ENSEA-Makerspace/FabOS/Stage/Drive/Images/Tableau/20260617_162901.jpg

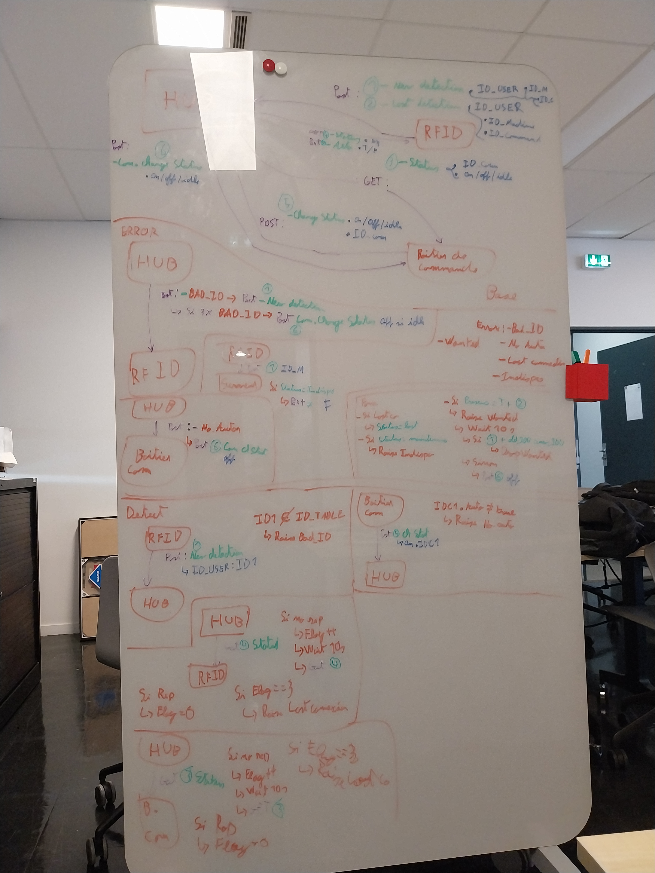
Stage/Drive/Images/Tableau/20260617_162901.jpg
