ENSEA-Makerspace/FabOS/Stage/Drive/Images/Tableau/20260624_091640.jpg

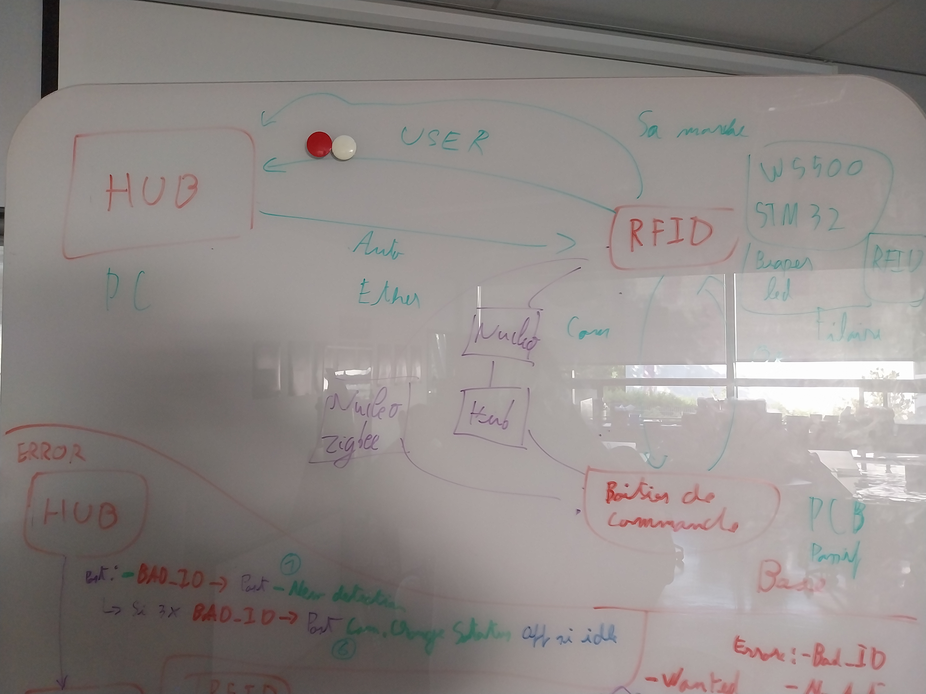
Stage/Drive/Images/Tableau/20260624_091640.jpg
