ENSEA-Makerspace/FabOS/Stage/Drive/intégration-d-une-base-de-données-sql-dans-une-api-php.md

/home/drault/Documents/1G/Stage/FabOS/intégration-d-une-base-de-données-sql-dans-une-api-php.md
