ENSEA-Makerspace/FabOS/FabApp/public/images/machines/demo/CREDITS.md

# Photos de démonstration — crédits

Images sous licence libre, Wikimedia Commons, redimensionnées (1200 px) par Wikimedia.

- `bambu-x1c.jpg` — « Bambu Lab X1 Carbon with AMS module (cropped).jpg », Benlisquare, CC BY-SA 4.0 — https://commons.wikimedia.org/wiki/File:Bambu_Lab_X1_Carbon_with_AMS_module_(cropped).jpg
- `creality-k1.jpg` — « Creality K1C addons.jpg », Mortymore, CC BY 2.0 — https://commons.wikimedia.org/wiki/File:Creality_K1C_addons.jpg
- `presse-a-chaud.jpg` — « Heat press for fabirc screen printing.jpg », Scrud123, CC BY-SA 3.0 — https://commons.wikimedia.org/wiki/File:Heat_press_for_fabirc_screen_printing.jpg
- `station-soudure.jpg` — « Soldering Station 375A+.jpg », Leisto, CC BY-SA 4.0 — https://commons.wikimedia.org/wiki/File:Soldering_Station_375A%2B.jpg
