ENSEA-Makerspace/FabOS/FabApp/docs/references/coordination/README.md

# FabOS — référentiel Coordination et confiance

Complément aux packs Espaces, Utilisateurs, Formations, Équipement et passe globale. Revue et maquettes seulement.

1. `01-calendrier.png` — calendrier multi-ressources filtrable en un clic.
2. `02-rendez-vous-personne.png` — prise de rendez-vous avec un formateur/agent.
3. `03-groupes.png` — groupes et droits collectifs lisibles.
4. `04-mon-badge.png` — badge membre sans exposition d’identifiant sensible.
5. `05-recherche.png` — recherche globale, résultats par type et navigation rapide.
6. `06-preferences-email.png` — préférences e-mail courtes, compréhensibles et sans dark pattern.

Les règles et prompt d’implémentation figurent dans `REVIEW.md`.
