ENSEA-Makerspace/FabOS/FabApp/docs/references/finalsurface/README.md

# FabOS — surfaces finales et garde-fous

1. `01-accueil-configurable.png` — une homepage utile, choisie et composée depuis Design.
2. `02-acces-exceptionnels.png` — accès temporaire explicitement limité, motivé et audité.
3. `03-rapports.png` — rapports qui conduisent vers une action.
4. `04-recuperation-compte.png` — récupération de compte courte et non divulguante.

Voir `REVIEW.md` et le plan maître des références pour la suite d’implémentation.
