ENSEA-Makerspace/FabOS/FabApp/docs/references/productwide/README.md

# FabOS — référentiel global des parcours restants

Ce pack complète les référentiels Formation, Équipement, Espaces et Utilisateurs. Il est de conception uniquement et ne modifie pas FabOS.

## Maquettes

1. `01-evenements.png` — découvrir, s’inscrire, retrouver billet et inscription.
2. `02-prets.png` — circulation de l’objet, fiche cliquable et retour.
3. `03-materiaux-equipement.png` — stock relié à l’équipement et aux machines.
4. `04-maintenance.png` — file d’intervention avec lien machine.
5. `05-configuration.png` — réglages comme point d’entrée cohérent.
6. `06-creations.png` — communauté sobre et utile.
7. `07-kiosque.png` — accueil public réellement lié au thème.

Lire `REVIEW.md` avant l’implémentation : il fixe les invariants transversaux et les travaux prioritaires.
