ENSEA-Makerspace/FabOS/FabApp/docs/references/users/README.md

# FabOS — référentiel parcours Utilisateur

Maquettes de revue uniquement : aucun changement n’a été apporté à FabOS.

## Parcours complet

1. `01-creation-compte.png` — inscription courte, avec les prochaines étapes explicites.
2. `02-confirmation-email.png` — activation, renvoi et correction d’adresse sans impasse.
3. `03-profil-adhesion.png` — compléter uniquement les informations nécessaires et choisir l’adhésion.
4. `04-accueil-membre.png` — accueil membre fondé sur la prochaine action utile.
5. `05-profil-securite.png` — profil, sessions et MFA sans exposer d’informations sensibles.
6. `06-droits-et-acces-admin.png` — droits expliqués par rôle, lieu, formation et durée.
7. `07-validation-inscription.png` — validation staff progressive, justifiable et notifiée.
8. `08-annuaire-utilisateurs.png` — gestion admin avec filtres usuels à un clic.

Voir `REVIEW.md` pour les principes produit, les décisions de droits et le prompt de mise en œuvre.
