ENSEA-Makerspace/FabOS/FabApp/docs/WORKING_BRIEF.md

# Où on en est — 2026-09-07

**Lire ceci en premier.** Une page. Le reste se lit à la demande :

| Besoin | Fichier |
|---|---|
| Ce qui reste à faire | [`ROADMAP.md`](/roadmap) |
| Comment le produit marche, et les pièges | [`PROJECT_STATE.md`](/roadmap) |
| ✅ La revue de sortie de la Phase J, **conclue** | `S149-REVUE.md` |
| ✅ La revue de fin de phase S158/S159, **soldée** | `S159-REVUE.md` |
| Ce qui est livré, phase par phase | [`HISTORY.md`](/roadmap/historique) |
| Modèle cible des droits | [`USAGE_RIGHTS_VISION.md`](/roadmap/droits-usage) |
| Les 52 planches de référence | `/admin/references` (drapeau de développement) |

---

## Position

✅ **QUATRE PHASES CLOSES : J, N, O, P.**
- **J** (2026-09-05) — les 25 défauts de la revue S147 soldés. La barrière du
  commerce tombe.
- **N** (2026-09-05) — le cleanup.
- **O** (2026-09-05) — Machines & boîtiers. Les trois P0 de sécurité, les sept
  états d'un boîtier, la fiche machine séparée en deux publics, la matière
  ramenée à une seule vérité.
- **P** (2026-09-06) — Espaces & accès d'entrée. `AccessPoint` existe : un
  boîtier peut commander une PORTE, plus seulement une machine.

✅ **CINQUIÈME PHASE CLOSE : K — les gabarits d'e-mail** (2026-09-07). Un
exploitant réécrit le texte d'un e-mail, par langue, sans écrire une ligne de
Twig ; l'en-tête et le pied se réécrivent une seule fois pour les vingt ; et
🔴 **une surcharge cassée n'empêche jamais un mot de passe oublié de partir** —
mesuré, avec l'incident journalisé et le journal qui dit quelle version a servi.

✅ **Q — Formations : tout est livré** (2026-09-23). S179 à S183, puis les trois
🅿️ qui restaient : le fil privé (S183b), les types de questions et l'écran de
résultat (S182c/d), les étapes ordonnables (S181b). ⏳ **Reste ta relecture** —
la section « Ce que l'opérateur vérifie » de la Phase Q — avant de clore la phase
et d'en sortir le récit vers `docs/history/`.

## 🔴 Ce qui t'attend, toi

**1. ✅ Plus de migration en attente.** `Version20260907090000` a été lancée le
2026-09-07 et le service redémarré : 65 sur 65, aucune nouvelle. La colonne
`EMAIL_LOG.renderedFrom` est écrite — vérifié par
`app:s162:layout-probe --log-write`, qui insère une ligne marquée, la relit et la
supprime. ⚠️ Les 126 mails déjà partis affichent « avant le suivi » : le prochain
envoi sera le premier renseigné.

**2. Une revue à faire.** Chaque phase porte une section **« Ce que l'opérateur
vérifie »** dans `ROADMAP.md` : où regarder, et quoi voir. C'est ta demande du
2026-09-05, et une session qui ne produit rien de constatable à l'écran n'y a
pas de ligne.

**3. Une chose qu'il te reste à poser** : `FABOS_RFID_API_TOKEN` dans le
`.env.local` de CT 210. Sans elle, l'API des boîtiers refuse TOUT appel (S171,
et c'est juste) — `/admin/rfid-readers` le dit maintenant en toutes lettres.

**4. Une ligne de revue ouverte** : sur `/places`, la pastille d'une salle
occupée doit dire « Libre à 14:00 ». Non mesurée — à 01h30 le labo est fermé et
la branche « fermé » gagne, correctement. À regarder un jour ouvré.

🅿️ **Deux phases écrites le 2026-09-04, à faire :** **L** — annoncer un événement
aux membres (S163–S164) ; **M** — les thèmes en profondeur (S165–S168). Les deux
sont dans `ROADMAP.md`, chacune avec ce qui existe DÉJÀ (mesuré dans le dépôt),
la tension à trancher, et ce qu'on mesure par session.
🔴 La première vient du dépouillement de Fabmanager (`FABMANAGER-ECARTS.md`) ; la
seconde reprend un chantier qui traînait sans plan. **K, la troisième, est
close.**

✅ **Phase S153 livrée le 2026-08-31.** Les quatre chantiers sont faits — la
saisie des packages (le compilateur, la case « sans limite d'horaires », la
sonde), le regroupement par mois de `/events`, les six affiches de remplacement
sur les vraies cartes, la bande du tableau de bord qui porte un fait. Les trois
propositions ont été **supprimées** du guide de style, avec la sous-page et sa
route. Détail → `history/phase-S153-saisie.md`.

🔴 **Une décision opérateur est SORTIE de cette phase, et elle est neuve :**
`USAGE_PACKAGE.fullAccess` veut désormais dire « aucune restriction, horaires
compris », et il est lu par les **deux** modèles de droits — il ne l'était que
par la v1. Sur la boîte, « Accès complet » porte déjà ce bit : ses porteurs
gagnent la réservation hors grille hebdomadaire (jamais hors d'une fermeture
datée). C'est le cas n°1 de la liste de l'opérateur, mais c'est un
**élargissement d'accès** — à confirmer package par package.

✅ **Phases S158 & S159 LIVRÉES, revue de fin de phase SOLDÉE le 2026-09-03.**
Les groupes sont la seule source des rôles et des forfaits ; les six points de la
revue (R1 à R6) sont appliqués. Détail → `history/phase-S158-S159-groupes.md` et
`S159-REVUE.md`.

🅿️ **Et une revue de DESIGN a suivi, sur `/admin/usage-rights/{id}/edit`**
(demande opérateur, 2026-09-03), qui a trouvé plus qu'un problème d'apparence :
- 🔴 **le résumé en tête de page était une chaîne FIXE** — « donne accès à tout,
  tout le temps, partout, sans limite » sur les quatre forfaits, OpenLab compris,
  qui ouvre en réalité deux fonctionnalités le jeudi de 13:30 à 21:00. Il est
  maintenant calculé depuis le spec décompilé, et posé sur la ligne de chaque axe ;
- 🔴 **l'attribution a déménagé sur la fiche du GROUPE** — un forfait DÉFINIT des
  droits, un groupe dit QUI les a. ⚠️ Vérifié avant de retirer : la fiche du groupe
  savait seulement les COMPTER, donc l'autre côté a été construit d'abord ;
- 🔴 **les suppressions de droits n'apparaissent que si la carte de saisie REFUSE
  le forfait.** Sinon elles ne défont rien : la sauvegarde suivante réécrit. Les
  deux branches sont mesurées, grant `manage` inséré puis retiré ;
- ⚠️ **`color-scheme` n'avait que sa moitié sombre**, donc en thème clair sur un OS
  sombre le navigateur peignait TOUS les champs du site en sombre. Corrigé dans
  `style.css`, une ligne, tout le site.

🅿️ **Phase S158 ouverte le 2026-09-01 — les étapes 1 à 3 sont LIVRÉES.** `/admin/groupes`
existe : on peut enfin créer un groupe et y mettre quelqu'un, ce que rien ne
permettait, la fiche d'un membre montre ses groupes, et le backfill a écrit les
11 lignes que les rôles produisaient déjà — sans changer une seule réponse, ce
que la commande vérifie et annulerait sinon.
🅿️ **Et une phase S159 est écrite, à faire demain** : *les forfaits ne
s'attribuent qu'à des GROUPES*, plus le **nettoyage** des maquettes qui restent à
l'écran (idée de l'opérateur, 2026-09-01) — voir `ROADMAP.md`. ✅ Viable : les
quatre chokepoints sont sur grants v2, donc le chemin groupe est vivant.
✅ **Et l'opérateur a réglé l'objection du commerce** : ce qui se vend n'est pas un
forfait attribué à quelqu'un, c'est **une appartenance datée à un groupe**. Un
seul chemin pour tout le monde, humains et machines, et l'expiration devient le
mécanisme au lieu d'un obstacle.
✅ **Et appartenir à PLUSIEURS groupes marche déjà** : acheter le week-end ET le
jeudi soir, c'est deux groupes, deux lignes, les deux droits — le lecteur compare
l'attribution à toutes les clés de la personne.
🔴 **La difficulté se déplace dans le SCHÉMA, et elle est étroite** : la clé
primaire `(groupId, userId)` empêche **deux raisons simultanées d'être dans le
MÊME groupe** — ajouté à la main *puis* acheté, ou renouvelé avant la fin. ✅ **Tranché par l'opérateur le 2026-09-02** : une seule ligne dont on repousse la
date, plus un **journal** de chaque modification — donc **aucun contract**, tout
est additif (deux colonnes de dates, une table de journal).
🔴 **À la condition que la ligne soit DÉRIVÉE du journal**, jamais éditée en
place : sinon deux vérités, et c'est la ligne qui décide pendant que le journal a
l'air juste.
⚠️ Et la durée appartient à l'OFFRE, pas au forfait : sinon le même groupe ne peut
pas se vendre au mois ET à l'année.

🅿️ **Et la décision du « contract » est peut-être sans objet** : l'opérateur
propose que le RÔLE DEVIENNE un groupe non supprimable (2026-09-02). Les cinq
intégrés *sont* déjà les rôles, donc la fusion ne crée rien — elle retire un
doublon, et `AudienceResolver` retombe à deux sources.
🔴 **Mais le coût est sur le chemin de la SÉCURITÉ** : `getRoles()` lit une
relation Doctrine, et `USER_GROUP` n'est **pas une entité**. Et surtout, la garde
du dernier admin s'exprime en `getRoles()` et protège l'anonymisation, **pas le
retrait d'un groupe** : après la fusion, retirer le dernier membre du groupe
`admin` verrouillerait l'installation. **Cette garde se pose AVANT.** Détail et
ordre dans `ROADMAP.md` § S159. Plan complet dans `ROADMAP.md` § « Phase S158 ».
✅ Le mot est fait aussi : « package » → **forfait / bundle**.
🅿️ Deux décisions y attendent encore l'opérateur : quelles extensions de groupe
(appartenance datée, groupes à règle), et ce que devient le lien rôle→groupe
après le contract.

🅿️ **La revue de fin de phase est faite** (`S159-REVUE.md`) : **R1 corrigé sur
place** — on ne pouvait plus retirer personne d'un groupe intégré, et la mention
« par son rôle » était devenue fausse. **R2 à R6 attendent une décision** : l'action
principale de la fiche d'un forfait est repliée ; une date se met à deux endroits ;
« dont N inscrits ici » ne dit plus rien ; deux contrôles pour le même fait sur la
fiche d'un membre ; et le nouveau modèle coûte 3 écrans au lieu d'1 pour un cas
unique.

**Décisions opérateur toujours en attente :**
- 🔴🔴 **J-25** — aucun membre ne peut réserver (voir plus bas). ⚠️ À réexaminer
  à la lumière de ce qui précède : un package `fullAccess` sans grants
  n'autorisait rien sous la v2, ce qui est exactement cette forme de panne.
- ⚠️ **R5** de la passe navigateur — deux mots pour le même état de machine.

**Phase J : close sur ce qui se voit.** La revue de sortie `S149-REVUE.md` est
conclue, R1 → R9 sont faits sauf R5/R6 qui sont des décisions.

## État du dépôt

- Branche **`s129/venues-workspace`**. ⚠️ **190 commits d'avance sur
  `origin/main`** — la fusion vers `main` n'a pas eu lieu et reste une décision de
  l'opérateur.
- Déployé et vérifié par hachage sur CT 210, services redémarrés, site 200.
- Cache-buster CSS courant : `?v=20260831-s153b`.
- ✅ **Aucune migration en attente** (61/61).
- ✅ **Jouée le 2026-09-02 : `Version20260902160000`** — l'appartenance
  DATÉE : deux colonnes nullables sur `USER_GROUP_MEMBER`. ✅ Purement additive,
  et le code est **déjà déployé et tolérant** : `UserGroupSchema` sonde les
  colonnes, et sans elles une appartenance est sans limite — le comportement
  d'aujourd'hui. Vérifié avant la migration : les écrans et les annuaires rendent
  exactement les mêmes nombres.
  🔴 `NULL` vaut **sans limite des DEUX côtés** : un filtre qui prendrait les
  onze lignes du backfill (sans dates) pour expirées retirerait `staff`, `admin`
  et `trainers` à tout le monde. La clause est écrite UNE fois, dans
  `UserGroupSchema`.
  ⚠️ Une appartenance au groupe `admin` **ne peut pas expirer** : la garde du
  dernier administrateur juge une écriture, elle ne peut rien contre l'horloge.
  ⚠️ La section 7 de `app:s153:package-probe` se saute tant que la migration
  n'est pas jouée, et le dit ; après, elle mesure les quatre cas.

- ✅ **Jouée le 2026-09-02 : `Version20260902100000`** — elle supprime
  `UTILISATEUR_ROLE`. Le code déployé ne lit plus cette table : les rôles
  viennent des groupes. La migration est donc une étape de CONTRACT, à jouer
  APRÈS le code, ce qui est le cas.
  ✅ Vérifié avant de l'écrire, personne par personne : `admin` {1,3,4,5,7,9},
  `staff` {5,7}, `trainer` {5,7,9} identiques des deux côtés ; les deux lignes de
  rôle `user` n'ont pas d'équivalent et n'en ont pas besoin (`ROLE_USER` est
  accordé sans ligne).
  ✅ Son `down()` **reconstruit** les lignes depuis les groupes. Vérifié après
  coup : `/formateurs` et `/equipe` rendent les bonnes personnes, `/admin` se
  rend en administrateur, 107 routes à 200.
- 🔴 **L'agent ne peut ni migrer, ni `git push`** : donner la ligne à l'opérateur.
- ✅ **Déployé et vérifié par hachage sur CT 210 le 2026-08-27**, deux fois :
  la passe navigateur (112 fichiers, balayage de 106 pages) puis la paire D
  (**115 fichiers identiques**, `lint:twig` 211/0, `lint:yaml` 39/0, `php -l`
  propre, **balayage de 171 pages sans échec**, service redémarré).
  La redirection de `/profil` est vérifiée en **https**.
  🔴 **SSH : DEUX chemins, et selon le réseau un seul des deux marche.** Mesuré le
  2026-08-24 sur deux réseaux, avec des résultats exactement inverses :

  | | `proxmox.lab.dryades.org` | `51.68.38.235` (IP) |
  |---|---|---|
  | réseau A | 🔴 ne résout pas | ✅ marche |
  | réseau B | ✅ marche (→ 192.168.100.1) | 🔴 expire |

  ⚠️ **Donc : essayer les DEUX avant de conclure que l'accès est perdu.** Croire le
  premier échec a coûté une demi-session — j'ai écrit une revue entière « sans
  accès » alors que l'autre chemin répondait. ⚠️ `artemis.dryades.org` échoue la
  vérification de clé d'hôte sur les deux réseaux ; ce n'est jamais le bon nom.
- ⏭️ **À pousser** : `git push` sur la branche. Vérifier avec `git status -sb`
  plutôt que de croire cette ligne.

## Les règles de travail

- **Une source de changement.** Si plusieurs pages ont besoin du même
  comportement ou du même dessin, on étend la source partagée — on ne copie pas.
- **Un seul design system.** `/admin/design` est la référence. Un motif récurrent
  y va, pas dans le `<style>` d'une page.
- **Le chemin honnête le plus court gagne.** Moins de clics, moins de choix.
  **Jamais un contrôle qui ne fait rien.**
- **Une session n'est pas finie en local** : doc, commit, déploiement des fichiers
  choisis sur CT 210, **et vérification du résultat qui tourne là-bas**.
- 🔴 **Le balisage rendu n'est pas une vérification visuelle.** Pour une
  affordance, une géométrie ou un contraste : mesurer dans un navigateur.
- **Revue de fin de PHASE**, une fois, mandat « designer d'Apple » : clics avant /
  après, évidence du chemin, frappes — **surtout en cas d'erreur** — et tout champ
  demandé sans être indispensable. Lui donner les **URLs et parcours**, pas le diff.

## Les sept pièges qui reviennent

1. 🔴 **`x|default(true)` est TOUJOURS vrai si on passe `false`** — Twig déclenche
   `default` sur toute valeur *vide*. **Deux fois livré ici.** Écrire
   `x is not defined or x`.
2. 🔴 **Une colonne ORM mappée exige sa migration AVANT le code.** Aucune
   dégradation possible : toute requête la sélectionne, la table entière fait 500.
3. 🔴 **Masquer n'est pas refuser.** Un objet archivé sort des surfaces qui le
   *proposent* **et** `ReservationService` le refuse au point de passage unique.
4. ⚠️ **`php -l` vert ne dit rien du conteneur** (un `use` manquant sur un
   paramètre de contrôleur = 500). **Un nouveau filtre Twig exige `cache:clear`
   AVANT `lint:twig`.**
5. ⚠️ **Un flash porte une CLÉ, pas une phrase.** Une clé inconnue traverse
   inchangée — ne pas « corriger » ça en levant une exception.
6. ⚠️ **`booking: false`** rend le composant calendrier lecture seule. C'est tout
   le mécanisme.
7. ⚠️ **`prod` n'a pas `strict_variables`** : une variable que le contrôleur ne
   passe pas est silencieusement `null`. Le lint ne le voit pas.

## Checklist de fin de session

1. Mettre à jour la doc concernée — **et sortir de `ROADMAP.md` ce qui est livré.**
2. Lint (`lint:twig`, `lint:yaml`, `php -l`) et **lire la sortie**.
3. Commit.
4. Déployer une archive **étroite** sur CT 210, `cache:clear`, restart.
5. Vérifier le résultat **qui tourne**, et écrire ce qui a réellement été vérifié.
