ENSEA-Makerspace/FabOS/FabApp/docs/references/REVUE-UX-2026-09-06.md

# Revue UX — FabOS face aux 52 planches

**Date** : 2026-09-06. **Portée** : lecture seule, aucun fichier du produit touché.
**Matériel lu** : les 52 PNG de `public/images/references/`, les 13 documents de
`docs/references/`, `docs/ROADMAP.md`, `templates/site/**`, `public/css/**`,
`src/Nav/NavBuilder.php`, `src/Rfid/`, `src/Controller/`.

⚠️ **Règle appliquée** : une planche parle de PRÉSENTATION DE CONTENU. Rien ici ne
tire une couleur, une typographie, un chrome ou une identité d'une maquette. Toute
proposition ci-dessous est l'évolution d'un composant existant, nommé.

⚠️ **Ce n'est pas une liste de tâches.** C'est un tri.

---
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
