ENSEA-Makerspace/FabOS/Stage/Drive/Images/Ecrans/20260617_162909.jpg

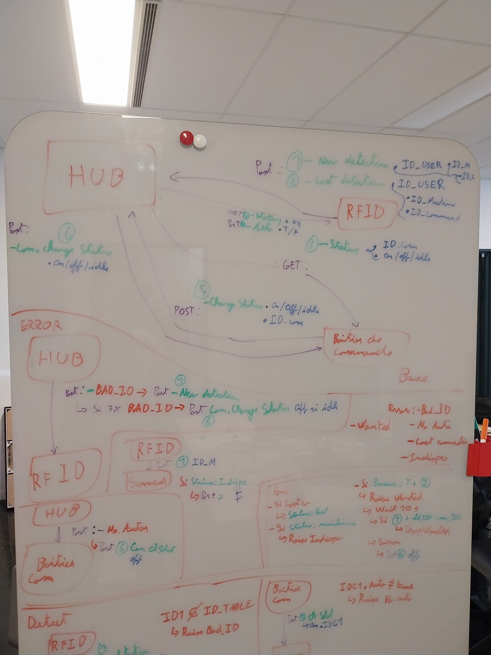
Stage/Drive/Images/Ecrans/20260617_162909.jpg
