ENSEA-Makerspace/FabOS/Stage/Drive/Images/Ecrans/1000221710.jpg

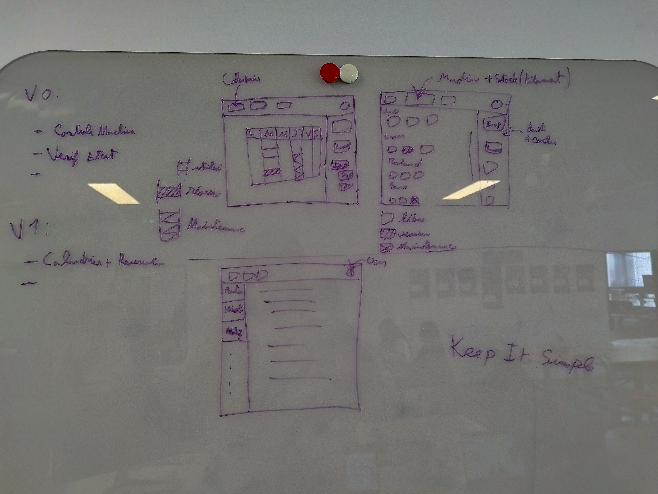
Stage/Drive/Images/Ecrans/1000221710.jpg
