ENSEA-Makerspace/FabOS/Stage/Drive/Images/Ecrans/1000221712.jpg

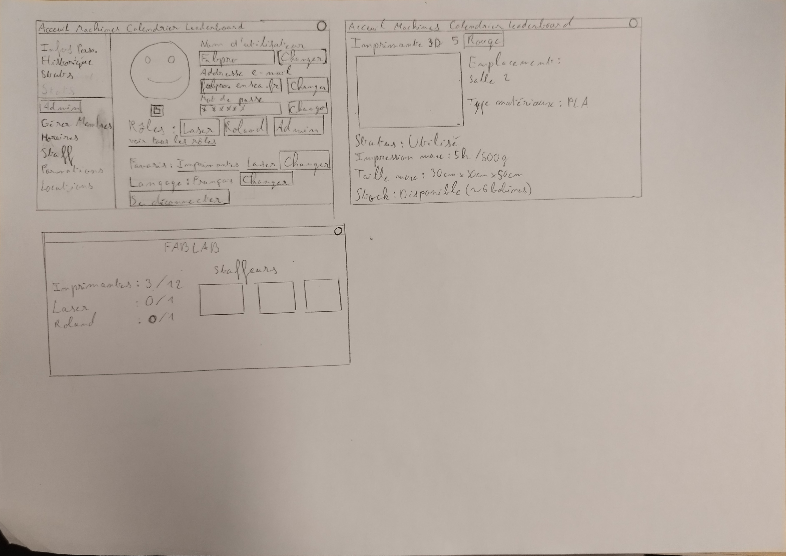
Stage/Drive/Images/Ecrans/1000221712.jpg
