ENSEA-Makerspace/FabOS/Stage/Drive/Images/Ecrans/1000221713.jpg

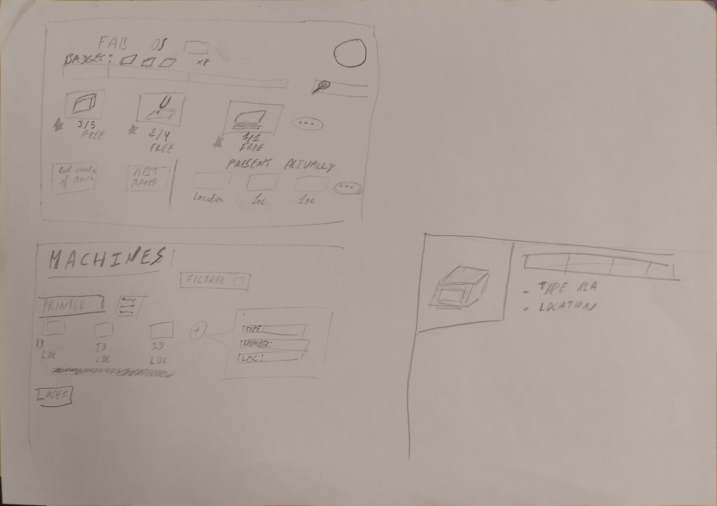
Stage/Drive/Images/Ecrans/1000221713.jpg
