ENSEA-Makerspace/FabOS/Stage/Drive/Images/Ecrans/1000221714.jpg

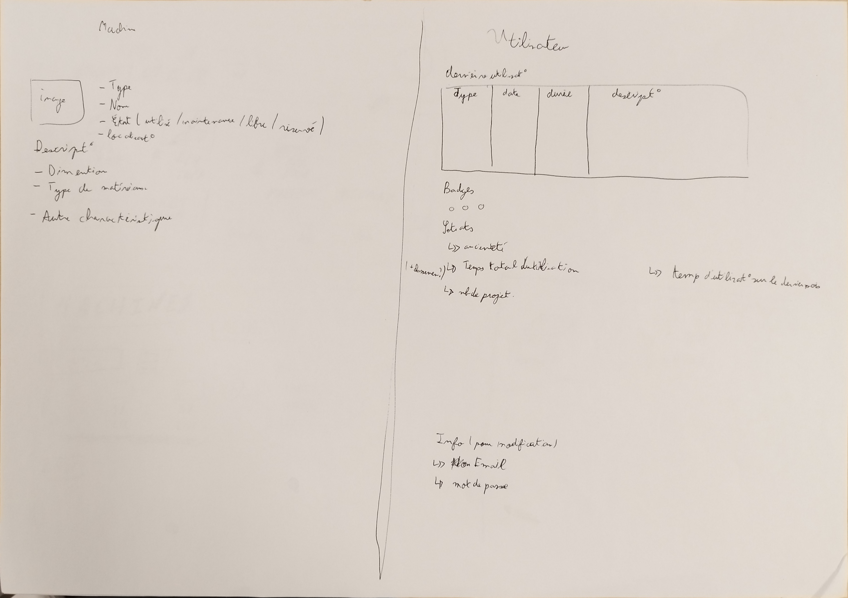
Stage/Drive/Images/Ecrans/1000221714.jpg
