ENSEA-Makerspace/FabOS/Stage/Drive/Images/Ecrans/1000221716.jpg

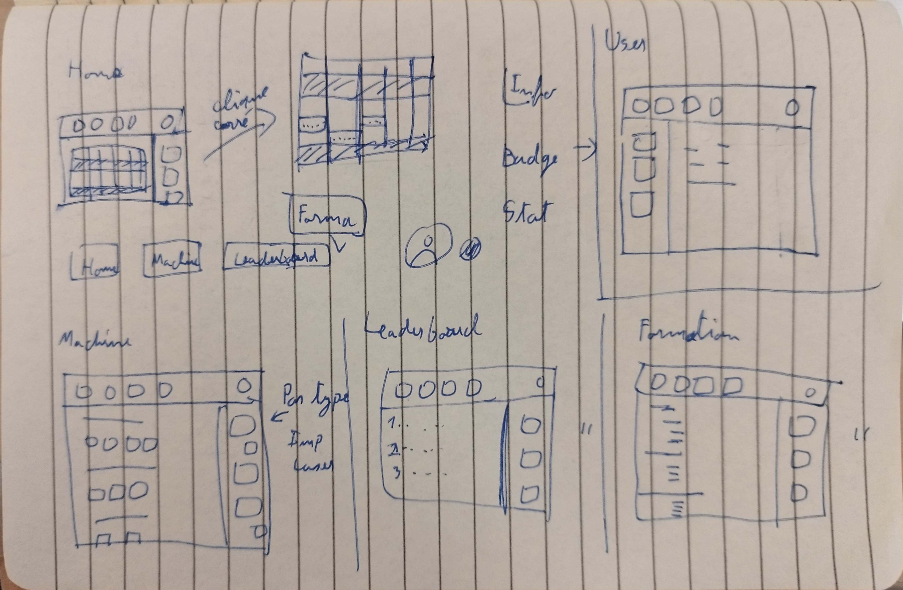
Stage/Drive/Images/Ecrans/1000221716.jpg
