ENSEA-Makerspace/FabOS/Stage/Drive/Images/Ecrans/unnamed.jpg

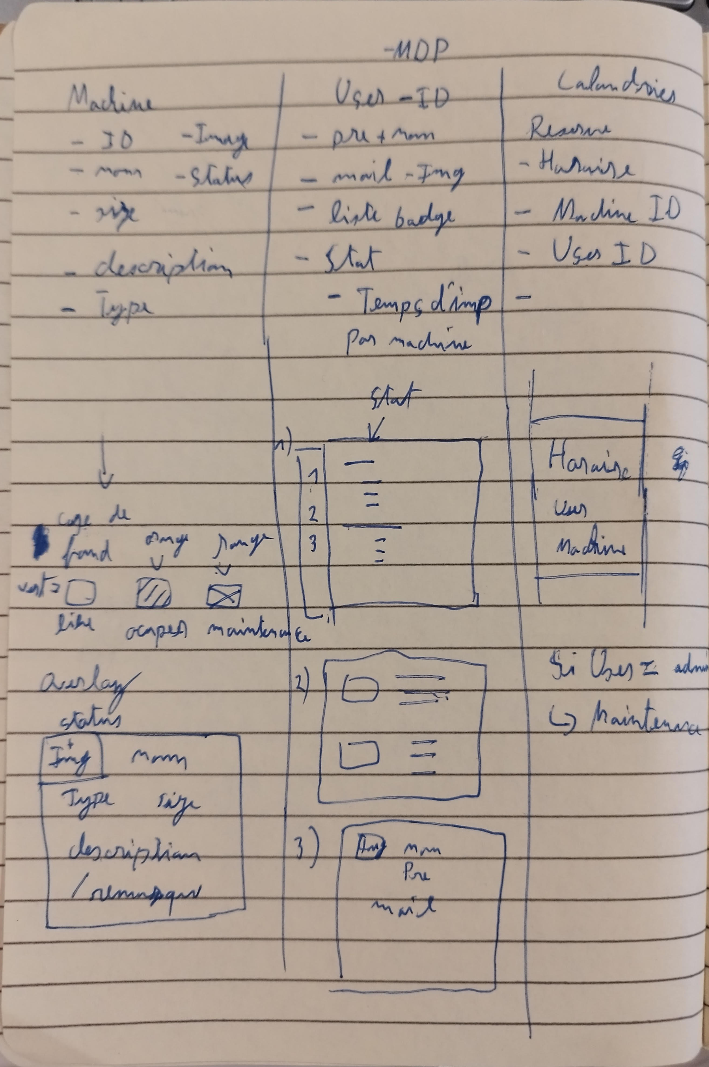
Stage/Drive/Images/Ecrans/unnamed.jpg
