ENSEA-Makerspace/FabOS/Stage/Drive/Images/Fabman UI/Screenshot 2026-07-30 at 16.20.04.png

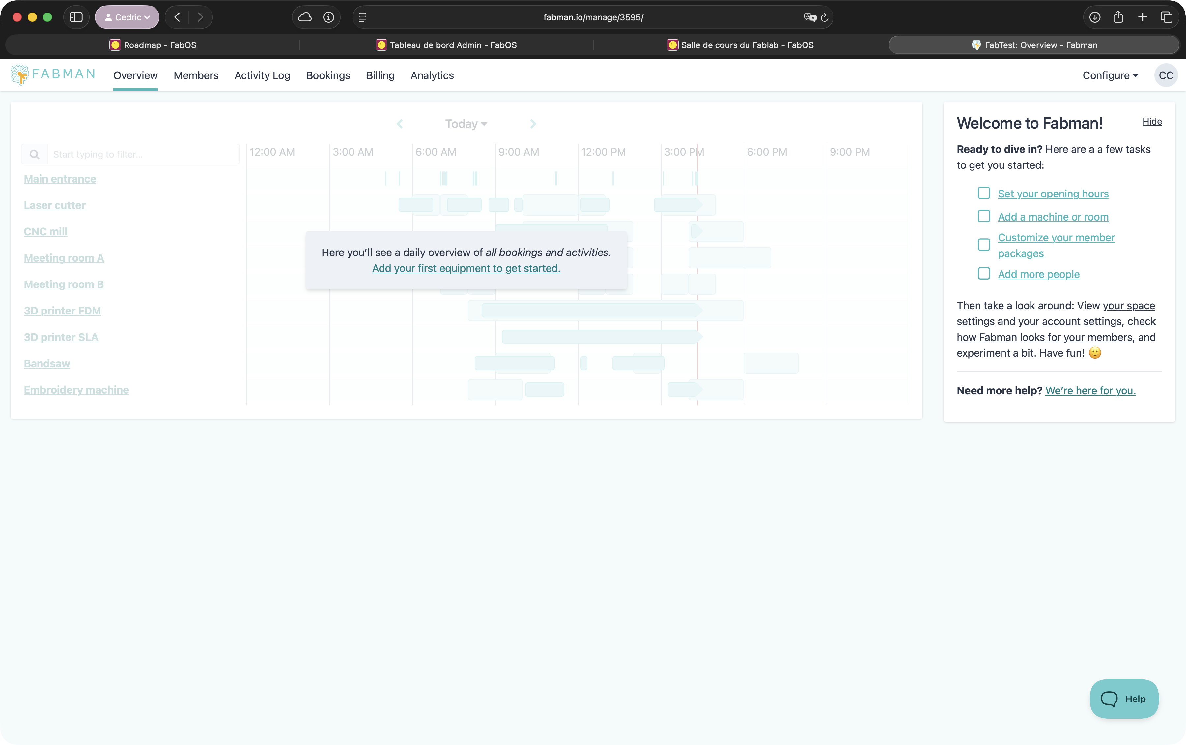
Stage/Drive/Images/Fabman UI/Screenshot 2026-07-30 at 16.20.04.png
