ENSEA-Makerspace/FabOS/Stage/Drive/Images/Fabman UI/Screenshot 2026-07-30 at 16.24.44.png

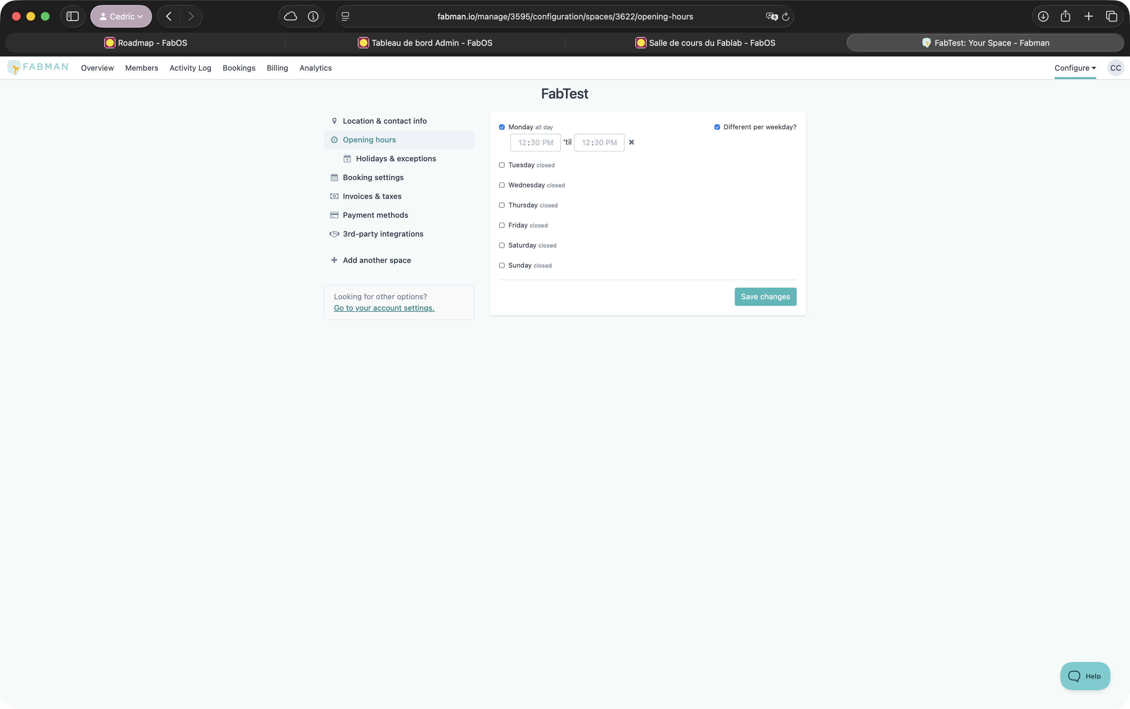
Stage/Drive/Images/Fabman UI/Screenshot 2026-07-30 at 16.24.44.png
