ENSEA-Makerspace/FabOS/Stage/Drive/Images/Tableau/20260617_110406.jpg

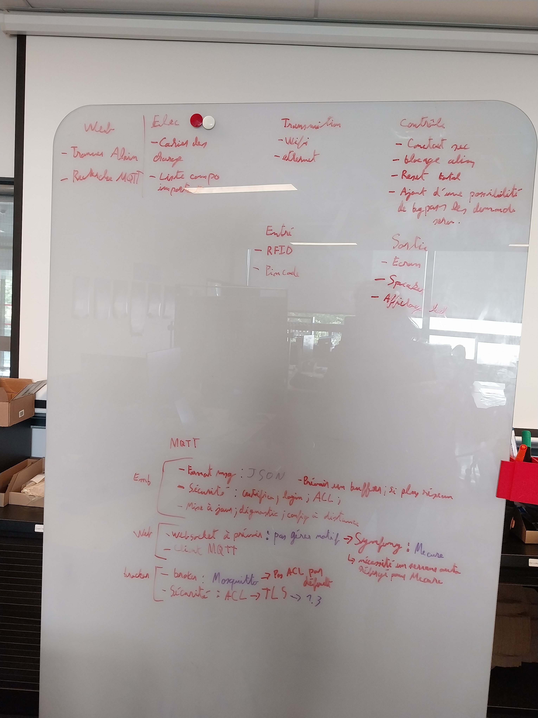
Stage/Drive/Images/Tableau/20260617_110406.jpg
