ENSEA-Makerspace/FabOS/Stage/Drive/Images/Tableau/20260617_142830.jpg

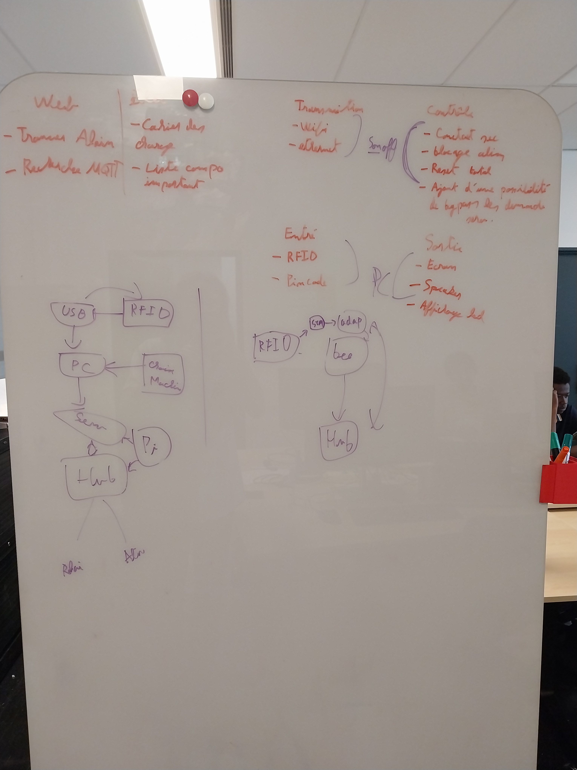
Stage/Drive/Images/Tableau/20260617_142830.jpg
