ENSEA-Makerspace/FabOS/Stage/Drive/Images/Tableau/20260624_155851.jpg

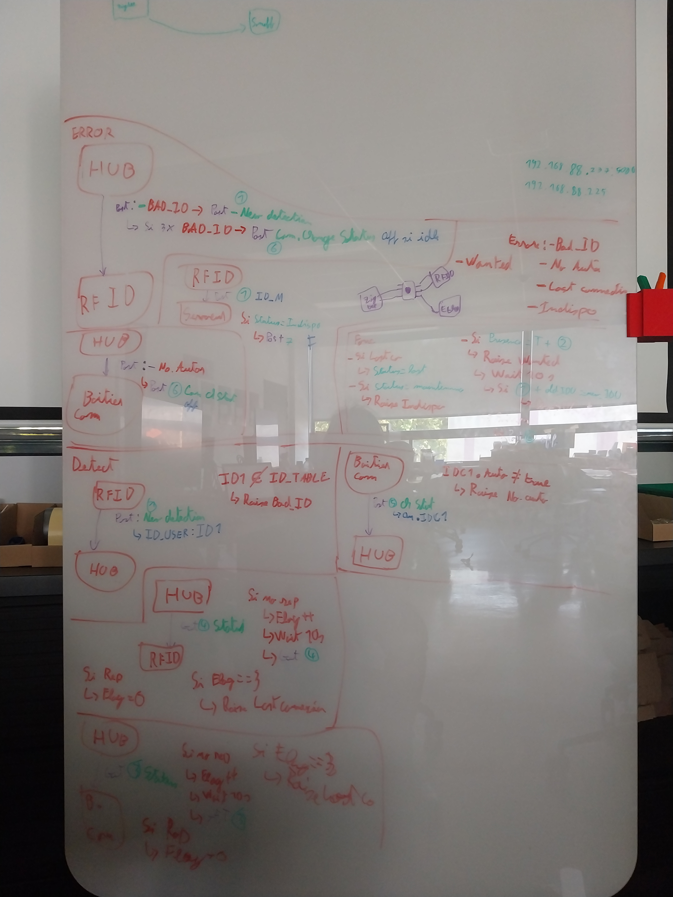
Stage/Drive/Images/Tableau/20260624_155851.jpg
