ENSEA-Makerspace/FabOS/Stage/Drive/Images/Tableau/1000022212(1).jpg

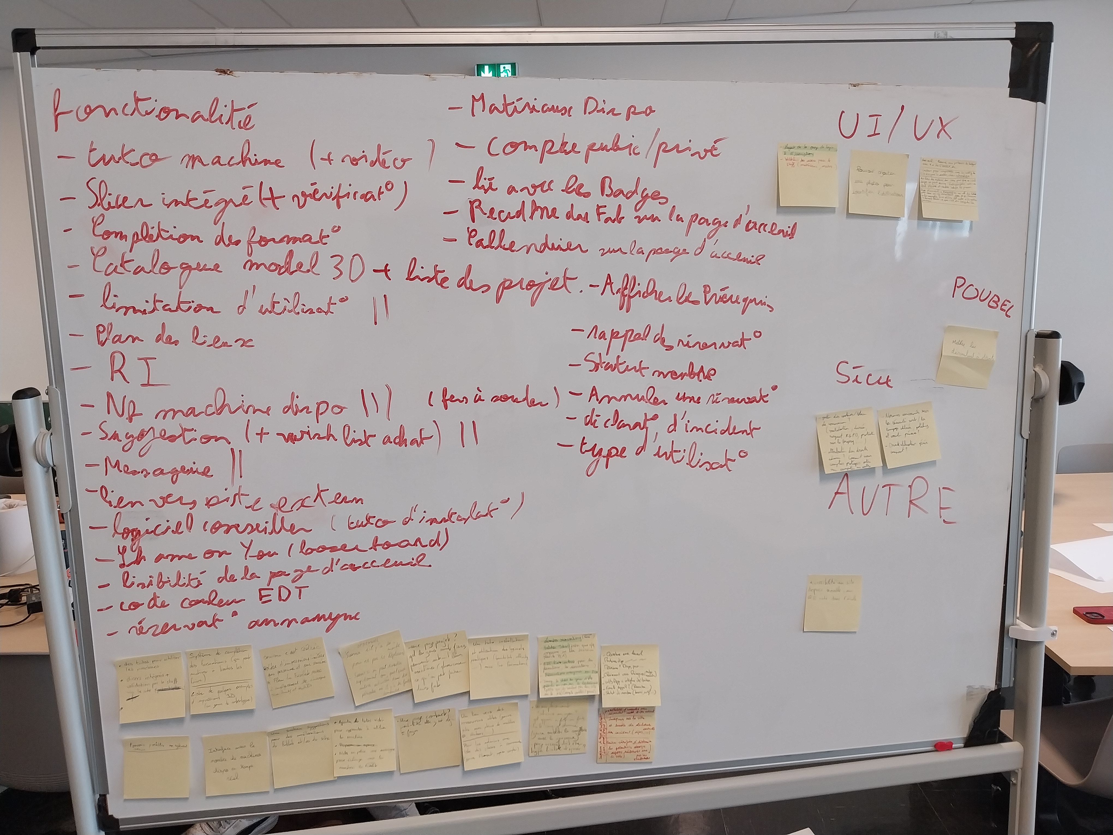
Stage/Drive/Images/Tableau/1000022212(1).jpg
