ENSEA-Makerspace/FabOS/Stage/Drive/Images/Tableau/1000022250.jpg

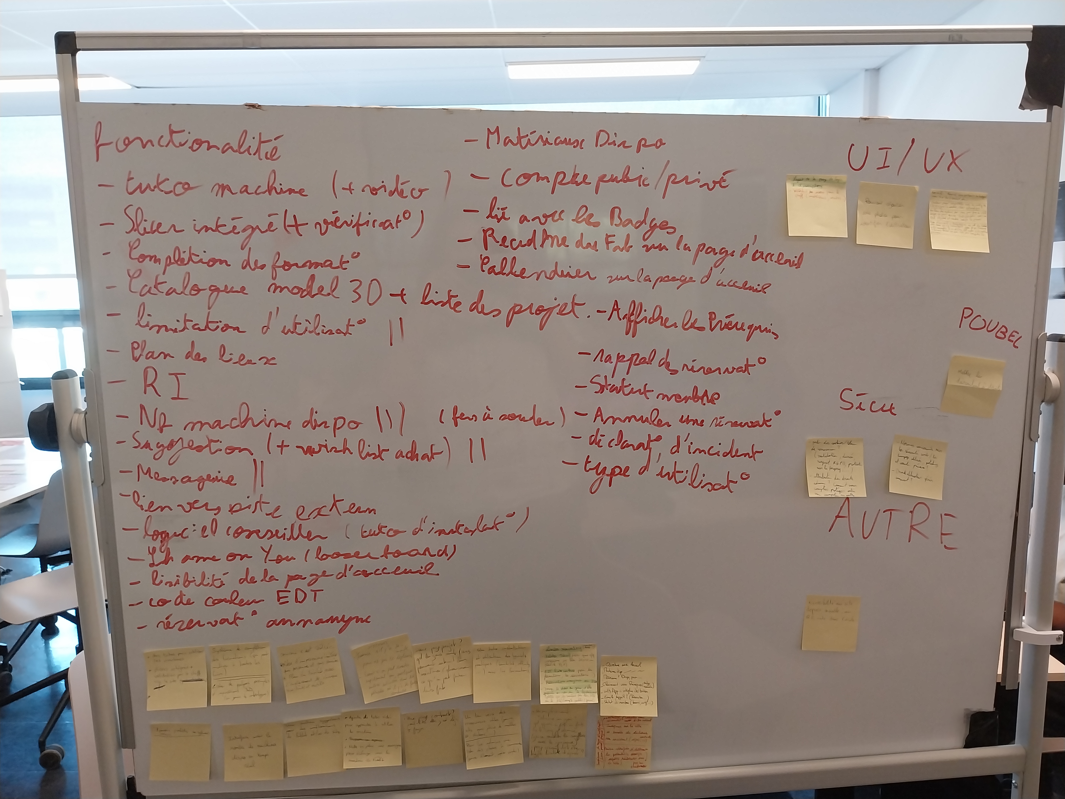
Stage/Drive/Images/Tableau/1000022250.jpg
