ENSEA-Makerspace/FabOS/Stage/Drive/Images/Tableau/1000022251.jpg

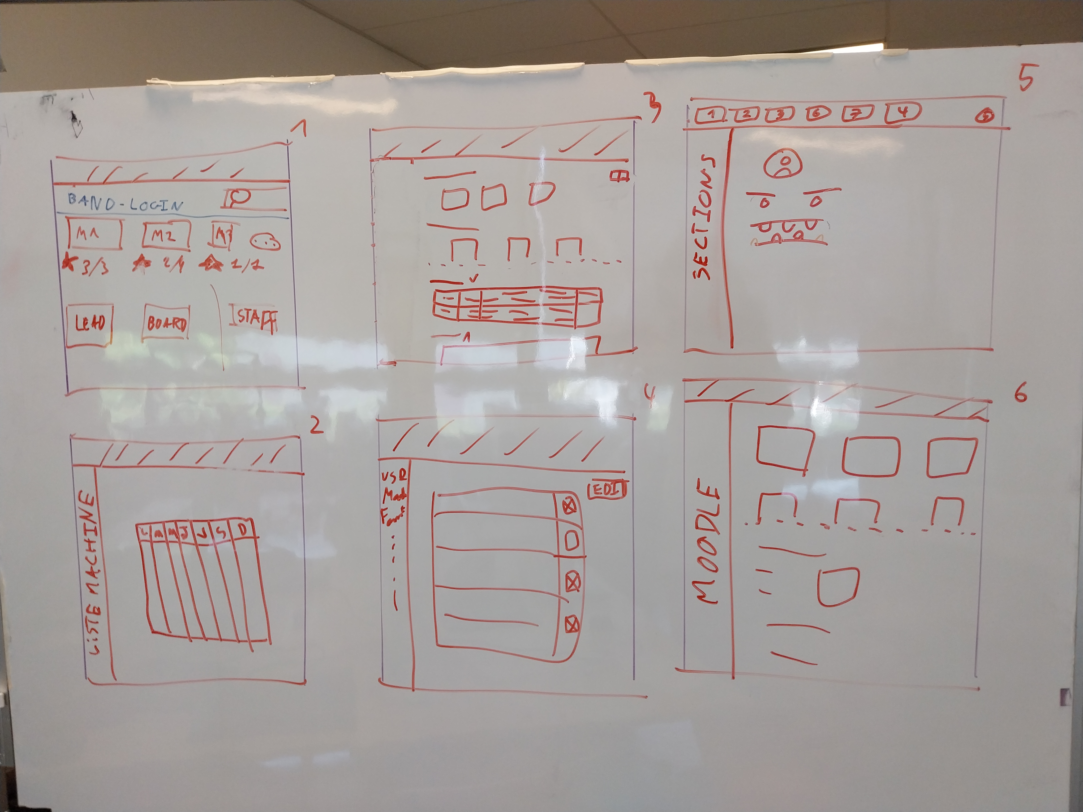
Stage/Drive/Images/Tableau/1000022251.jpg
