ENSEA-Makerspace/FabOS/Stage/Drive/Images/Tableau/IMG_20260618_154138.jpg

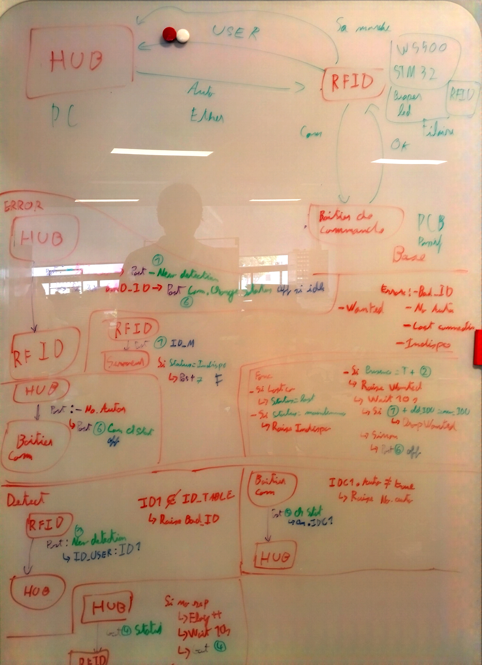
Stage/Drive/Images/Tableau/IMG_20260618_154138.jpg
