ENSEA-Makerspace/FabOS/Stage/Drive/Images/Tableau/IMG_20260618_154143.jpg

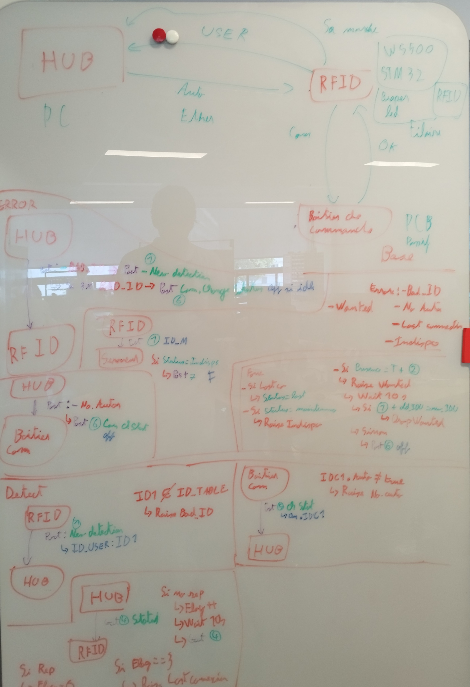
Stage/Drive/Images/Tableau/IMG_20260618_154143.jpg
