ENSEA-Makerspace/FabOS/Stage/Drive/Images/Tableau/IMG_20260625_152844.jpg

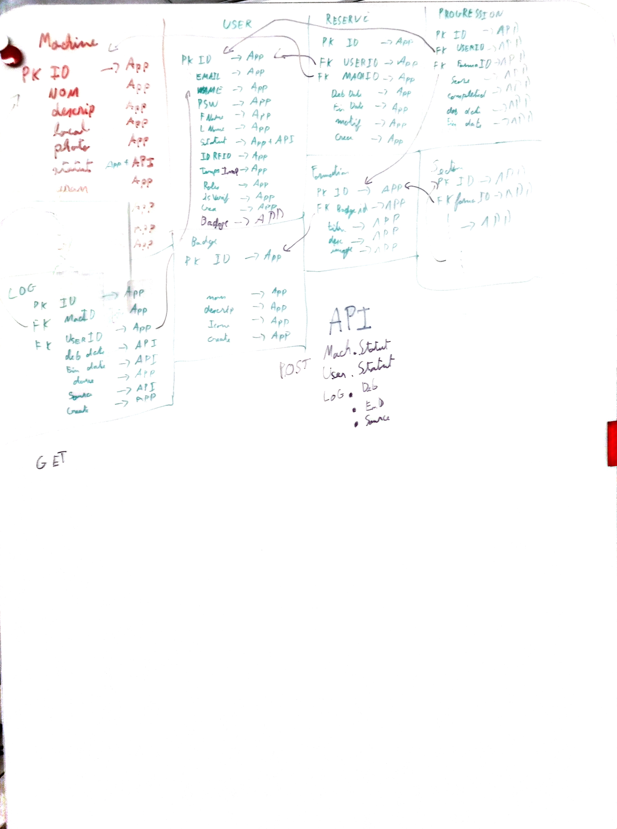
Stage/Drive/Images/Tableau/IMG_20260625_152844.jpg
