ENSEA-Makerspace/FabOS/Template-html/site-html/images/hero-bg.jpg

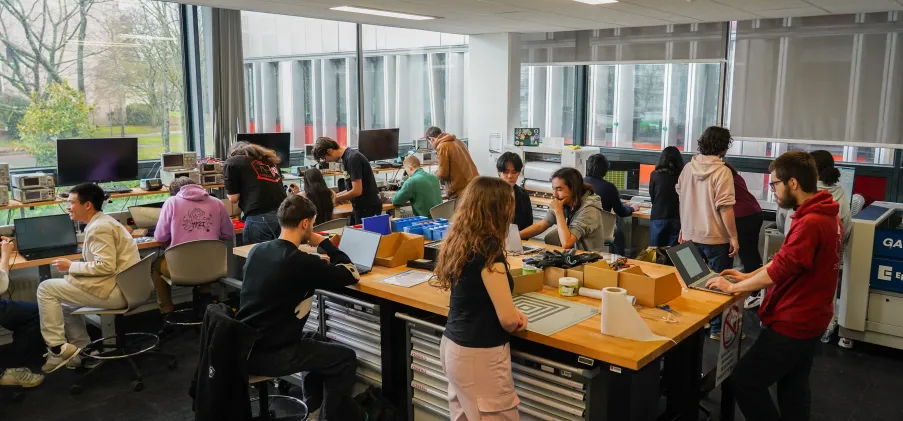
Template-html/site-html/images/hero-bg.jpg
