ENSEA-Makerspace/FabOS/Boitier/BoitierFabos.3mf

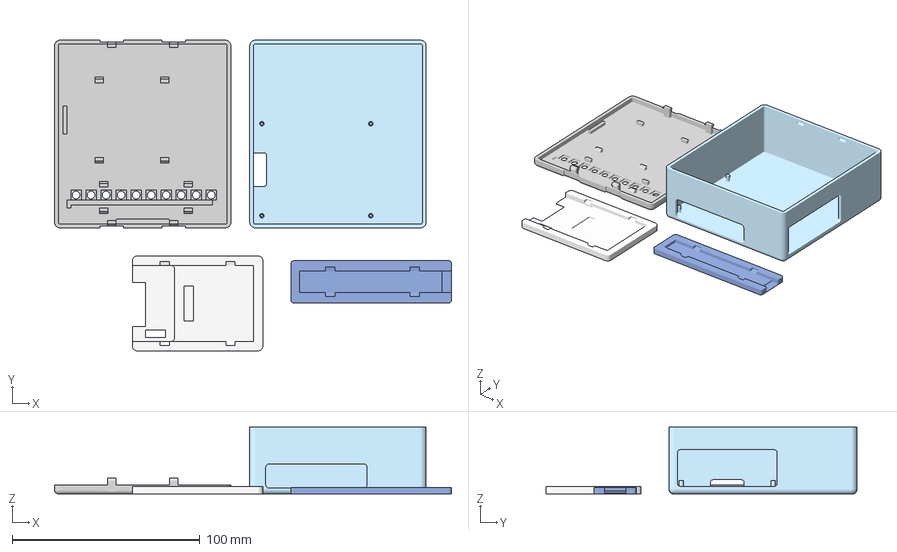
[picture p69: CAD file, 2026-07-09]
Boitier/BoitierFabos.3mf
211.5 x 165.5 x 35.5 mm
