ENSEA-Makerspace/FabOS/FabApp/public/downloads/meilleure-impression-fabapp.3mf

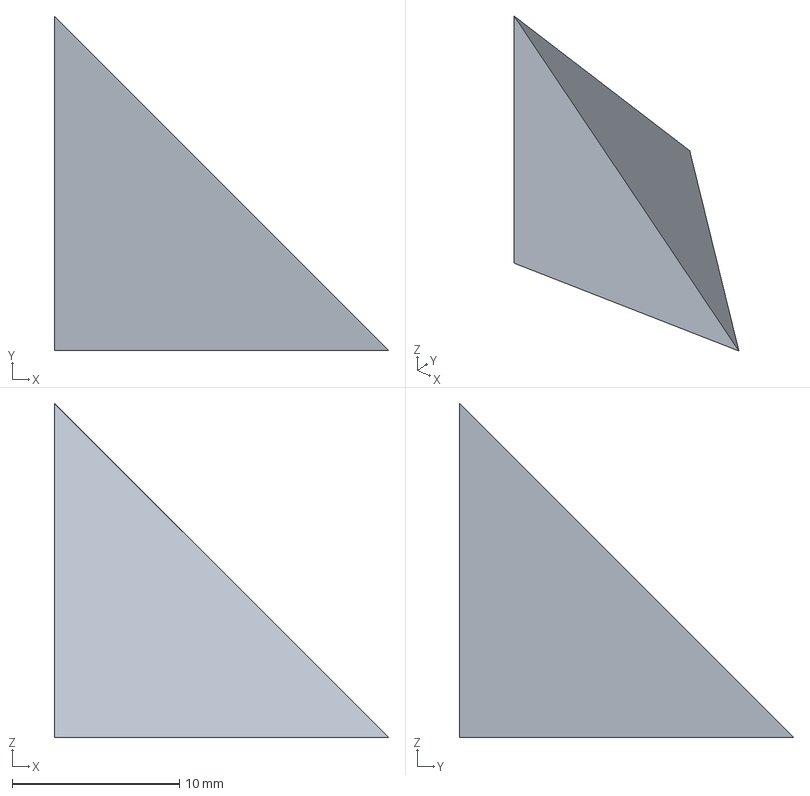
[picture p70: CAD file, 2026-07-09]
FabApp/public/downloads/meilleure-impression-fabapp.3mf
20.0 x 20.0 x 20.0 mm
