ENSEA-Makerspace/FabOS/(list of files, cad)

Other CAD files:
Boitier/BoitierFabos.stl
