ENSEA-Makerspace/FabOS/FabApp/docs/USAGE_RIGHTS_VISION.md

# FabOS multi-lieux, droits et réseau — vision cible

**Statut :** décisions produit approuvées · **une grande partie du modèle des droits est CONSTRUITE et en service** · **Mise à jour :** 2026-09-03

Ce document remplace la vision S100–S101 qui associait encore les packages et certains scopes aux portails.

🔴 **Il ne dit plus « à construire » partout, et c'est le point de cette mise à
jour.** Écrit le 2026-08-09 comme une cible, il a été lu ensuite comme si tout y
restait futur — alors que les groupes, les grants v2 et l'enforcement sont en
service. Un document de vision qui décrit comme à venir ce qui tourne déjà est la
même famille de défaut que les écrans que ce projet passe son temps à ranger :
**deux vérités, dont la plus visible est la périmée.**

⚠️ **Ce qui suit est mesuré sur la boîte, pas déduit du plan.** Ce qui n'est pas
listé comme construit ne l'est pas.

---

## Ce qui est CONSTRUIT, et les trois décisions qui ont CHANGÉ

### ✅ Construit et en service (mesuré le 2026-09-03)

- **Les groupes existent, s'écrivent et décident.** `/admin/groupes` crée, renomme,
  supprime ; la fiche d'un membre et celle du groupe sont deux VUES du même dépôt.
  Sur la boîte : **7 groupes intégrés** (`admin`, `manager`, `staff`, `superuser`,
  `trainers`, plus `user` et `guest` **virtuels**) et 4 groupes libres.
- **Les audiences `user` et `guest` sont résolues, jamais stockées** — exactement
  ce que la décision 7 demandait.
- **Le dernier administrateur ne peut pas être retiré**, et une appartenance
  `admin` ne peut pas porter de date de fin : une garde ne peut rien contre
  l'horloge.
- **Grants v2 décide pour les QUATRE chokepoints** — `usage_rights_v2_events`,
  `_machines`, `_person_booking`, `_places` valent tous `1`. L'enforcement est
  réel, ce n'est plus une simulation.
- **La saisie d'un forfait est compilée** : cinq axes (quoi / quand / où /
  combien / horaires) écrits par un compilateur dans les cinq tables, avec un
  refus qui sert de garde quand le forfait sort de ce que les axes savent dire.
- **L'appartenance est DATÉE** (`validFrom` / `validUntil`, `NULL` = sans limite).

### 🔴 Trois décisions que l'opérateur a CHANGÉES depuis

1. **Décision 5 — « un package est attribuable à un individu OU à un groupe » :
   plus par un humain.** Depuis S159, la seule surface d'écriture est
   l'attribution à un GROUPE, et depuis la revue de design du 2026-09-03 elle vit
   sur la fiche du groupe. ⚠️ Le MODÈLE garde les deux chemins : la colonne
   `userId` reste, parce que c'est celui qu'écrira le commerce — un achat est
   individuel et son remboursement doit retirer exactement ce qu'il a donné.
2. **Décision 7 — le rôle EST devenu un groupe qu'on ne peut pas supprimer.**
   `UTILISATEUR_ROLE` est supprimée (`Version20260902100000`) : `getRoles()` dérive
   des appartenances, et il n'y a plus deux sources à réconcilier.
3. **Décision 17 — on n'achète pas un forfait, on achète une APPARTENANCE datée.**
   Tranché par l'opérateur le 2026-09-01, et c'est ce qui supprime le cas
   particulier du commerce au lieu de le contourner : un seul chemin pour les
   humains et pour les machines, l'expiration devient le mécanisme.

### 🅿️ Ce qui reste franchement à construire

Sous-lieux comme scope réel des grants, fédération d'identité (S121+), profils
publics et QR (S122–S124), réseau inter-FabOS (S123–S126), commerce (S150–S154),
messagerie Formation (S155–S157). Le « Plan de livraison » plus bas les garde.

---

## Décisions produit enregistrées

1. **Les portails s'arrêtent.** Un service autonome reçoit sa propre installation FabOS, son thème, ses features et ses administrateurs, au lieu de publier un sous-ensemble des données d'une autre instance.
2. **Une installation gère plusieurs sous-lieux physiques uniquement quand tout le reste est commun.** Un sous-lieu partage gouvernance, comptes locaux, données, règles, packages, réservation et audit ; il ne sert pas à isoler un service autonome.
3. **Le sous-lieu est un contexte visible.** Un membre peut choisir ses sous-lieux préférés dans son profil et les remplacer sur une page. La préférence n'est jamais une autorisation.
4. **Un package appartient au FabOS.** Ses grants peuvent être limités à un ou plusieurs sous-lieux et à des scopes métier plus fins.
5. **Un package est attribuable à un individu ou à un groupe.** Les droits effectifs sont l'union des grants actifs ; il n'existe pas de deny implicite. 🔴 **Modifié depuis (S159, 2026-09-02) : un HUMAIN ne peut plus l'attribuer qu'à un GROUPE** — voir « les trois décisions qui ont changé », plus haut. Le modèle garde les deux chemins pour le commerce.
6. **L'administration de récupération est hors packages.** Un administrateur global ne peut pas perdre l'accès de récupération à cause d'un package supprimé ou mal configuré.
7. **Les groupes intégrés sont protégés et extensibles.** ✅ Construit. 🔴 Et étendu depuis (S159) : **le rôle est devenu un groupe qu'on ne peut pas supprimer**, `UTILISATEUR_ROLE` n'existe plus. Admin, Manager, Staff, Super user, User, Guest et Formateurs ont des clés stables et ne sont pas supprimables ; un lab peut modifier leurs libellés/descriptions et ajouter Stagiaire, Bénévoles ou tout autre groupe métier. Guest reste une audience anonyme virtuelle.
8. **Les packages présentent deux types de droit :** Use et Manage. Le reporting est inclus dans Manage sur le même scope ; il n'existe aucun droit Report séparé.
9. **Les droits suivent les features et leurs sous-sections.** Une source centrale décrit navigation, scopes, filtres, réservations, quotas et reporting.
10. **Les réservations et quotas apparaissent dans chaque workspace de feature**, tout en conservant des services et modèles communs derrière les écrans.
11. **Les badges sont globaux au FabOS, cumulatifs et sans scope de sous-lieu.** Une attribution n'est jamais effacée ; une erreur se corrige par révocation auditée.
12. **Les utilisateurs peuvent publier un profil public opt-in** et déclencher un import ponctuel et consenti vers un autre FabOS par QR éphémère.
13. **Une Institution peut être descriptive ou connectée à un FabOS.** Une URL unique permet la détection ; les synchronisations connectées sont ensuite confirmées, explicites, signées, idempotentes et limitées aux objets choisis par l'instance et le membre.
14. **Le design reste centralisé.** Les listes personnalisent leurs colonnes et données, jamais leur shell, leur CSS ou leur mécanique de filtres.
15. **Configuration → Thèmes rassemble l'identité publique.** Couleurs, logos/images, nom et ordre des menus, blocs/contenu/ordre de la homepage se règlent et se prévisualisent au même endroit.
16. **SSO partage l'authentification, jamais l'autorité ni les données.** LDAP/OIDC/SAML simplifient la connexion ; chaque FabOS conserve comptes locaux, groupes, packages, quotas, audit et recovery Admin.
17. **Le commerce reste un module facultatif et découplé.** Un achat peut financer un package, une matière ou du temps machine/personne/formation, mais le paiement ne devient jamais lui-même une permission ni un bypass de sécurité.
18. **La future messagerie Formation est interne d'abord.** FabOS conserve le message canonique entre formateurs et étudiants ; l'e-mail n'en est qu'une duplication de notification, beaucoup plus tard dans le chantier Formation avancée.

## Règle de topologie

Créer un **sous-lieu dans le même FabOS** seulement si les unités partagent gouvernance, administrateurs de confiance, annuaire métier, politiques, moteur de réservation, cycle de vie, responsabilité des données et besoin de vue agrégée. La vue par défaut montre alors toutes les machines/ressources autorisées de tous les sous-lieux ; le filtre sert à affiner, pas à simuler des tenants.

Créer un **autre FabOS** dès qu'un service veut sa propre administration, son thème, son catalogue, ses règles, sa rétention ou son rythme de déploiement. La distance physique n'est pas le critère. Une identité commune rend la connexion fluide, tandis que le Réseau FabOS/Institution transporte uniquement les données explicitement partagées.

Chaque objet possède une instance propriétaire. Une autre instance reçoit au plus une projection signée/read-only et renvoie vers la source pour réserver, s'inscrire, annuler ou gérer. Une réservation distribuée, un calendrier global ou une billetterie cross-instance nécessiteraient un protocole distinct ; ils ne sont pas promis par la synchronisation Institution.

## Modèle cible

### Instance, sous-lieu et espace

- **Instance FabOS :** installation autonome, identité fédérée et configuration globale, avec une seule autorité sur ses données.
- **Sous-lieu (`Venue`) :** implantation physique avec slug stable, nom, adresse, fuseau, état et horaires ; jamais une frontière d'administration ou de données.
- **Espace (`Place`) :** salle, atelier ou poste réservable rattaché à un sous-lieu.

La migration crée un sous-lieu par défaut et lui rattache les données existantes avant de rendre les clés étrangères obligatoires. Les événements externes ou en ligne peuvent rester sans sous-lieu. Sans préférence explicite, les catalogues agrègent tous les sous-lieux autorisés.

### Identité externe et compte local

`ProviderRegistry` décrit les fournisseurs autorisés ; OIDC est livré d'abord, LDAP/SAML restent des adaptateurs fondés sur des bibliothèques éprouvées. L'identité canonique est `(issuer/provider, subject immuable)`, jamais e-mail ou username. Un lien externe unique pointe vers un compte FabOS local qui porte seul suspension, groupes, packages, préférences et audit. Deux subjects partageant un e-mail restent deux comptes ; un changement d'e-mail conserve le même lien.

Le provisioning JIT crée seulement le compte local minimal. Aucun claim externe ne confère Global Admin, Manage ou un package. La liaison de deux comptes demande preuve des deux identités ou action admin auditée ; retirer le dernier moyen de connexion est refusé. Le recovery Admin reste local, hors IdP et disponible pendant une panne.

OIDC valide issuer, audience, redirect URI, signature/algorithme, horloge, state, nonce et PKCE. La politique de sessions couvre TTL, revalidation, back-channel logout si disponible, revoke-all local, rotation des clés et comportement lorsque l'IdP est indisponible. Une nouvelle connexion échoue fermée. Une désactivation connue révoque immédiatement les sessions concernées ; lors d'une panne IdP, une session déjà ouverte bénéficie d'au plus 24 heures de grâce et est revalidée dès le retour du fournisseur. Suspension locale et revoke-all restent disponibles hors IdP.

### Groupes et audiences système

- **Administrateur global :** recovery système, protégé, jamais dépendant d'un package, dernier admin impossible à retirer.
- **Guest anonyme :** audience virtuelle pour les actions réellement publiques.
- **Groupes intégrés :** Manager, Staff, Super user et Formateurs, non supprimables mais localement présentables/configurables ; Formateurs reste rattaché au workspace Formations.
- **User authentifié :** audience système de tout compte local actif, sans ligne de membership à créer, retirer ou oublier lors du provisioning.
- **Groupes libres :** Stagiaires, Bénévoles ou toute organisation du lab. Un compte peut appartenir à plusieurs groupes.

L'interface affiche les sept entrées intégrées avec leur statut protégé. Admin conserve son invariant de recovery ; User et Guest sont résolus comme audiences système et n'ont jamais de ligne d'appartenance (la table s'appelle `USER_GROUP_MEMBER`, pas `USER_GROUP_MEMBERSHIP` : un lecteur qui grepe le nom cité ici ne trouvait rien). Manager, Staff, Super user et Formateurs ont des membres et peuvent recevoir des packages, sans pouvoir être supprimés.

### Packages et grants

Un package est un modèle réutilisable de l'instance. Use et Manage sont ses deux niveaux **d'édition UX**. Manage inclut les fonctions de consultation, reporting et export sur le même scope, sans conférer Use. Le registre de sécurité les décompose en capacités atomiques, par exemple `maintenance.report.create`, `maintenance.analytics.view`, `maintenance.analytics.export`, `maintenance.intervention.update` ou `maintenance.return_to_service`. Une déclaration membre n'est jamais une permission de changer le statut d'une machine, et Manage générique ne remplace jamais la protection d'une opération sensible.

Chaque package contient des grants :

| Champ | Sens |
|---|---|
| feature | domaine FabOS central |
| section | sous-section optionnelle, par exemple Maintenance |
| action | `use` ou `manage` |
| scope | sous-lieu et dimensions métier autorisées par la feature |
| calendrier | horaires normaux, 24/7 ou fenêtre future |
| politique | profil de quotas/délais éventuel |

Les dimensions d'un grant se combinent avec **AND** : « catégorie Laser au sous-lieu Nord ». Plusieurs grants, packages et sources se combinent avec **OR** et s'accumulent dans le temps : un package autorisant mardi et un autre mercredi autorisent les deux jours. Tout est refusé par défaut hors Admin recovery ; aucun package ne retire un droit et suspension/bannissement restent séparés. Une attribution individuelle ou de groupe peut ajouter une restriction, jamais élargir le grant. Si plusieurs chemins portent des politiques de quotas, chaque chemin grant + calendrier + politique est évalué entièrement ; les champs de politiques ne sont jamais fusionnés. Le chemin gagnant est journalisé selon un ordre stable sans changer le verdict.

Pour Guest, `view`, `register` et les autres actions publiques sont des capacités distinctes. Le réglage FabOS est la valeur héritée, pas un plafond : l'objet peut `inherit`, `allow` ou `deny` chaque action. Avant activation, chaque événement live reçoit `guestView=allow`, puis `guestRegister=allow` si `guestsAllowed=1`, sinon `deny` ; les nouveaux événements héritent ensuite de défauts FabOS fermés. Catalogue/détail GET et inscription POST directe sont testés séparément. Une annulation Guest continue de passer par son lien signé, pas par un compte fictif.

### Ordre d'évaluation

1. Compte, feature, sous-lieu et objet actifs.
2. Résolution Admin recovery ou des packages individuels/groupes/audiences.
3. Grant Use ou Manage couvrant l'action, l'instant et tous les scopes.
4. Qualification, badge, formation et invariants métier ; l'Admin recovery ne les contourne pas lorsqu'il agit sur une ressource.
5. Contraintes physiques non contournables : fermeture technique, capacité, chevauchement, alignement, buffer.
6. Chaque politique complète de quotas/délais de la feature, sans assemblage champ par champ.
7. Journalisation de la source, du package, du grant, du scope et de la politique gagnants.

Les refus nomment la première couche actionnable. L'UI consomme le même verdict que le service ou voter ; la navigation cachée n'est jamais la sécurité. Les réservations existantes restent acquises lors d'un changement de package ou de politique, sauf opération de réconciliation séparée et explicitement lancée.

## Source centrale des features

Un `FeatureWorkspaceRegistry` doit être l'unique définition **de métadonnées** : label, icône, feature gate, sections, actions disponibles, scopes permis, filtres, onglets, routes, réservations, quotas et reporting. Il ne devient pas une autorité métier monolithique : adaptateurs de feature, voters et services restent les chokepoints. NavBuilder, packages, listes et contrôleurs ne maintiennent pas quatre mappings parallèles, et un test automatique exige que chaque route mutante possède un contrôleur d'autorisation déclaré.

| Workspace | Onglets / sous-sections cibles | Scopes et filtres métier |
|---|---|---|
| Équipement | Machines, Catégories, Modèles & marques, Matériaux, Maintenance, Réservations, Quotas, Reporting | sous-lieu, catégorie, machine |
| Événements | Événements, Organisateurs, Lieux d'événement, Inscriptions, Quotas/capacités, Reporting | sous-lieu, organisateur, lieu d'événement |
| Prêts | Objets, Catégories, Prêts, Quotas, Reporting | sous-lieu, catégorie, objet |
| Espaces | Espaces, Catégories, Réservations, Quotas, Reporting | sous-lieu, catégorie, responsable, département |
| Formations | Formations, Catégories, Sessions/progression, Formateurs, Reporting | catégorie, département, institution, formateur ; sous-lieu pour session physique |
| Badges | Badges, Attributions, Reconnaissances/émetteurs, Journal | global FabOS, aucun sous-lieu |
| Galerie de projets | Projets, Modération, Reporting | à déclarer global ou sous-lieu, jamais implicite |
| Pages personnalisées | Pages, Navigation, Publication | global par défaut |
| Utilisateurs | Utilisateurs, Groupes, Profils publics, Échanges QR, Reporting | catégorie utilisateur |
| Lieux | Sous-lieux, Horaires | sous-lieu |
| Packages | Packages, Attributions, Quotas, Audit | sous-lieu dans les grants |
| Réseau FabOS | Connexions, Synchronisations, Journal | instance distante et objets partagés |
| Configuration | État installation, Features, Thèmes, Réglages, E-mails, Initialisation, Développement | administration technique globale |

### Contrat de l'onglet Thèmes

L'opérateur dispose d'un seul éditeur pour : nom public du FabOS, logos et images de marque, couleurs/tokens autorisés, libellé et ordre des entrées de menu, choix/ordre/contenu des blocs de homepage. L'écran utilise les vrais composants du site dans une prévisualisation desktop/mobile et sombre/clair, puis sépare **Enregistrer le brouillon** de **Publier** et permet de revenir à la dernière version publiée.

Le stockage peut rester techniquement séparé entre identité, navigation et contenu, mais un service de thème versionné en est l'unique façade. L'ordre des menus référence des clés stables du `FeatureWorkspaceRegistry`, jamais des routes ou du HTML libres : une entrée désactivée ou non autorisée ne réapparaît pas par réordonnancement. Les images passent par `ImageNormalizer`; couleurs et contenu sont validés/échappés. Les valeurs de branding encore portées par les portails sont inventoriées en S105 avant consolidation, sans choisir silencieusement un gagnant.

Use et Manage sont des permissions de grants, **pas des onglets**. Les onglets représentent les tâches. Un onglet absent signifie que le verdict ne permet pas de l'ouvrir ; un workspace sans donnée autorisée affiche un état vide explicable.

## Contrat du futur module Commerce

Un `CommerceOfferRegistry` décrit les objets vendables sans recopier leur logique : attribution temporaire ou permanente d'un package, matériau, crédit de temps machine, temps d'une personne réservable ou participation/formation. Chaque adapter métier valide la cible, calcule ce qui sera livré et réalise la livraison après paiement confirmé. Les écrans d'achat vivent dans le workspace concerné ; le workspace Commerce commun gère catalogue d'offres, commandes, paiements, remboursements, rapprochement et audit.

`Order`, `OrderLine`, `PaymentAttempt`, `Refund` et le fulfillment persistant par ligne restent distincts des packages, réservations, stocks et inscriptions. Les montants, taxes, devises, unités et scopes sont figés sur la commande ; les offres peuvent évoluer sans réécrire l'historique. Les adaptateurs de fournisseur sont remplaçables et FabOS ne stocke jamais de données de carte. Le retour navigateur n'est jamais autoritaire : seul un webhook signé/vérifié ou une réconciliation fournisseur confirme le paiement. Le traitement assume une livraison at-least-once, déduplique `providerEventId`, puis utilise transaction/outbox et une source de fulfillment unique pour obtenir un effet métier exactement une fois malgré un crash entre paiement et livraison.

Un achat réussi ne réserve rien automatiquement et ne rend pas une action sûre. Une ligne Package appelle le service normal d'attribution Usage Rights et ne touche ni voters ni règles de sécurité. Sa compensation ne peut révoquer que l'attribution portant la source unique de cette ligne, jamais un droit équivalent venu d'un groupe ou d'une autre attribution.

Le paiement monétaire et la compensation métier sont deux états séparés, tous deux idempotents. Le contrat traite remboursement total/partiel, remboursement avant ou après fulfillment, dispute/chargeback et avantage déjà partiellement utilisé. Aucun remboursement ne retire implicitement une consommation passée ni ne remet automatiquement en stock un matériau déjà délivré physiquement.

Les matériaux placent un hold atomique de stock avant le checkout puis le consomment ou le libèrent ; si le lab autorise la vente sans stock, l'offre annonce explicitement un backorder. Deux checkouts ne peuvent jamais vendre silencieusement la dernière unité. Les crédits de temps utilisent un ledger append-only `grant/hold/consume/release/expire/refund_adjustment`, jamais un solde mutable : la réservation pose le hold, l'annulation le libère, l'usage le consomme et le no-show applique la politique. Unités, scope, source et expiration sont figés ; la consommation est atomique sous concurrence. Un crédit ne confère ni package ni qualification et ne crée jamais la réservation.

## Contrat de la future messagerie Formation

`TrainingConversation` se rattache à une formation, une session ou une cohorte canonique et possède un type de visibilité immuable : **annonce formateur→cohorte**, **fil privé entre les formateurs affectés et un seul étudiant**, ou **groupe dont les participants sont ajoutés explicitement**. Une réponse étudiant à une annonce ouvre/rejoint son fil privé ; elle ne répond jamais à toute la cohorte par défaut. Aucun changement de type ne transforme un fil privé en conversation collective. Les annonces n'exposent ni la liste ni les adresses des destinataires, et les étudiants ne peuvent pas se contacter entre eux hors groupe explicite autorisé.

Les participants sont résolus depuis les inscriptions actives, les affectations formateur et les capacités atomiques de gestion ; une adresse e-mail libre ne donne jamais accès à un fil. `TrainingMessage` est la copie canonique, horodatée et auditée. Une désinscription/annulation, suspension ou remplacement de formateur révoque immédiatement l'accès courant et les notifications en attente ; une formation terminée peut conserver un accès lecture selon la politique de rétention. L'audit reste réservé aux responsables autorisés et l'export de données suit sa politique propre : cacher un onglet ne protège jamais une URL directe.

Chaque message validé est persisté avant toute notification puis place une entrée par destinataire dans l'outbox du moteur mail existant. Juste avant la livraison, le worker revalide compte actif, inscription/affectation, participation au fil et droit de lecture ; sinon la notification est annulée et auditée. L'e-mail reprend le contenu autorisé et un lien vers le fil ; une erreur, un retry ou un doublon de worker ne supprime ni ne duplique le message interne. Les destinataires ne se voient pas entre eux, les préférences et langues sont appliquées par personne, et les adresses ne figurent jamais dans le contenu partagé. Répondre par e-mail n'est pas promis : la réponse se fait dans FabOS tant qu'un canal entrant authentifié n'a pas été conçu.

La première version privilégie les fils asynchrones en **texte brut**, avec taille maximale, échappement systématique dans l'UI et l'e-mail, rate-limit par auteur/conversation et contrôle anti-spam ; aucun HTML utilisateur n'est rendu. Non-lus, archivage, modération, signalement, export et durée de conservation appartiennent au modèle dès le départ. Les pièces jointes, si elles sont ajoutées, exigent une session séparée pour limites, MIME, antivirus, stockage et suppression. La messagerie ne sert ni de preuve de qualification ni de canal d'urgence/sécurité machine.

## Contrat commun des listes et filtres

Toutes les listes suivent cet ordre :

1. titre, compteur, action primaire ;
2. contexte sous-lieu compact si pertinent ;
3. onglets du workspace ;
4. un seul axe de filtres primaires en un clic, six choix maximum ;
5. recherche et `Plus de filtres` pour les dimensions secondaires ;
6. chips supprimables des filtres actifs, compteur et `Tout effacer` ;
7. table ou cartes partagées.

La résolution d'affichage du sous-lieu est `?location=` explicite et valide, puis préférence valide du profil, puis **Tous les sous-lieux autorisés**. Le scope d'autorisation de chaque action est évalué séparément. Une URL hors scope affiche un refus explicite ; elle ne bascule jamais silencieusement. `Tous` dépend du droit de lister les objets concernés, pas du droit Use. Le contexte reste dans l'URL, la pagination, la recherche et les onglets.

Le shell reste `_admin_list` + `_data_table`, étendu par des partials partagés (`scope_context`, `feature_tabs`, `applied_filters`, filtre avancé) et un registre de définitions. Chaque liste fournit ses colonnes, données et facettes ; aucune ne copie CSS ou JavaScript. Maximum cinq colonnes, aucune largeur minimale locale, ligne entière cliquable seulement avec une destination unique.

## Profils publics et échange ponctuel

Le profil public est désactivé par défaut. L'utilisateur choisit séparément identité, avatar, statistiques, formations et badges, avec aperçu exact. La route cible est `/m/{slug}`.

Import ponctuel : QR contenant un token aléatoire d'au moins 128 bits dont seul le hash est stocké, un purpose, une audience, une expiration courte et l'identité de l'instance source. Le GET d'aperçu ne consomme jamais le token — les scanners de QR ouvrent parfois les liens. Une confirmation récapitulative unique autorise ensuite l'import automatique des champs généraux proposés (nom, prénom, e-mail, avatar, bio, langue) et des badges acquis. La confirmation POST consomme atomiquement le token ; les conflits sont montrés et aucune valeur locale n'est écrasée silencieusement. Les credentials transportent aussi provenance, `expiresAt`, `revokedAt` et tombstone : un badge expiré/révoqué n'est jamais créé actif, et un nouvel import idempotent applique la révocation source à une copie déjà présente. Le token est révocable, rate-limité, absent des logs/referrers et protégé par `Referrer-Policy: no-referrer`. Une resynchronisation est une nouvelle action manuelle ; la synchronisation continue reste distincte, consentie et révocable.

## Réseau FabOS, badges et machines

L'admin saisit une seule URL sur l'Institution. FabOS la réduit à une origin HTTPS canonique soumise à une contrainte unique, puis tente `/.well-known/fabos`. Un échec conserve l'organisme descriptif, tandis qu'un succès propose de confirmer une connexion interne `FederatedPeer` identifiée séparément par son UUID distant stable. Cette découverte est informative et protégée contre SSRF/DNS rebinding : résolution et IP contrôlées, aucune redirection silencieuse vers une autre origin, timeout et taille limite. Aucune clé ni confiance n'est acceptée sans confirmation explicite. Modifier l'origin suspend le peer existant et force une nouvelle découverte et confirmation.

Une connexion confirmée possède identifiant d'instance, URL d'API allowlistée, clé publique, rotation/révocation des clés, état de confiance, capacités annoncées, règles de partage et journal de synchronisation. L'API est versionnée, signée, protégée contre replay, idempotente et bornée en taille/MIME. Inbox/outbox, quarantaine, conflits, tombstones et retries rendent les pannes partielles explicables.

Deux contrats de partage restent séparés. Pour les claims et credentials personnels, l'export est l'intersection entre l'allowlist du FabOS source et le consentement du membre pour la destination, la catégorie et la durée ; sans l'un des deux, aucune donnée ni identifiant pseudonyme ne sort. Pour les catalogues non personnels — définitions de badges/formations/matériaux et modèles — la politique de publication de l'instance se combine avec le peer/destinataire de confiance, sans consentement membre ni identifiant de personne. Ne jamais synchroniser mots de passe/hashes, secrets MFA/recovery, assertions ou tokens SSO, credentials LDAP, RFID, tokens machines, rôles/groupes/Admin/packages locaux, thèmes/features, arrêts/sécurité machine, stocks locaux, bans/suspensions, réservations détaillées, présences/logs d'accès, notes privées, données financières ou champs non consentis. Aucun rapprochement silencieux par e-mail : une identité externe est `(instanceId, subjectId)` et sa liaison locale demande une confirmation explicite.

Un utilisateur présent dans plusieurs FabOS possède des droits, quotas et audits locaux différents. Un badge ou catalogue peut circuler avec provenance, version, signature, expiration/révocation et tombstone ; une réservation ou un événement reste administré par son instance propriétaire. En cas de peer indisponible, la sync attend en outbox/quarantaine et ne devient jamais une autorisation fail-open.

Une attribution de badge conserve UUID global, utilisateur, définition versionnée/archivable, instance émettrice, preuve, date, formations sources, mode d'obtention, signature/provenance, expiration et éventuelle révocation. La simple relation many-to-many Badge–Formation ne suffit pas : une règle de qualification versionnée exprime alternatives, conjonctions, seuils et version de programme. Les règles « A + B offre C » créent une nouvelle attribution idempotente ; elles ne retirent rien. La suppression ou pseudonymisation d'un utilisateur suit une politique RGPD de rétention sans réécrire l'historique de l'émetteur.

Une machine locale référence une marque et un modèle partageables, mais conserve nom local, sous-lieu, photo locale, statut, token, règles de sécurité et overrides. Une synchronisation ne modifie jamais silencieusement la sécurité locale.

## Plan de livraison et responsables

Chaque session est migrable, testée, déployée sur Artemis et vérifiée indépendamment par **Sol**. **Terra** porte le domaine, les migrations et services ; **Luna** porte les contrats UX, composants et validation visuelle.

| Session | Livraison | Principal | Vérification Sol |
|---|---|---|---|
| S102 | consigner les décisions, publier la nouvelle roadmap et marquer S100–S101 obsolètes sans changer le live | Terra + Luna | cohérence docs/code |
| S103 | registre central Feature Workspace v2, contrat Thèmes et nouvelle maquette Développement, sans enforcement | Terra + Luna | matrice feature/route/scope/capacité + inventaire identité/menu/accueil |
| S104 | réparer la fondation quotas : comptes par type, hard constraints avant passes, tests et grandfathering | Terra | verdicts de régression et politiques complètes |
| S105 | geler les portails et produire le rapport de consolidation, sans suppression | Terra | collisions, canonical 301, sauvegarde et rollback |
| S106 | créer le sous-lieu par défaut, identité physique et horaires ; rendu inchangé | Terra, UI Luna | migration/backfill/rollback |
| S107 | rattacher machines, espaces, événements sur site, prêts, lecteurs et futures sessions | Terra | aucune ligne orpheline avant contraintes |
| S108 | contexte sous-lieu, préférence profil, URL et composant central | Terra + Luna | autorisation ≠ préférence ; mobile/clavier |
| S109 | groupes, migration des rôles, audiences système, protection dernier Admin | Terra | concurrence/lockout et parité Staff/Trainer |
| S110 | grants Use/Manage atomiques et scopes en simulation ; reporting inclus dans Manage | Terra | couverture routes, anti-escalade, différences |
| S111 | packages v2, attributions individu/groupe et restrictions par sous-lieu | Terra + Luna | union/restriction/temps et migration S97–S99 |
| S112 | shell central listes/filtres/facettes, maquette réelle | Luna + Terra | URL, requêtes, a11y, sombre, cinq langues |
| S113 | workspace pilote Équipement hors Quotas/Reporting, ajoutés seulement en S118–S119 | Terra + Luna | sécurité, aucune duplication ni onglet vide |
| S114 | workspaces Événements et Prêts | Terra + Luna | inscriptions/loans via adaptateurs réels |
| S115 | workspace Espaces | Terra + Luna | scopes lieu/catégorie/responsable/département |
| S116 | workspace Formations/Badges ; archivage/version, retrait delete/cascade, attribution append-only locale | Terra + Luna | sessions, règles qualification, historique préservé |
| S117 | Galerie, Pages personnalisées, Utilisateurs, Lieux, Packages, Réseau, Configuration et éditeur Thèmes | Terra + Luna | aucune feature/route oubliée ; preview/publish/rollback |
| S118 | politiques réservations/annulations/quotas par feature | Terra | hard constraints séparées des quotas souples |
| S119 | socle Reporting + premier adaptateur ; capacités analytics atomiques | Terra + Luna | lecture/export scoped sans fuite |
| S120 | retirer visuellement Réservations globale après parité et redirections | Terra + Luna | anciens liens et historiques préservés |
| S121 | fédération d'authentification : ProviderRegistry, OIDC d'abord, liens `(issuer, subject)` et provisioning local | Terra + Luna | identité, pannes, rotation, revoke-all, aucun claim Admin |
| S122 | profil public opt-in, slug, confidentialité par champ et inventaire des expositions existantes | Terra + Luna | vie privée, indexation, annuaires/API/kiosk |
| S123 | identité d'instance, confiance et API FabOS versionnée | Terra | crypto, rotation, SSRF, erreurs partielles |
| S124 | import QR inter-FabOS ponctuel signé et consenti | Terra + Luna | consommation atomique, replay, provenance |
| S125 | badges/formations fédérés append-only et règles dérivées | Terra + Luna | révocation sans effacement, doublons, provenance |
| S126 | marques/modèles machines fédérés et overrides locaux | Terra + Luna | aucune donnée locale/sécurité écrasée |
| S127 | retirer techniquement les portails après un cycle complet, audit nul et sauvegarde | Terra | inventaire consommateurs vide, restauration testée |
| S128 | audit transversal du socle listes/workspaces | Luna | Sol valide permissions, filtres, mobile, sombre, i18n |
| S129–S134 | stabilisation multi-lieux/navigation puis gestion et activation graduelle des droits v2 | Terra + Luna + Sol | routes/onglets réels, groupes, scopes, shadow sans écarts, voters atomiques, rollback |
| S150 | catalogue d'offres/prix sans transaction | Terra + Luna | cibles stables, taxes/devises, aucune permission implicite |
| S151 | commandes, checkout, fournisseur, webhooks, réconciliation et remboursements | Terra + Luna | événement unique, at-least-once/outbox, replay, secrets absents |
| S152 | fulfillment packages/matériaux et compensations | Terra + Luna | source d'attribution unique, hold stock, backorder, refund/chargeback |
| S153 | ledger crédits temps machine/personne et formations | Terra + Luna | grant/hold/consume/release/expire/refund sous concurrence |
| S154 | reporting, rapprochement et audit Commerce | Terra + Luna | totaux, remboursements, exports scoped, UX/i18n |
| S155 | domaine privé/annonce/groupe, messages texte/participants Formation | Terra | permissions, aucune fuite de cohorte, limites/rate-limit, rétention, audit |
| S156 | UX formateur/étudiant + duplication e-mail via outbox | Terra + Luna | revalidation à l'envoi, confidentialité, déduplication, préférences, i18n/a11y |
| S157 | modération, archivage, export et conservation | Terra + Luna | abus, anonymisation, pièces jointes éventuelles, conformité |

Ordre obligatoire : S104 avant tout nouveau moteur de droits ; S106–S108 avant tout scope de sous-lieu ; S109 avant attribution de groupe ; S110 avant enforcement ; S112 avant les workspaces pour éviter les copies ; S118 avant retrait de la vue Réservations ; S121 rend la connexion multi-instance fluide ; S122 précède le QR ; S123 authentifie toute donnée inter-FabOS avant S124–S126 ; S127 arrive après un cycle complet sans dépendance Portal ; S129–S134 stabilisent navigation, sous-lieux et droits v2 ; le commerce S150–S154 vient ensuite ; la messagerie S155–S157 attend le modèle Formation/session/cohorte, les inscriptions, les permissions et le moteur mail stabilisés.

Les workspaces S113–S117 livrent leurs listes et actions existantes sans afficher de faux onglet. Quotas avancés arrive en S118 et Reporting en S119 ; ces sessions branchent ensuite leurs onglets sur chaque workspace déjà migré.

S104 corrige explicitement deux défauts live avant les packages v2 : les compteurs active/daily/weekly mélangent aujourd'hui plusieurs `ReservableType`, et un AccessPass sort avant les contrôles d'alignement/buffer alors qu'il ne devrait lever que les quotas souples. Les tests couvrent les verdicts resserrés et desserrés ; les réservations déjà créées restent grandfathered.

### Grille de vérification Sol

- **S103 :** inventaire feature × route GET/POST/API/worker × gate × scope × capacité ; test de couverture route mutante → voter/service.
- **S104–S108 :** règles de collision et sauvegarde Portal ; backfill Sous-lieu à 100 %, zéro orphelin ; timezone/DST ; URL hors scope refusée ; préférence sans effet sur l'autorisation ; pagination/onglets/mobile/clavier/i18n.
- **S109–S111 :** matrice sujet direct/groupe/Guest/Admin × feature × section × capacité atomique × scope × temps ; dernier Admin protégé sous concurrence ; restriction d'attribution sans élargissement ; CSRF, IDOR, mass assignment ; shadow log sans différence inexpliquée.
- **S112–S120 :** une implémentation commune par fonction ; total global égal à l'union des vues feature ; anciens liens redirigés ; aucune fuite reporting/export ; N+1, états vides, sombre, mobile et cinq langues.
- **S121 :** même e-mail/deux subjects restent deux comptes ; changement d'e-mail conserve le lien ; liaison concurrente atomique ; issuer/audience/nonce/signature/horloge invalides refusés ; JIT, suspension, panne IdP, rotation JWKS, logout et recovery hors IdP testés.
- **S122–S124 :** privé par défaut après inventaire des surfaces publiques ; identité source authentifiée avant QR ; deux consommations concurrentes donnent exactement un succès ; GET non consommant ; expiré/révoqué/replay refusés ; secret absent des logs/referrers ; un credential importé révoqué/expiré n'est jamais actif.
- **S123–S126 :** trust explicite, rotation/revocation clés, replay/idempotence/out-of-order/tombstones, quarantaine, SSRF, taille/MIME/HTML hostile, consentement révocable ; aucune fusion par e-mail ; un badge révoqué ne qualifie plus ; aucune sécurité machine locale écrasée.
- **S127–S128 :** recherche code/SQL/Twig/config/workers sans consommateur Portal ; sauvegarde/restauration testée ; parcours E2E de chaque persona et scope ; chaque verdict explicable dans l'audit ; mode Développement désactivé avant production.

## Décisions opérateur complémentaires

1. **Admin recovery respecte badges, formations et arrêts de sécurité.** Il contourne les packages pour permettre la récupération administrative, mais toute utilisation d'une ressource reste soumise aux qualifications et contraintes physiques. Une modification de qualification est explicite et auditée.
2. **Use et Manage sont les deux seuls droits.** Manage inclut consultation, reporting et export sur le même scope, sans conférer Use.
3. **Le catalogue Formation est global au FabOS.** Seules les sessions physiques portent un sous-lieu.
4. **Les expositions publiques ont une politique par surface.** L'opérateur active la surface et le membre consent à son exposition ; les vues internes nécessaires à une tâche autorisée suivent les droits et leur finalité. Image/galerie conserve un consentement distinct.
5. **Une désactivation IdP connue révoque immédiatement.** Une panne refuse les nouvelles connexions et accorde au plus 24 heures aux sessions déjà ouvertes, revalidées dès le retour du fournisseur ; les contrôles locaux restent utilisables.

## Hors scope maintenu

RFID, cartes physiques et 2FA restent différés. 🅿️ **Une demande opérateur du 2026-09-03 rouvre la question pour les LIEUX** : des boîtiers identiques à ceux des machines, reliés à des gâches électriques — consignée dans `ROADMAP.md`, avec le point qui la change (les axes lieu/jours/horaires d'un forfait décrivent déjà un verdict de porte, bien mieux que les badges des machines) et ce qu'une porte a de plus qu'une machine. Le commerce est planifié après le socle et ne bloque aucune session S103–S128. La réservation par pool de machines n'est pas impliquée par les catégories ou scopes. Les calendriers, quotas, tickets/check-in, waitlists et réservations distribués entre plusieurs FabOS restent hors scope : l'instance propriétaire demeure la seule autorité et les autres redirigent vers elle.
