ENSEA-Makerspace/FabOS/Stage/Drive/RFID.ioc

Mcu.UserName=STM32L476RGTx
PA3.GPIO_Label=RC522-RST
PA3.Signal=GPIO_Output
PA4.GPIO_Label=RC522_CS
PA4.Signal=GPIO_Output
PA5.Signal=SPI1_SCK
PA6.Signal=SPI1_MISO
PA7.Signal=SPI1_MOSI
PC13.GPIO_Label=B1 [Blue PushButton]
PC13.Signal=GPXTI13
