ENSEA-Makerspace/FabOS/(commit log)

2026-07-04 Ajout de la version connectée à la base de donnée - V1
2026-07-06 changement front admin/ problème des favoris fixé/ changement logique machine tokens
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2026-07-09 Ajout des modèles 3D pour le boitier
    [BoitierFabos.3mf, BoitierFabos.stl]
2026-07-09 Update FabApp fusion des travaux réalisés sur les pages de Leaderboard, Fomartions, User, Admin et Calendrier.
    [meilleure-impression-fabapp.3mf]
2026-07-10 Ajout de fonctionnalités supplémentaires sur la page Leaderboard, correction du mode sombre
2026-07-10 Correction des creations, correction de la personnalisation page accueil. Ajout du tutoriel
2026-07-10 Implémentation du mode sombre sur la page Admin, changements sur le design des boutons page Accueil.
2026-07-12 Correction du problème concernant des appuis multiples sur le bouton de connection page Login bloquait la connection. Ajouts mineurs
2026-07-20 Fix crashes and image handling on the public creation upload form
    The "Publier ma creation" form (/leaderboard/creations/new) had three
    issues surfaced while testing real submissions:
    - Any submit threw a 500: applyPublicCreationDuration() was called but
    never defined. Add it, it parses the HH:MM print-duration field into
    minutes and lets the existing Regex constraint handle invalid input.
    - Phone photos were rejected as "too large" even after re-selecting.
    Add server-side auto-compression (compressOversizedCreationImage):
    images over the 3 MB limit are resized to max 2200px and re-encoded
    before form validation. Large PNGs (lossless) that cannot fit are
    transparently re-encode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
2026-07-20 Align local dev stack to MariaDB and add local run guide
    The shipped Docker/env config still targeted PostgreSQL while the app
    runs on MariaDB. Bring the local baseline in line:
    - compose.yaml / compose.override.yaml: Postgres -> MariaDB service,
    healthcheck, volume path and published port (3306).
    - .env: switch the placeholder DATABASE_URL to MariaDB (still uses the
    !ChangeMe! placeholder; real secrets live in the gitignored .env.local).
    - .env.local.example: matching MariaDB example.
    - RUN_LOCAL.md: local setup / run instructions.
    Baseline commit capturing the current deployment config as a starting point.
2026-07-20 Let creation authors delete their own gallery submissions
    Until now only admins could delete a creation; a regular user had no way
    to remove their own. Add a self-service delete on the creations gallery.
    - SiteController::deleteLeaderboardCreation (POST
    /leaderboard/creations/{id}/delete): ROLE_USER + ownership guard
    (author id must match the current user, 403 otherwise) + CSRF check,
    then removes the entity and its uploaded image/file via a safe
    basename/realpath-checked cleanup helper (mirrors the admin one).
    - leaderboard-creations.html.twig: a "Supprimer" button, shown only on
    the current user's own cards, with a confirm() guard.
    - calendar-leaderboard.css: red .creation-btn.d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
2026-07-20 Show who voted when clicking a creation's rating count
    On the creations gallery, the "N notes" count is now a clickable toggle
    that reveals the list of voters and each one's rating for that creation.
    - CreationVoteRepository::getVotersByCreation(): one grouped query
    (JOIN user) returning voters per creation, ordered by rating desc
    then date — avoids an N+1 across the gallery.
    - SiteController::leaderboardCreations passes the voter list per row.
    - leaderboard-creations.html.twig: the count becomes an accessible
    toggle button (aria-expanded / aria-controls) revealing a per-card
    voter panel; a small vanilla-JS handler shows/hides it.
    - calendar-leaderboard.css: styles for the toggle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
2026-07-21 Add multilingual support (FR/EN/ES/DE/IT)
    Introduce a working internationalization layer and translate the shared
    navigation/header so language switching is visible across the app.
    - config: default_locale fr + enabled_locales for the 5 languages.
    - translations/messages.{fr,en,es,de,it}.yaml catalogs (nav + common keys).
    - LocaleSubscriber: resolves the locale from session choice -> logged-in
    user's Utilisateur.langue -> default, and sets it on both the request and
    the translator (runs at priority 7, after the firewall; must push the
    locale onto the translator itself since LocaleAwareListener already ran).
    - SiteController::switchLocale (GET /locale/{locale}): stores the choice in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
2026-07-21 Add Projects as a top-level nav item
    Surface the creations gallery (app_leaderboard_creations) as its own main
    nav entry labelled via the nav.projects translation key, inserted after
    Leaderboard across the inline navbars.
2026-07-21 Add admin toggles for optional site modules
    Badges, Formations, Leaderboard and Projects (gallery) can now be turned
    on/off from the admin.
    - SITE_MODULE table (raw-DBAL ModuleService, defaults to enabled if the
    table/row is missing so nothing breaks pre-migration) + migration.
    - module_enabled() Twig function guards the nav links (wrapped across the
    inline navbars).
    - ModuleAccessSubscriber returns 404 for a disabled module's public routes
    (admin routes exempt).
    - /admin/modules page with on/off switches + sidebar entry.
    Verified: disabling a module hides its nav link and 404s its pages;
    re-enabling restores them.
2026-07-21 Add tags to project (creation) uploads
    Let authors tag their gallery projects and surface those tags as chips.
    - tags column on CREATION (comma-separated) + entity accessors incl.
    getTagList(), + migration.
    - optional free-text tags field on the public upload form; the controller
    normalizes it (trim, case-insensitive de-dup, max 8 tags x 30 chars).
    - tag chips rendered on the gallery cards (+ styles).
    Verified: 'impression 3d, Déco, déco, cadeau' -> stored 'impression 3d,
    Déco, cadeau' and rendered as three chips.
2026-07-21 Add a hidden full-screen machine station kiosk page
    Unlisted /kiosk/machine/{id} route for a screen next to a machine: a clean
    two-pane fullscreen view with the machine name/category/level/location, an
    availability badge, a prominent 'tap your RFID card to start' prompt, and
    on the right the how-to-use instructions, required badges (or open-access),
    materials, and the week's opening hours with today highlighted.
    Fully translated (FR/EN/ES/DE/IT) via kiosk.machine_* keys.
2026-07-21 Translate the login page content (FR/EN/ES/DE/IT)
    First full page-body translation beyond the nav: every visible string on
    the login page (headings, form labels, buttons, help cards) now uses
    login.* translation keys, added across the 5 catalogs.
2026-07-21 Translate machines list and machine detail pages (5 languages)
    Wrap all visible strings (filters, categories, statuses, levels, table
    headers, favorites tooltips, detail tabs, badge/access messages, tech
    info) in machines.* / machine.* keys (+ common.search, common.reset)
    across the 5 catalogs.
2026-07-21 Translate leaderboard and formations catalog pages (5 languages)
    leaderboard.* / formations.* keys across the 5 catalogs for the ranking
    page (type/period filters, table headers, empty states, community
    gallery) and the trainings catalog (filters, statuses, cards).
2026-07-22 Add pinned projects to the creations gallery
    Admins can pin a creation from /admin/creations; pinned items sort to
    the top of the main gallery (both recent and rating sort modes) and
    show a small badge on their card. New CREATION.isPinned column
    (migration + toggle route mirroring the existing publish toggle).
2026-07-22 Add badge detail pages
    Badges in the public catalog are now clickable (/badges/{id}), like
    formations. The page shows what the badge unlocks access to (machines
    via the existing MachineBadge relation), how to earn it and roughly
    how long it takes (formations that award it, via Formation.badge,
    reusing their existing duree field), where it is recognized (new
    Badge.whereRecognized field), and the lvl1/lvl2 style unlock chain
    (new self-referencing Badge.prerequisiteBadge FK plus its inverse).
    Admin can set the new fields from the existing badge new/edit forms.
    Verified end-to-end: both directions of the unlock chain render
    correctly, machine access list and formation/duration list populate
    from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
2026-07-22 Harmonize footer with current nav, modules, and i18n
    The footer had drifted since the nav/module work: it was missing
    Projects, Badges, and Mes reservations links, none of its optional
    links were gated by module_enabled() (so a disabled module footer
    link would 404), and it was hardcoded French with no translations at
    all. Added a footer.* namespace to all 5 locale catalogs, wired every
    optional link through module_enabled()/is_granted() the same way
    _header.html.twig does, and reused existing nav.*/resv.* keys where
    possible instead of duplicating strings.
2026-07-22 Add Mes reservations link to the shared header, translate search aria-label
    The calendar page was the only page whose nav showed a Mes
    reservations link (ROLE_USER-gated). Added it to the shared
    _header.html.twig partial so every page using it gets the link too.
    Also translated the search buttons hardcoded French aria-label, which
    had been missed by the earlier i18n pass.
2026-07-22 Add Places reservation module
    New admin-toggleable module (places) letting people reserve rooms and
    spaces the same way they reserve machines, per the confirmed scope:
    generalize Reservation rather than build a parallel system, booking
    only for v1 (no RFID door readers yet).
    Generalized Reservation.machineId to nullable and added a new nullable
    placeId FK to a new Place entity (name, description, location,
    capacity) - migration Version20260722160000.php. Both a machine and a
    place reservation now flow through the exact same entity, conflict
    checking (new hasOverlapForPlace, mirroring hasOverlap), and the my
    reservations list, satisfying the integrate seamlessly requirement at
    the data layer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
2026-07-22 Add Events module: admin CRUD + public pages (part 1/3)
    New admin-toggleable module (events key) for dated, display-only events
    (workshops, open days, meetups). Mirrors the Places/Institutions CRUD
    pattern established earlier.
    - New Event entity + EventRepository (findUpcoming) + migration
    Version20260722170000. Table is EVENEMENT because EVENT is a MySQL
    reserved word.
    - Module wiring: events added to ModuleService::MODULES, the
    ModuleAccessSubscriber 404s /events (and the future /kiosk/events)
    when the module is off, and the admin modules page lists it.
    - Admin CRUD at /admin/events (list/new/edit/delete) with EventAdminType
    (title, start, optional end, location, description; va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
2026-07-22 feat(calendar): render events inside the calendar grid
    Move upcoming events from a bottom "strip" on /calendrier into the
    weekly agenda grid itself, placed in the day/hour cell matching each
    event's start time. Events render as a distinct, non-bookable
    .slot-event-card (dashed pink border, links to the event detail page)
    and never affect slot bookability or the machine reservation cards.
    Data is passed as an EVENTS JS array built from upcomingEvents, gated
    on module_enabled('events'). Removes the old cal-events-strip section
    and its inline style block.
2026-07-22 feat(machines): wire the favorite button on the machine detail page
    Detail page favorite was a disabled "coming soon" placeholder; now toggles via
    the existing /api/me/favorite-machines endpoint, mirroring the machines list.
    Controller passes favoritesEnabled + isFavorite (fail-safe via isStorageReady).
2026-07-22 feat(calendar): read-only iCal/webcal feeds for machines & spaces
    S3: per-resource .ics feeds (app_machine_ical /calendar/machine/{id}.ics,
    app_place_ical /calendar/place/{id}.ics) gated by a rotatable site-wide token
    stored in SITE_SETTING (no schema change). IcalFeedService builds RFC 5545
    VCALENDAR with a Europe/Paris VTIMEZONE and privacy-safe events (busy slots
    only, never who booked). Subscribe (webcal://) links surface on the machine
    calendar + place detail pages for logged-in users; admin can view/regenerate
    the feed token in settings. i18n across all 5 catalogs. Place feed auto-gated
    by the places module via route-name prefix.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
2026-07-23 feat(materials): Materials catalogue module (v1)
    S5 (uses the S4 module scaffold): new admin-toggleable `materials` module with
    a shared catalogue of significant lab materials (filament, sheet, resin...).
    - Material entity + MATERIAL table (migration Version20260723140000, additive
    new table - safe to deploy ahead of the migration; catalogue fail-safe []).
    - Public catalogue /materiaux (app_materials), card grid with image-or-emoji,
    category, description, specs (key:value lines), storage, colour, buy link.
    - Admin CRUD (list/new/edit/delete) mirroring the Events module + sidebar entry
    + shared _material_form partial.
    - Module registered (ModuleService::MODULES + admin label + ModuleAc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
2026-07-23 feat(materials): link materials to machines (S5b)
    Machine <-> Material M2M (owning side on Material, MACHINE_MATERIAL join
    table, migration Version20260723150000). Admin picks accepting machines on the
    material form (EntityType checkboxes). Machine detail page shows a "Compatible
    materials" card (image/emoji + name + category chips) via
    MaterialRepository::findByMachine() - fail-safe [] so the machine page never
    breaks when deployed ahead of the migration (Machine entity untouched -> no
    hydration risk). i18n materials.on_machine x5.
2026-07-23 refactor(reservations): polymorphic Reservation - expand + read-side cutover (S8)
    A Reservation now addresses its resource as (reservableType, reservableId)
    instead of two nullable FKs, so bookable people - and any later resource kind -
    need a new enum case rather than a new column.
    Expand step only: machineId/placeId are still mapped and still written (every
    setMachine/setPlace call dual-writes the polymorphic triple), so this deploys
    against the existing schema and rolls back cleanly. The contract migration that
    drops them is a separate, later beat.
    - Version20260724100000: add reservableType/reservableId/reservableLabel,
    backfill from both FKs, index (type, id, dateDebut). Applied on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
2026-07-23 refactor(reservations): unified booking service - one chokepoint for all resources (S9)
    The JSON API and the place form each re-implemented the same four booking
    checks, and had drifted: the place form had no access gate at all, so any
    member could book a space under rules the machine flow enforced.
    ReservationService::book() now owns every rule that decides whether a booking
    is allowed - future check, end>start, opening hours, motif length, overlap, and
    a per-resource-kind access gate (machine -> MachineQualificationService,
    space -> open, person -> the later policy engine). Both entry points keep only
    what they actually own: payload parsing and presentation. The permission trio
    (cert-gati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
2026-07-23 refactor(reservations): drop legacy machineId/placeId - contract step (S10)
    Completes the polymorphic-Reservation refactor. Reservation no longer maps a
    machine or a place at all; (reservableType, reservableId) is the only way it
    addresses a resource, and both are now mandatory.
    ⚠️ Deploy order is the REVERSE of the expand step: the narrower entity ships
    FIRST and the migration runs after. An entity narrower than its table is always
    safe; an entity wider than its table 500s every page that hydrates it.
    Dropping the FKs also drops their ON DELETE CASCADE, which is what used to
    clean up bookings of a deleted resource. deletePlace() now explicitly cancels
    upcoming bookings via cancelUpcom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
2026-07-23 feat(reservations): bookable people - slots, durations and open requests (S11)
    Gives a person their own appointment page, the last resource kind the
    polymorphic Reservation model was built for. Two ways in:
    - offered slots, computed from weekly USER_AVAILABILITY windows intersected
    with opening hours, minus existing bookings, sliced by the durations the
    person offers. These confirm immediately - they already said yes to the hour.
    - a free-form request for any other time, which lands pending and is the
    person's to accept or decline at /mes-disponibilites.
    Booking still goes through ReservationService::book(); people are one
    checkAccess() arm plus the offered-vs-request branch, which i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
2026-07-23 fix(booking): make Mes disponibilites findable
    The profile button sat at the bottom of the reservations table behind a
    bookable/staff/trainer condition, so the one person who needed it couldn't
    find it. Show it on the profile unconditionally - the page already explains
    that an admin has to flip the Reservable switch - and give a bookable person
    a nav link, since answering requests is a recurring errand.
2026-07-23 feat(emails): mail backbone - sender account, async sending, audit log (S13)
    The notifications spine the loan reminders, booking confirmations and digests
    will plug into. Sends nothing on its own yet.
    - New admin-toggleable `emails` module, and /admin/emails: the sender account
    (transport DSN, from address/name, reply-to), a "send a test" button and the
    log of everything that went out.
    - App\Mail\Mailer is the one way to send. It refuses when the module is off or
    no sender is configured, so a lab without SMTP silently sends nothing rather
    than throwing from the middle of a booking; non-transactional mail respects
    the user notification preference.
    - EMAIL_LOG is both audit trail an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
2026-07-23 feat(reservations): booking mail - confirmations, requests, cancellations (S14)
    First real senders on the S13 backbone. Six templates, five catalogues, no new
    schema.
    - App\Reservation\ReservationMailer owns the booking-mail vocabulary: which
    template goes to whom per transition, and the one context they all render
    from. Call sites just say what happened.
    - Wired into the transitions that already existed: book() (confirmed, or the
    pending pair - "request sent" to the booker, "new request" to the person),
    answerRequest() (accepted / declined), the cancel endpoint, and both
    cancelUpcomingForReservable() callers.
    - Cancelling a resource had no way to tell the people holding its booki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
2026-07-23 feat(mail): scheduled reminders - bookings, loans, maintenance (S15)
    Adds the scheduled half of FabOS mail: a console command on a timer that
    works out what is coming due and tells the people it concerns.
    The design point is idempotency. Scanners are stateless and re-report the
    same candidates on every run; MAIL_REMINDER's unique key decides what has
    already gone out, via an INSERT that is allowed to collide. That makes the
    timer's cadence a tuning decision rather than a correctness one, and keeps
    two workers from racing into duplicate mail.
    - MAIL_REMINDER + ReminderLog: the already-sent ledger, claim-before-queue.
    A claim that cannot be recorded refuses to send — forgetting costs one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
2026-07-23 fix(booking): check notice and horizon before slot alignment
    Found while probing the refusal branches: a booking made 30 minutes ahead
    under a 2h-notice policy came back SLOT_NOT_ALIGNED, because the test time
    also happened to be off-grid and alignment was checked first.
    Not a wrong answer, but the wrong one to lead with. Min-notice and horizon
    say "you cannot book at this time at all"; alignment says "round it to the
    nearest half hour". Someone moving a booking to a legal time usually fixes
    the alignment on the way, whereas fixing alignment on a slot that was never
    bookable just earns a second refusal. Coarsest constraint first.
    Verified: a slot that is both misaligned and too soon now re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
2026-07-23 fix(admin): restore missing chrome on the quota page, style late-added inputs
    Two real rendering breaks, found by finally being able to load the admin
    screens (see the temporary loopback bypass in the same commit).
    The admin layout block — grid, sidebar card, nav links, header banner — is
    NOT in style.css. Every admin page carries its own copy inline. The new
    quota page copied the markup but not that block, so it rendered with no
    grid at all: sidebar and panel stacked full-bleed.
    Separately, admin-emails styled its inputs with an allow-list of
    input[type="text"] and [type="email"]. S15 added two number fields and S16
    a url field, none of which matched, so they rendered as bare unstyled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
2026-07-23 fix(admin): make the quota page theme-aware
    The page was built with literal light colours, so under the dark theme the
    scope cards stayed #fff and — the loudest part — every one of the 108
    number inputs rendered as a white box with dark text sitting on a dark
    panel, because an input with no background of its own falls back to the UA
    default.
    Switches to the existing --theme-surface / --theme-surface-elevated /
    --theme-input variables, which flip with UTILISATEUR.theme on <html>. Drops
    the hardcoded #fafafa empty-state background; the "—" placeholder already
    says "no limit" and needed no colour of its own. Adds a dark override for
    the "limité" pill, since brand pink on a dark surface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
2026-07-23 feat(booking): staff-issued access passes that lift quotas (S18)
    The third piece of the permission trio, and the end of it. A pass is a
    staff-issued, expiring, audited exemption from the booking quotas.
    The safety line from the spec is enforced structurally, not by discipline.
    BookingPolicyService::check() gains a $passApplies short-circuit that
    returns before the quota rules — and returns nowhere near checkAccess().
    So a pass can wave away "how much may you book" but has no reach into "are
    you trained to use it safely": the certification gate runs first, on its
    own, and a pass never touches it. There is deliberately no cert-bypass
    column in the schema, with a comment saying why, so the n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
2026-07-23 fix(booking): read pass validity windows in the lab timezone, not UTC
    Caught by the lifecycle probe: an already-expired pass tested as still
    valid. The server runs UTC; the booking flow's $now is Europe/Paris. Pass
    windows are entered and stored as bare wall-clock strings, and
    AccessPass::fromRow parsed them with the default zone (UTC), so every
    window landed two hours off — a pass "valid until 18:00" was read as 18:00
    UTC = 20:00 Paris and outlived its own deadline.
    Pins both ends to the lab zone: fromRow parses the stored strings in
    Europe/Paris, and StaffController parses the datetime-local form input the
    same way, so the wall-clock staff type is the wall-clock stored and read
    back. Wi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
2026-07-23 fix(mail): make the unsubscribe page theme-aware
    Same hardcoded-light-colour pattern as the quota page. This one is public
    and it is where every non-transactional mail sends people, so a logged-in
    recipient following the link from their own inbox got a white card floating
    on their dark page.
    Switches the card, headings and body text to the theme variables, and adds
    the dark override for the category pill (brand pink fails contrast on a
    dark surface).
2026-07-23 feat(booking): merge spaces into the main calendar (S19)
    Finishes what the S8-S10 polymorphic refactor was for. Spaces were bookable
    only from their own detail page with a separate form; they now appear in the
    one calendar alongside machines, filtered, drawn and booked the same way.
    The change is really one idea: the calendar's notion of a resource stops
    being a machine id and becomes a composite "kind:id" key. Machine 2 and
    space 2 are different resources with the same id, so a bare id would have
    collided in the filter set, the grid columns and the access map. Everything
    downstream — checkbox values, reservation matching, BOOKING_ACCESS, the
    booking picker — now keys off that.
    - SiteC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
2026-07-24 feat(events): registration with guests, waitlist and organiser call-off (S20)
    Grows the display-only events module into something people can sign up to.
    NOT YET DEPLOYED — see the warning at the end.
    Registration is open to people without an account, which drives most of the
    design. With no account there is nothing to dedupe on, so every row carries
    a normalised contactEmail — copied from the account for members, typed in
    by guests — with a unique index per event. That single column is what keeps
    an open signup form from producing a nonsense attendee list, and it lets one
    set of queries and one mailer serve both kinds of registrant.
    - EVENT_REGISTRATION + EVENEMENT.capacite. Capacity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
2026-07-24 feat(events): remind registrants before an event (S20b)
    The reminder the events module was missing until there was anybody to
    remind. Slots into the existing scanner framework as one new class, which
    was the point of the tagged-interface design in S15.
    Same sweep-a-window shape as the booking scanner: everything starting
    between now and the configured lead time, claimed once per registration.
    Keyed on the registration rather than the event, so someone who signs up
    inside the window gets their own claim instead of being swallowed by an
    event-wide key another attendee already spent.
    Three deliberate narrowings in the query: seat-holders only (a waitlisted
    person has nothing to turn up to), c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
2026-07-24 fix(mail): keep link URLs in the plain-text part, and honour show_cancel
    Two bugs found by reading the delivered mail rather than the templates.
    strip_tags keeps a link's label and throws its href away, so the text
    alternative said "Cancel my registration" with no URL attached. For a guest
    that link is the ONLY way to cancel — they have no account to sign in to —
    so a text-only client left them stuck. Links are now flattened to
    "label : url" before the tags are stripped, which fixes every template at
    once rather than the one that happened to be caught.
    The second is a Twig trap: `show_cancel|default(true)` fires on any FALSY
    value, so passing `false` to suppress the link came back as t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
2026-07-24 feat(events): poster art, real location and a redesigned event page (S20d)
    Makes the public event page something you'd actually want to link to.
    Location is modelled as a MODE, not a free-text field, because "where is
    it?" has two genuinely different answers. On site, the address is the lab's
    own and belongs in one place — a new lab_address site setting — so moving
    premises means editing one field rather than every event ever created. Off
    site, the address belongs to the event, and that is the only case worth
    storing per-event. `lieu` survives as the human label ("Grande salle"),
    complemented by the address rather than replaced by it.
    Directions are DERIVED, never stored. A map URL sav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
2026-07-24 feat(events): QR tickets and a poster-driven kiosk (S20e)
    Adds endroid/qr-code rather than hand-rolling an encoder: QR is Reed-Solomon
    plus mask selection, far too easy to get subtly wrong in a way that only
    shows up as a code nobody's phone will read. Installed on the container,
    lockfile pulled back so git stays the source of truth.
    THE SECURITY MODEL IS THE POINT HERE. The ticket link and the QR payload are
    deliberately DIFFERENT URLs. The ticket is what the attendee holds and proves
    only which registration they are. The QR encodes a /staff route, so the
    firewall — not the signature — is what stops a ticket-holder pointing their
    own phone at their own ticket and admitting themselves.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
2026-07-24 feat(events): per-event QR code for posters and flyers
    Distinct from the ticket QR, and worth keeping straight. TicketLinker's QR is
    per REGISTRATION, signed, and scanned BY STAFF to admit one named person.
    This one is per EVENT, unsigned, and scanned BY THE PUBLIC off a printed
    poster to reach the event page and sign up.
    Unsigned on purpose: the target is a public page, and a signature on a
    printed poster only creates a link that breaks if the app secret ever
    rotates — a QR on paper cannot be reissued.
    Rendered inline on the admin event page with the encoded URL shown as text,
    plus a 1200px PNG download: a QR upscaled from a screen-sized image gets soft
    edges that phones struggle with,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
2026-07-24 fix(admin): give the poster and QR panels their own container
    Reported as "missing their own div", which was exactly right — two separate
    faults on the event edit page.
    .admin-edit-panel has no padding of its own; it comes from .admin-edit-form
    on the <form> element. So anything placed after {{ form_end(form) }} sits
    flush against the panel edges. Wrapped both blocks in .admin-edit-extra,
    which restores the same 24px the form was supplying, with a proper separator
    rule instead of an inline border.
    Separately, .btn-action was used on this page but defined NOWHERE — not
    locally, not in style.css — so all three buttons rendered as bare links.
    Defined it to match .btn-link, which the pag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
2026-07-26 docs: modular-platform roadmap, handover notes, and a live roadmap page
    The plan for turning FabOS from a fablab tool into a platform that can be
    ONLY what a deployment needs — only machines, only events, only an LMS,
    only a lending library.
    docs/ROADMAP.md covers S21 onwards, batched into deployable sessions, with
    the design principles they're held to. The load-bearing ones:
    - Three tiers: kernel (never optional) / resource modules (each adds a
    bookable layer to the calendar) / feature modules. The calendar is the
    spine, not a feature — the polymorphic reservation model already says so.
    - Surfaces are DERIVED, not configured: the calendar page appears when
    something is bookable,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
2026-07-26 docs: restructure the roadmap around capabilities, not modules
    The operator's insight: the admin should be asked "what do you need?" —
    an LMS, event handling, a lending library — not made to work out which of
    fourteen internal checkboxes add up to that. Choosing Events should turn on
    events and leave machines alone.
    Surveying the current list showed the word "module" is doing four unrelated
    jobs: real feature domains (events, loans), bookable resource layers
    (places), pure visibility over data that is already core (staff, trainers),
    and infrastructure enablement (emails). Renaming wouldn't fix that; the
    model needed splitting.
    Four layers now, and the admin only ever chooses at one of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
2026-07-26 docs: add the concrete capability catalogue
    The operator's proposed list, checked against the code and corrected in two
    places rather than transcribed.
    Verified couplings that a naive list gets wrong:
    - BADGES ARE NOT AN LMS FEATURE. MachineQualificationService depends on
    UtilisateurBadgeRepository — certification gating *is* badges. A machine
    workshop that requires certification but runs no courses still needs them,
    so nesting badges inside the LMS (as proposed) would silently break machine
    safety gating for anyone who didn't want a training system. Badges is its
    own capability: required by cert-gating, awarded by the LMS.
    - Team directories are not the same thing as booking p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
2026-07-26 docs: split the project gallery from the leaderboard (decision recorded)
    Operator settled it: the coupling is historical, they are two different
    features of the app. Checked what each actually does before writing it down —
    `app_leaderboard` ranks PEOPLE (presence and prints, by period), while
    CreationVote is a RATING on a project, which makes `creations/ranking` a
    best-rated-projects view. Genuinely two things wearing one namespace.
    S22 broadens from "separate installed from visible" to "untangle what is
    conflated", because the staff case and this one are the same failure in
    different clothes. Scope, from reading the routes rather than guessing:
    - every gallery route lives under /leaderb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
2026-07-28 docs: badges stay their own capability; "equipment" is the user-facing word
    Two decisions from the design conversation.
    BADGES ARE NOT PART OF PHYSICAL ACCESS. Asked directly, and the code answers
    it: MachineQualificationService gates BOOKING (pure web, no hardware in
    sight) and MachineAccessService gates the RFID TAP — both consume badges
    independently. Filing badges under Physical access control would mean any
    deployment without reader hardware — the current live state, and the
    majority case — silently loses certification gating on booking. That is a
    safety regression, not a simplification.
    Badges therefore have one owner and three consumers: the LMS awards them,
    equipment cert-gat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
2026-07-28 docs: badges are diploma-like — grouped under Training, independent in the model
    The operator's framing ("badges are sort of diplomas") is a good one, and it
    sharpens the argument rather than reversing it: a diploma is ISSUED by a
    school but RECOGNISED by employers who have nothing to do with that school.
    Badges are exactly that. The LMS issues them; equipment cert-gating and the
    RFID door recognise them with the LMS nowhere in the picture. So they belong
    to the training DOMAIN conceptually while staying STRUCTURALLY INDEPENDENT —
    otherwise an equipment workshop that certifies people but runs no courses
    loses its safety gating the moment it declines a training system.
    Resolution record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
2026-07-28 fix(mail): a disabled module must stop sending its reminders
    Found while reviewing the capability plan: of the five reminder scanners,
    only the event one checked whether its module was enabled. So switching off
    Loans or Maintenance left their timers still mailing people about a feature
    the lab had turned off — invisible in the UI and still reaching inboxes,
    which is the worst kind of "off".
    Not hypothetical: the dry run showed a live loan_overdue candidate and two
    maintenance ones sitting behind those toggles.
    Gates loans (once, in the shared abstract) and maintenance. Verified both
    ways on the live container: modules on, both kinds report; modules off, they
    disappear from the run entire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
2026-07-28 refactor(mail): email is kernel, with a pause switch instead of a module
    Confirmed by the operator. Booking confirmations, event registrations and
    password-shaped mail are transactional — an install should not be able to
    stop them by flipping a feature toggle, which is exactly what the `emails`
    module allowed.
    Mailer::isOperational() now reads "a sender account is configured, and
    sending is not paused". The two states it has to express are genuinely
    different: "this install never sends mail" is expressed by having no sender
    account (already handled, already graceful), while "stop sending for now" is
    a deliberate, visible pause for a maintenance window or a test run.
    Stored as `mail_pause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
2026-07-28 docs: settle how a class appears on three calendars
    Question: one class should show where and with whom, and also occupy the
    room's calendar and the trainer's. Merge the three, or duplicate?
    Answer: duplicate the ROWS, not the TRUTH. The session owns when/where/who
    and projects an occupancy reservation onto each resource it consumes.
    Not merging the model, because RESERVATION addresses exactly one target and
    making that many-to-many would reach into overlap detection, both calendar
    builders, quotas, passes and booking mail — effectively all of S8–S20 — to
    serve one use case.
    Not "just displaying" it either, because if the room isn't genuinely
    reserved someone books it out from under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
2026-07-28 docs: S21 shipped — equipment is a module, the calendar is a surface
    Records what actually landed, including the two shells the four-way
    boot exposed, and — more useful to whoever picks this up next — what
    was deliberately left alone and why: the RFID box endpoints are
    hardware and belong to a later capability, and the ungated homepage
    stats tiles are ungated for every module, so fixing them one module at
    a time would just be inconsistency spread thinner.
2026-07-28 feat(capabilities): ask what the deployment does, not which modules it has
    Fourteen implementation checkboxes became a question a newcomer can
    answer. `CapabilityRegistry` is the catalogue — key, label, a
    plain-language description of what you actually get, and the modules
    it switches on. Modules become internal, visible only under Advanced.
    Two departures from the plan, both deliberate.
    **Module state stays authoritative in SITE_MODULE.** The plan had
    capability state authoritative and module rows kept only as deviations
    from what the capabilities imply. That was rejected twice over: every
    existing install already has an explicit row for every module, so on
    the day this shipped every mo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
2026-07-28 docs: S23 shipped — capabilities, and why module state stayed authoritative
    Writes down the inversion the plan asked for and why it was not taken,
    since the reasoning is what a later session needs rather than the
    outcome. Also records that the catalogue is currently 1:1 between
    capability and module, so nobody assumes the union was tested against
    an overlapping case — there isn't one yet.
2026-07-30 docs: features, not capabilities-over-modules
    Rewrites the architecture section around the single concept, marks the
    S23 record superseded rather than deleting it — the reasoning still
    applies and it explains the inert capability_* rows — and carries the
    consequences forward: S26 warnings attach to features, S27's
    per-portal capabilities are per-portal features.
2026-07-30 feat(setup): make the silent degradations discoverable
    Several parts of FabOS do less than you'd expect when a setting is
    missing, and every one of those choices is deliberate: `Mailer`
    refuses rather than throwing from the middle of a booking, an absent
    `public_base_url` means mail carries *no* link rather than one
    pointing at localhost, a ticket without a public URL carries no QR.
    Each is the right behaviour. Each is also completely invisible — the
    failure mode is someone telling you weeks later that the confirmation
    mail never arrived.
    `SetupHealth` names them, with the consequence rather than the
    setting: "no sender account → nothing goes out, and nothing errors".
    Severity is about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
2026-07-30 docs: S25 health panel shipped, wizard scoped out
    Records the two decisions the wizard still needs (what counts as
    unconfigured now that capabilities_configured is inert; and that a
    global redirect interceptor on a live install is a hazard to gate
    narrowly), and why sample data was left for the operator: it writes
    production rows and its wipe should be a human's click.
2026-07-30 refactor(admin): one stylesheet instead of 653 copy-pasted rules
    Forty-nine CSS rules were duplicated across the fifty-five admin
    templates — 653 lines in total, each page carrying its own copy of the
    chrome. That is why the admin drifted: a fix landed on whichever page
    someone happened to be editing and nowhere else, which is how buttons
    came to be styled nowhere, radios inflated to full width, and every
    panel rendered as a white box in dark mode.
    `public/css/admin.css` now owns them. The rules are reproduced
    byte-for-byte and the stylesheet is linked *before* each page's inline
    block, so light mode renders exactly as it did and a page that
    genuinely needs to override something still can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
2026-07-30 feat(nav): the menu assembles itself from what is switched on
    The header was fifteen hand-written `feature_enabled()` checks wrapped
    around hardcoded markup, plus a nested ternary chain picking a group's
    landing page. Every new feature meant editing the template, and the
    rules that mattered were written fifteen times over — so they could,
    and did, drift apart.
    `NavBuilder` states them once:
    1. A group with no visible children is not rendered at all — not as
    an empty dropdown, and not as a heading linking to a 404.
    2. A group's own link follows its children: where the natural
    landing page is gone, the heading points at the first child still
    there.
    3. Visibility is p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
2026-07-30 feat(features): say what a choice costs, without taking it away
    S23 deferred `recommends` because its only reader was this session's
    warning UI, and a stored field nothing consults lies to the operator.
    It has its reader now.
    Each relationship was checked against the source rather than assumed,
    and **one of them contradicts what the plan expected.** The plan's
    worked example was "equipment uses badges for certification gating —
    without it, anyone can book any machine". That is not what happens:
    `MachineQualificationService` has no feature check at all and reads
    badge records directly, so switching badges off does not re-open
    equipment to anyone. What actually happens is harder to diagnose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
2026-07-30 feat(404): a page that says "not part of this site", and a record of what people wanted
    The reported bug was that a disabled page "throws an error". It did: the live
    install was running APP_ENV=dev, so every 404 rendered Symfony's development
    exception page with the routing internals in an HTML comment. That is fixed on
    the box (APP_ENV=prod in .env.local); this is the part that makes the page worth
    landing on.
    The 404 templates already existed and had never once been seen, because dev mode
    meant they never rendered. Two things were wrong with them:
    - The way out was hardcoded: "Voir les machines", "Voir les formations". On an
    install with equipment and training switched off, every e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
2026-07-30 docs: S37 shipped; the live site is on prod, and that costs a verification trick
    Switching the box out of dev mode took the loopback admin bypass with it — it
    required debug mode as one of its three conditions — so admin screens can no
    longer be rendered for inspection from inside the container. Recorded as a
    standing gap, along with the ordering it implies: verify anything admin-shaped
    before an install goes to prod.
    Two operational corrections that follow from prod, both of which would otherwise
    look like a silently failed deploy: the rollback recipe's `rm -rf var/cache/dev`
    is now var/cache/prod, and templates and translations need a cache:clear where
    dev picked them up on its own.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
2026-07-30 fix(404 log): run before the error page, not after it
    The subscriber sat at priority -256 to stay out of the response's way. It never
    ran once. `ExceptionEvent` extends `RequestEvent`, and `RequestEvent::setResponse()`
    calls `stopPropagation()` — so the moment Symfony's ErrorListener (-128) attaches
    the error page, every lower-priority listener is skipped.
    The failure mode is worth remembering: `debug:event-dispatcher` listed the
    listener, registered and correct, and the log stayed empty. Nothing looked wrong
    anywhere except in the one table that mattered.
    -100 is after RouterListener (-64) and before any response exists.
    Verified on the live container, all four filters: a miss with an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
2026-07-30 docs: the exception-listener priority trap, written down where it will be found
    A kernel.exception listener below -128 never runs — ErrorListener sets the
    response, RequestEvent::setResponse() stops propagation, everything under it is
    skipped. It cost an afternoon precisely because every diagnostic said the
    listener was fine.
    Also records that the migration is applied and what was verified with it in
    place, including the two probe rows left in the table.
2026-07-30 chore: clear two known debts — a swallowed regex escape, and 967 dead lines
    `_badge_image` tested filenames against '/^[A-Za-z0-9._-]+\.(png|jpe?g|webp)$/i',
    but Twig read the `\.` as a string escape and dropped the backslash, so preg got
    a bare `.` — any character. `photoXpng` counted as an image. Doubling the
    backslash restores the literal dot and is what Twig 4 will require anyway; the
    prod cache rebuild is what surfaced it. Checked against the real BADGE rows:
    every icon is an ordinary .png, so nothing changes on screen.
    public/js/calendar.js was referenced by no template — the calendar page carries
    its own inline JS — and has been dead weight for a while.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
2026-07-30 feat(security): replace the HTTP-reachable admin bypass with a shell-only renderer
    ⚠️ NOT DEPLOYED — the deploy is the operator's to run. See the note below.
    LOCAL_ADMIN_BYPASS existed because the agent has no password and the firewall
    302s an anonymous request to /login before the controller runs, so every admin
    and staff screen was invisible to anything that could not click. It paid for
    itself; it was also a password-less sign-in reachable over HTTP, held off by
    three conditions that a request travels through — a flag, an IP range, debug
    mode. Moving the site to prod switched it off by accident, which is a fair
    summary of how load-bearing those conditions were.
    ConsoleRenderAuthe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
2026-07-30 feat(portals): one install, several front doors — S27
    The portal mechanism has existed since S12 and nothing could reach it: no way to
    create one, so hostname resolution, portal-scoped settings and portal-scoped
    modules were all dead code. This is the UI, and no migration — PORTAL exists and
    both config tables have carried a portalId since S12.
    Three decisions carry it.
    **Per-portal features are tri-state, not checkboxes.** A portal says on, off, or
    nothing at all, and nothing-at-all is the default. Checkboxes would have written
    an explicit row for all fourteen features the first time anyone pressed Save,
    silently cutting that portal off from every later change to the site-wide
    switche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
2026-07-30 docs: S28's redirect shipped; the blocks half is left, with its migration hazard
    Records the two rules worth keeping: the home route is re-validated on every
    request, so a feature switched off later falls back to the ordinary homepage
    instead of redirecting the front page onto a 404; and it stays a 302 because a
    form-changeable redirect must never be cached permanently.
    Marks the remaining half — portal-scoping HomepageSectionVisibility — as an ORM
    entity change, i.e. migration first, code second, with no fail-safe degradation.
2026-07-30 fix(admin): dark mode, actually looked at — S29's visual pass
    The plan said this session needed eyes on screens and that an agent could not do
    it. `app:render` plus the public stylesheets turned out to be enough: render each
    admin page to HTML, serve it locally against the real CSS, and drive a browser
    over it in both themes. Everything below was found that way and re-checked after
    fixing — 7 pages × 2 themes, all clean at the end.
    **108 hardcoded light backgrounds across 40 of the 58 admin templates.** The
    shared chrome was already safe: `html[data-theme="dark"] .admin-panel` outranks a
    page's inline `.admin-panel` on specificity whatever the source order. What was
    never covered is ea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
2026-07-30 refactor(admin): one chrome, six class families — S29's skeletons
    The plan called for three skeletons. Measuring found **six**: the two documented
    extras `.admin-rfid-*` and `.admin-user-*` (3 pages), and `.admin-content-grid`,
    which is its own two-column shell on 6 more and had never been named anywhere.
    They are converged in admin.css rather than by rewriting 55 templates. Banner,
    shell and rhythm are now defined once and every existing class name resolves to
    it; the inline copies that fought it are gone. Verified by measuring computed
    geometry rather than by eye — across one page of every family, header background,
    header padding, sidebar column and gap now all agree, and the **conte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
2026-07-30 docs: six skeletons, not three — and why the last of S29 is a markup job
    Counting them by reading templates missed half; measuring found .admin-content-grid,
    a two-column shell on six pages that had never been named anywhere.
    Records the rule that cost the most: an inline override is deliberate until
    measured otherwise. Six pages nest .admin-main-content inside the outer grid and
    said so inline; deleting those as duplicate chrome gave each a second empty
    sidebar, which only the geometry check revealed.
    And states the remaining blocker plainly: .admin-panel is a self-padding box on
    one family and an unpadded frame on another, so no shared padding is correct.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
2026-07-30 refactor(admin): one panel padding model — the last of S29
    Measuring 21 panels across 14 pages overturned the premise. `.admin-panel` was
    supposed to be two semantics — a self-padding box on some pages, an unpadded
    frame on others — and the plan (mine) was to introduce `.admin-panel-body` and
    move ~17 pages of content into it.
    It was not two semantics. It was **three values with no rule behind them**: 0,
    24px and 32px. Pages whose panel starts with `.admin-panel-header` had 32px *and*
    0px, and the header brings its own 20px/24px either way — so the 32px was padding
    wrapped around already-padded content. Drift, exactly what this stylesheet exists
    to remove.
    So the panel is a frame e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
2026-07-30 feat(admin): edit this, from where you are looking at it — S30
    Most admin edits concern something the person is already reading, so an admin on
    an event page should not have to go and find that event again in the panel. One
    macro (`site/_admin_inline.html.twig`), one affordance, six detail pages: events
    (edit + registrations), equipment, spaces, training (edit + content), lab pages
    and badges. Global configuration stays in the panel — this is only ever "this
    record, here".
    **The button is a shortcut, never the permission.** Every target sits behind
    `/admin`, which `security.yaml` gates with `access_control`, so what makes it
    work is the firewall on each request. Verified both halves rat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
2026-07-30 docs: S30 shipped — visibility is not authorisation, and role has no hierarchy
    Records the rule that bit: a chip's role must mirror its target route's own
    access_control line, and ROLE_ADMIN does not imply ROLE_STAFF here because no
    role hierarchy is configured. Too strict hides the shortcut from the people who
    can use it; too loose offers a button that bounces to /login. Neither is a hole —
    the firewall decides either way — but both are wrong.
    Also notes why the chip carries its own backdrop: titles are sometimes overlaid
    on a photo hero, where transparent is invisible.
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2026-07-30 feat(setup): a first run that cannot hijack a running site — S25's wizard
    S25 left two things to decide before this was worth building. Both are decided
    here, and both decisions are the conservative one.
    **What counts as "unconfigured": an explicit flag, never an inference.**
    `setup_completed_at` is written once, by finishing or by skipping, and nothing
    else moves it. Deciding from whether settings happen to be empty is wrong in both
    directions — an operator who deliberately runs without a public URL would be
    nagged forever, and one who filled in a single field would be declared done.
    ⚠️ **But a missing flag is not enough to call an install fresh.** Every install
    that predates this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
2026-07-30 docs: sample data dropped — S25 is complete
    Recorded as a decision rather than deleted, so a cold start doesn't read the
    absence as an oversight and rebuild it. The reasoning is worth keeping too: the
    health panel already teaches what a populated install would have demonstrated,
    and a demo set has to be maintained in step with every schema change forever.
    S25 now reads complete: health panel + wizard shipped, sample data dropped.
2026-07-31 docs: Phase H — the parked audit becomes seven sessions, ahead of the LMS
    Most of this is a codebase audit from 2026-07-10 that was parked before anything
    was implemented. Re-checked against the live site on 2026-07-31: the critical
    findings are still true, so the parking was the only thing keeping them open.
    S38 is not theoretical. /api/leaderboard returns real names paired with their
    physical badge UID, unauthenticated, from the internet — and the RFID device
    endpoints have no authentication at all, because the token check returns
    "allowed" when the token is unset.
    Sequenced so the dangerous ones carry their own warnings: S39's fail-closed flip
    locks every reader in the building if i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
2026-07-31 docs: Phase U — a measured palette and a defaults inventory, so two sessions stop guessing
    Two of the principles were the vaguest instructions in the phase, so both are now
    numbers instead of adjectives.
    "Vibrant modern palette" turned out to hide a structural constraint: no single
    accent hex can be text in both themes. Measured — #9E1B56 is 7.65:1 on white and
    1.97:1 on the dark panel; a rose vivid enough to fix that (#D6246E) still only
    reaches 3.11; teal fails both. Anything saturated enough to read on white is too
    dark on #2b2335 and vice versa. So every colour role is a *pair*, which is the
    shape .admin-status-* already has from S29 — the token layer generalises it
    rather than in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
2026-07-31 docs: Phase U — S55, and a traced click baseline for the booking flow
    S55 came out of checking whether a single-feature deployment actually looks like
    one on the public side. Of the six homepage blocks only two are feature-gated,
    and mini_leaderboard is a real bug of the same class S37 fixed on the error page:
    `leaderboard` is a registry feature, so switching it off hides the nav entry and
    404s /leaderboard while the homepage keeps rendering a block that links there.
    fablab_stats is ungated too, and its key name is a leftover of the vocabulary
    S31 made configurable.
    The click baseline is traced through the templates rather than guessed: booking a
    machine from the home page is 3 page loads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
2026-07-31 docs: the front-end facts belong in the handover, not only in a plan
    Phase U's audit turned up four things a cold start needs before touching any
    template, so they go in PROJECT_STATE §9 where front-end context is looked for —
    a plan gets read when you pick a session, a handover gets read before you type.
    The public side has no shared layout at all (0 of 45 templates extend base), so
    "just fix this page's head" is not a small change. ux-turbo, stimulus-bundle and
    asset-mapper are installed and completely unused while the calendar hand-writes
    395 lines of inline JS — which is the answer to "how do I make this interactive"
    and the reason not to add a framework. 460 KB of CSS, 135 KB of i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
2026-07-31 feat(design): one token layer, and a page that measures it — S45
    Phase U's foundation. Extends the vocabulary that was already there rather than
    starting a parallel one: `:root` already had spacing, radius, shadow, transition
    and a type ramp, so `--fs-*` beside `--font-size-*` would have been exactly the
    duplication this phase exists to remove.
    **The bug the token layer fixes is structural, not cosmetic.** The dark block
    overrode fifteen variables and *not* `--color-primary` — which is why every use
    of the brand colour as text failed on dark, and why S29 had to hand-patch
    .btn-text, .rfid-log-link and the edit-nav one at a time. Measured: 7.65:1 on
    white, **1.97:1** on the dark panel.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
2026-07-31 feat(ui): S46 batch 2 — 14 of 37 public pages now share a layout
    machines, formations, leaderboard, materials, people-directory,
    mes-reservations, search. Verified the same way: diff rendered output before and
    after, and every remaining difference is head whitespace collapsing, per-request
    CSRF tokens, or the lang="fr" → app.request.locale correction.
    ⚠️ Found while checking what the migration silently drops — it takes everything
    *after* the header include, so anything between <body> and that include is lost.
    Only one page has real markup there, and it turns out to be a bug: **index.html.twig
    renders the alert bar itself, and _header.html.twig renders it again.** The
    homepage has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
2026-07-31 feat(ui): S54 — delete the 40 controls that did nothing
    The audit counted 19 "bientôt disponible" affordances. Grepping the
    `disabled` attribute instead of the apology found 40, across 16
    templates: a third of the dead controls never said "soon".
    Per page, one of build / remove / replace-with-a-sentence:
    - admin-badges: a duplicate dead filter bar sitting directly under a
    working one, bulk buttons with no backend, a checkbox column feeding
    them, and a 69-line mock "create badge" modal that nothing opened.
    All removed (-302 lines) — new/edit routes and the `q` filter already
    worked underneath.
    - admin-reservations: export + bulk actions removed; the JS behind them
    was three a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
2026-07-31 fix(ui): S54 follow-up — the fake reset mail, and the profile sub-menu
    Two things the first pass missed or the operator corrected.
    1. /forgot-password still carried a script that intercepted submit and
    alert()ed "Un lien de réinitialisation a été envoyé à <email>". It
    sends nothing — the route is GET-only with no handler. Removing the
    form left the script bound to an element that no longer exists, but
    the real problem is that it was lying before the form went too.
    Neither of S54's greps could see it: it says neither "disabled" nor
    "bientôt disponible". Swept every template for alert() stubs; this
    was the last one.
    2. "Mes réservations" and "Mes disponibilit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
2026-07-31 feat(admin): S50 — the admin sidebar follows the feature model
    29 entries in three generic groups (Contenu / Stats & Live / Réglages),
    none of them feature-gated. An events-only portal — the deployment
    Phase A exists to make possible — still administered Machines, Espaces,
    Matériaux, Prêts and Maintenance. The public nav solved this in S24;
    the admin never did.
    Every entry now carries the feature that gates it, and the groups follow
    the registry's own vocabulary instead of "Contenu":
    Réserver machines · places · réservations · quotas · accès
    Activités événements · formations · badges · créations ·
    matériaux · objets prêtables · prêt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
2026-07-31 feat(ui): S55 — the homepage stops advertising features that are off
    Four of the seven homepage blocks were not feature-gated, and one of
    them was a live bug: `leaderboard` is a real registry feature, so
    switching it off hid the nav entry and made /leaderboard 404 while the
    homepage kept rendering a leaderboard block linking straight at it —
    the same bug S37 fixed on the error page.
    The gate goes in HomepageVisibilityService, not at each call site. That
    map is what the controller loads data from, what the template renders
    from, and what HomepagePersonalizationService builds the section order
    out of; those three could previously disagree, and did — the controller
    checked isEnabled('mac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
2026-07-31 feat(booking): S47 — machine pages answer 'when is this free?' themselves
    Availability was four clicks deep: nav -> machines -> a machine ->
    Reserver -> a calendar grid to read. The app already knows the opening
    hours, the existing bookings and the quota rules, so making a member
    recover that answer by eye is a tax on the common case.
    machine-detail now computes the next slot this person could actually
    book and puts it on the primary action: 'Reserver — libre le 04/08 a
    14:00'.
    NextFreeSlotService validates candidate slots *through*
    BookingPolicyService rather than reimplementing min-notice, horizon,
    slot alignment and the per-person quotas. A second copy of those rules
    would drift, an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
2026-07-31 fix(booking): pin the timezone on the read, not just the write
    The next-free-slot label advertised an 08:00 opening as 06:00. The
    service was right — it pins Europe/Paris and produced 08:00 — but
    Twig's date filter renders in the app's default timezone, which is UTC,
    so the correct value was converted on the way out.
    This is the exact trap the roadmap flagged: the zone has to be pinned on
    the write *and* the read. Caught by comparing the rendered button
    against /api/opening-hours rather than by trusting the render.
2026-07-31 docs: S47 partly shipped — the answer up front, and the timezone trap firing
    Records what shipped (NextFreeSlotService + the machine-detail action),
    what is explicitly still open (one-click confirm, /machines card-face
    availability, cancel-with-undo, the smart-defaults inventory, per-site
    motif), and that the happy path remains unverified because verifying it
    means creating real bookings in production.
    Also corrects the click-count baseline: both calendars already meet the
    'book a specific slot' target, so that row should be re-measured rather
    than re-fixed.
2026-07-31 fix(security)!: stop publishing machine device tokens on public pages + S48 disclosure
    SECURITY. machine.machineToken was rendered to anonymous visitors on
    three public pages: machine-detail ('Token printer-01'),
    machine-historique (twice) and the homepage machine cards.
    That token is not a label. It is the path segment addressing the machine
    on the RFID device API:
    POST /api/rfid/machines/{machineToken}/authorization
    POST /api/rfid/machines/{machineToken}/work-sessions
    PATCH /api/rfid/machines/{machineToken}/work-sessions/current
    And RfidMachineController::rejectUnauthorizedDevice() fails OPEN: when
    FABOS_RFID_API_TOKEN is empty it returns null, i.e. allowed. That env
    var is NOT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
2026-07-31 docs: S48 partly shipped, and the machine-token exposure written down
    Records the disclosure work, why it uses native <details> (AssetMapper is
    never loaded, so Stimulus is inert everywhere and wiring it is S51's),
    and what is still S48's.
    Most importantly records the security finding with both halves and who
    owns each: the public leak is fixed, FABOS_RFID_API_TOKEN is the
    operator's to set, and making the device check fail closed is S38/S39.
2026-07-31 feat(security-ux): S49 — affordances ask the route's own access rule, not a hand-written role
    This app has no role hierarchy: ROLE_ADMIN does not imply ROLE_STAFF.
    Every affordance that names a role is therefore a copy of a rule that
    lives in security.yaml, and copies drift. S30 already lost the event
    registrations chip that way — gated ROLE_STAFF, route under /admin, so
    it vanished for the only people who could use it.
    New can_reach('route', params) Twig function asks security.access_map —
    the same access_control map the firewall consults — whether this person
    could open the target. Nothing to keep in sync: edit security.yaml and
    every affordance follows. Multiple roles on one line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
2026-07-31 feat(ui): S52 — touch targets and a mobile nav that says whether it is open
    Measured first, not guessed. The burger was ~40x32 and nav links ~35px
    tall — both under the 44px touch minimum, on the surface someone uses
    while standing next to a machine.
    - 44x44 minimum for the burger, and for nav links, dropdown links,
    profile/detail/formation tabs, buttons and inline admin actions.
    - Gated on (pointer: coarse), not on width: a narrow desktop window is
    still a mouse, and a big tablet is still a finger. Width would have
    changed desktop layouts for no reason.
    The mobile toggle flipped a class and announced nothing: a screen reader
    heard the same thing whether the menu was open or shut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
2026-07-31 refactor(css): S53 (partial) — delete the stylesheet nothing loads, dedupe two style blocks
    calendar.css, 28KB, referenced by zero templates and imported by
    nothing. Checked templates/, src/, public/, assets/ and config/, and
    for @import in the other sheets, before deleting. The three calendar
    sheets that ARE loaded (calendar-fix, calendar-modern,
    calendar-leaderboard) are untouched — folding those together is the
    real S53 and needs the pages driven, not just greps.
    index.html.twig and search.html.twig each carried the same <style>
    block twice, byte for byte: once in page_styles and again inside
    javascripts, left over from S46's layout migration. Removed the second
    copy in each after as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
2026-07-31 docs: S51, S52 and S53 recorded — including what each deliberately left undone
    S51: two components shipped because two are used; the rest were written
    and deleted rather than shipped as dead CSS. The open decision that
    gates the remainder is recorded prominently — AssetMapper is not wired
    up, so Turbo and Stimulus run nowhere, and inline edit-in-place,
    drawers and date pickers all depend on that call being made.
    S52: touch targets and the mobile nav's missing aria-expanded, with the
    measurements that justified them, and the explicit note that neither the
    calendar nor the forms were checked at mobile presets because the S29
    browser harness was not run.
    S53: only the provably-dead subset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
2026-07-31 feat(booking): S47 — the space booking form opens on the next free slot
    place-detail asked for a date and two times, all empty, on a page that
    already knew the opening hours, the existing bookings and the minimum
    notice. It reuses NextFreeSlotService, which validates candidates
    through BookingPolicyService rather than reimplementing the rules.
    - A suggestion, never a constraint: all three inputs stay editable and
    ReservationService::book() still validates, so a slot pre-filled here
    and taken since is still refused.
    - `submitted` still wins, so a failed submit never loses what was typed.
    - Europe/Paris pinned on the read as well as the write. The app default
    is UTC; without it every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
2026-07-31 docs: record the place-detail defaults, and why /machines card availability was not built
    Adding a next-free-slot to each machine card would be 11+ queries on an
    un-paginated list, growing with the lab. That is the query-volume
    problem Phase H S41 already exists for, so it needs a batched query and
    a session that can measure it — not a naive loop shipped unattended.
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2026-08-01 docs: Phase U read against UTA-FabLab/fabapp — S70-S73, a model gap
    Second comparison, against the UTA Arlington FabLab's own open-source system.
    A full fablab like ours whose bulk usage is the printers; the operator has
    visited it. PROPOSED, none approved, none authorised.
    The finding is bigger than anything in the Fabman read, and it is a model gap
    rather than a UI one: booking is the wrong model for a 3D printer, and booking
    is all we have. Reservation is polymorphic across machines, places and people
    and every one of them is a time slot. Nobody reserves a printer for 8 hours in
    a lab with three printers and forty students -- so it happens on a whiteboard
    the app knows nothing about. U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
2026-08-01 docs: second round of Phase U direction — categories app-wide (S74), pooled booking, swipe-to-claim, package capabilities, ticket printer
    Seven operator decisions, several of which change already-written sessions.
    The principle that now breaks ties: anything the member can do, the staff will
    not have to.
    Categories stop being a list filter and become the thing you act on -- queue
    for 'a laser', and book the category rather than a specific machine unless you
    need the big one. New S74, and a prerequisite for S70. Recorded the question
    that decides everything downstream: does a pooled booking resolve to a machine
    at booking time or at start time? They produce different calendars; recommende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
2026-08-01 feat(proposition): S58/S59 prototype — two page shapes, real data, admin-only
    The middle of the three options costed in the roadmap: not throwaway mockups,
    not the whole phase. Three admin-only routes under /proposition rendering the
    proposed shapes against real data, beside the pages they would replace.
    _detail_page.html.twig shape 2 — breadcrumb, identity card with the small
    uppercase status strip and a quiet Edit link,
    label-above-value rows, verbs at the card foot,
    provenance line, right rail of related objects with
    sentence empty states
    _list_page.html.twig shape 1 — al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
2026-08-01 feat(proposition): rework the list — categories as a filter bar, not sections
    Three passes, and the second was wrong in a way worth recording.
    Pass 1 was rebuilt from nothing: 22 KB against the real page's 89 KB. It read
    as a downgrade because it WAS one -- image, favourites, description and level
    all dropped. A shape can only be judged against the same payload; that was a
    content comparison wearing a layout comparison's clothes.
    Pass 2 started from the real markup so .machine-card, .machine-status and
    .badge-tag keep the polish they already have, then grouped the grid into one
    section per category.
    Pass 3 undoes that grouping. Eleven machines across six categories renders one
    card and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
2026-08-01 docs: S74 brief settled by the prototype, and S75 removes favourites
    The category quick-filter bar is now S74's brief rather than an open question,
    approved by inspection at /proposition/machines.
    Recorded the mistake so it is not re-proposed: grouping the grid into one
    section per category produces one card and three empty cells, six times down
    the page. A group of one is a row of one. Categories as a persistent tile bar
    ended up MORE prominent than headings were, and the grid below stays full.
    Also settled: the icon belongs to the category, not the machine, and is
    repeated on every card as the grid's visual sort key; categories live inside
    the machines feature and are operator-editable;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
2026-08-01 feat(proposition): condense the machine card vertically
    The badge-tag row was the tallest thing on the card for the least information:
    two chunky pills carrying the category and the level. The category is already
    the icon in the card header and the tile you filtered by, and both names are
    spelled out on the detail page — so the row goes, which is most of the saving.
    Also: media box 16/10 -> 16/9, tighter body and header padding, and the level
    demoted from a pill to a quiet label sitting beside the action.
    Nothing that answers a question was removed. The status pill, the category
    icon, the location, and the can-I-use-this-and-when line all stay.
    Verified after deploy: 0 badge-tag, 11 sli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
2026-08-01 feat(proposition): promote the machine identity, demote the type
    Operator: a machine has a name but above all a make and model, and that should
    stand out.
    ⚠️ Machine has NO brand and NO model column — checked. The make is smuggled
    inside nom: 'Imprimante 3D Ultimaker S5', 'Imprimante 3D Prusa i3 MK3S',
    'Découpeuse Vinyle Silhouette'. The string that identifies the machine to a
    member is glued to the string saying what kind of thing it is, so the model
    cannot be searched, filtered, sorted or shown on its own.
    No fields were invented and no names were parsed. What this does is fix the
    HIERARCHY with the data that exists: the name becomes the headline at
    --font-size-lg/bold, because th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
2026-08-01 feat(proposition): one availability indicator, not two
    The machine-status pill in the header and the 'Libre' dot in the body were two
    renderings of the same fact -- the card said the machine was available twice.
    The dot-and-word version takes the pill's place and the pill is deleted.
    What stays in the body is the half that was never redundant: WHEN. 'Réservable
    dès 03/08 à 08:00', or 'Aucun créneau sur 14 jours', and nothing at all when
    there is nothing to say -- the paragraph is not rendered rather than left as an
    empty gap.
    ⚠️ The time stays gated on authorisation even though the state word no longer
    is. 'Libre' is a fact about the machine and is safe to show an untrained
    member;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
2026-08-01 feat(proposition): four availability states, and "Libre" now means free NOW
    "Libre" meant "a bookable slot exists somewhere in the next fortnight", which
    on a busy machine is tomorrow -- the card said Libre about a machine someone was
    standing at. It now means free now: NextFreeSlotService never returns a slot
    that has already begun, so a start inside the next hour means nothing is
    running. Otherwise Occupée, or Complet when there is no slot at all.
    ⚠️ Which immediately exposed a worse bug, and only by measuring: on a Saturday
    all ten machines rendered "Occupée" -- because the next slot was Monday 08:00.
    Nothing was occupied. THE LAB WAS SHUT. Blaming eleven machines for the calendar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
2026-08-01 feat(machines): ship the S59 list shape on the real /machines page
    Promotes the reviewed /proposition layout to production. Replaces a 494-line
    page that filtered client-side over every card in the DOM with ~250 lines of
    inline JS.
    - Categories are a persistent filter bar with per-category free counts, not
    headings: a group of one is a row of one, and sections left three empty cells
    beside most categories.
    - Filtering is server-side, so the URL is shareable and the page works with no
    JavaScript.
    - Five availability states, checked in order, with 'labo fermé' BEFORE busy --
    a shut venue is not a busy machine.
    - Availability (header) and permission (footer) are separated by position,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
2026-08-01 fix(s38): stop publishing badge UIDs and names on the public API
    GET /api/leaderboard returned, unauthenticated and from the internet, real
    names paired with their physical badge UID — the credential the door and
    machine readers trust. Confirmed live before touching anything.
    The recorded finding listed 3 endpoints. Fetching all 18 GET endpoints
    anonymously and reading the payloads — the check the finding itself demands —
    found 8:
    narrowed (field dropped, endpoint stays public)
    /api/leaderboard rfid + real name
    /api/calendar name + free-text motif, every booking
    /api/machines/{id}/reservations name + motif
    gated ROLE_ADMIN
    /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
2026-08-01 docs: the timezone audit — two conventions, no data migration needed
    Convention A (machine timestamps: createdAt, LogUtilisation, Progression,
    CURRENT_TIMESTAMP defaults) is stored UTC and displayed without conversion —
    that is the 2h bug. MariaDB is on UTC too, checked, so the SQL defaults agree
    with the PHP ones.
    Convention B (human-entered wall-clock: Reservation, Event, OpeningHours,
    access passes) is stored in lab time and displayed raw — already correct. The
    rule is documented in StaffController ~126.
    So the fix is the opposite of pinning Europe/Paris everywhere: pinning a B
    field double-shifts it, and opening hours would go from 08:00 to 10:00. And no
    global default can work,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
2026-08-01 feat: the lab timezone is an operator setting, applied per convention
    Finishes what the reverted date_default_timezone_set() attempt could not. The
    box runs UTC and the fallback is Europe/Paris, so before this an install
    anywhere else showed every recorded timestamp in the wrong zone, and this one
    showed badge scans two hours early.
    The audit (S38b) found the database holds two conventions, each self-consistent,
    so nothing stored had to move — no data migration:
    A machine timestamps — createdAt, created, updated, LogUtilisation,
    Progression, derniereConnexion, and every CURRENT_TIMESTAMP default
    (MariaDB is on UTC too, checked). Stored UTC, displayed unconverted.
    That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
2026-08-01 fix(s38c): the surfaces the visibility setting did not reach
    Closing the calendars was not the end of S38. A sweep of every public page for
    known-real badge UIDs and real names — rather than of the pages just touched —
    found two more leaks, both live and both anonymous:
    /machines/{id}/historique badge UIDs in clear (8C52B359, 39F1C387, ...), plus
    the name on every scan, work session and booking.
    The JSON endpoint of the same name was gated an
    hour earlier; the page rendering the same rows was
    missed. Names now follow BookingIdentityPolicy; the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
2026-08-01 docs: S77 and S68 decided together
    Four product questions answered, so the next session builds instead of
    deliberating:
    - "Terminer maintenant" is its own action, separate from cancel. The booking
    stays attributed and counts as honoured; only its end moves. It is never
    blocked by the lock window — someone standing at the machine who has
    finished is doing the lab a favour.
    - Rescheduling is an atomic swap, not a mutation: the old slot is held until
    the new one is confirmed. Reuses the existing booking path rather than a
    second one where quota, opening-hours, conflict and qualification rules can
    silently diverge.
    - The lock window blocks cancel and reschedule,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
2026-08-02 feat(s78): admin form theme, meta-grid partial, and a live 500 fixed
    Step 5 of docs/UI-CONSISTENCY.md, plus a pre-existing breakage found by
    sweeping every route rather than the touched ones.
    form/admin_theme.html.twig
    --------------------------
    Twenty admin pages wrote the same four-line wrapper once per field —
    **116 times** — which is form_row() with extra steps and four chances to
    differ. With the theme applied a page writes {{ form_row(form.nom) }} and
    the markup is defined once.
    ⚠️ Applied per form with {% form_theme %}, never globally in twig.yaml: a
    global theme restyles booking, registration and the install wizard in the
    same commit, and none of that is render-testable fro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
2026-08-02 fix(s59/s77): the card clipped its own actions — every control was invisible
    Reported as "I only get the View button". Not caching, not the account: a
    CSS clip that has been hiding the card's `actions` block since the block was
    added.
    `.ml-card` is a grid item stretched to the row height and clips with
    `overflow: hidden`. `.ml-card-link` took `height: 100%` of that, so anything
    the `actions` block rendered — a sibling *after* the link — was pushed past
    the card's height and cut off.
    Measured in a browser, same probe button both ways:
    old css: card bottom 849, button bottom 892 -> 43px past the clip, invisible
    fixed: card bottom 849, button bottom 832 -> inside
    So the cancel fo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
2026-08-02 style(s77): the card's actions are one button row, cancel in the danger tone
    Reported: the three controls read as three unrelated bits of furniture. They
    were literally three different things — a bare link (.ml-reset), a button,
    and a <details> sitting outside the actions div on its own line.
    - All four controls are now .ml-btn peers inside .ml-card-actions, equal
    height whatever element they are (a link, a button in a form, a summary).
    - Ordered by consequence, left to right: look · finish · move · cancel, so
    the irreversible one is furthest from where the pointer rests.
    - Cancel takes a new .ml-btn-danger — outline, not filled. The filled style
    is spent on "Terminer maintenan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
2026-08-02 fix(s77): cancelling a past booking is a staff act, not a member one
    Reported: "you left cancel on past reservations. I think only staff/admin
    should be able to do this from the admin menu."
    Right, and that blanket allow was mine rather than a decided rule. judgeCancel
    asked isGranted('ROLE_ADMIN') and nothing else, so an operator saw "Annuler"
    on their own bookings from last March — a records-management control sitting
    on a personal page.
    Role says what you *may* do; context says what you are *currently doing*.
    Conflating them is what leaked the power. New VerbContext:
    - Member (the default everywhere): nobody cancels a booking that has started
    or finished, whatever their role. A run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
2026-08-02 fix(s59): formations — green "Terminée", and 8 broken images per page
    Asked for the completed state to be green; looking at it surfaced two real
    faults on the same cards.
    1. "Terminée" was grey — the same weight as "Non commencée", its opposite.
    The foot had only two tones (quiet grey, warning amber). New .ml-req-ok.
    ⚠️ Green was originally ruled out here with a recorded reason: it would
    collide with the green "Libre" dot in the head. That still holds on any
    card that draws a head state chip, so `ok` is opt-in and documented as
    only correct where there is none. /formations passes no `state`, so it is
    the one surface where green is unambiguous.
    Measured in the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
2026-08-02 fix(s59): a Twig comment closed itself early and printed onto /formations
    Operator screenshot: a sentence from one of my own code comments was
    rendering as page text, in a grid cell of its own next to the cards.
    Cause: the comment contained the literal comment-close sequence inside its
    prose — a note warning about a *different* Twig pitfall. Twig ends a comment
    at the FIRST close it finds, so everything after it became template output.
    Self-inflicted twice over: the sentence that leaked was the one explaining
    the previous mistake.
    Grepped the whole templates/ tree for the same signature; this was the only
    occurrence. Reworded so no comment-close appears in prose anywhere.
    Verified in th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
2026-08-02 feat(s59): badges — "Obtenu" takes the green tone too
    Same treatment as /formations: holding a badge is the thing a member is
    scanning the list for, and it rendered in the same grey as "À obtenir", its
    opposite. foot_tone was hardcoded 'none' for both states.
    ⚠️ Green is safe on this card, and for the reason already written at the top
    of badges.html.twig: a badge has no availability, so the head state slot is
    empty and there is no second green to collide with. That is exactly the
    condition documented beside .ml-req-ok — confirmed rather than assumed:
    zero .ml-state chips on the page.
    ⚠️ "À obtenir" deliberately stays neutral rather than taking amber. Not
    holding a badge is th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
2026-08-02 docs: hand over — S77/S78 into HISTORY, ROADMAP back to pending-only
    Prep for a context clear. The docs had drifted into claiming work was
    "awaiting deploy and verification" that is live, which is the one thing that
    would actively mislead a fresh session.
    - HISTORY.md gains the S77 + S78 account: the four verbs, the booking page,
    VerbContext, the signal vocabulary, and the five faults found by looking
    rather than grepping — including the card clipping its own controls, the
    UTC-offset comparison skew, and the /admin/settings 500 that predated the
    session.
    - ROADMAP.md drops both shipped write-ups and the superseded S77 brief,
    keeping only what is NOT done: what S77 left for S68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
2026-08-02 feat(s79): dates speak the reader's language, not PHP's
    Twig's |date() is PHP's date(), and PHP's date() has exactly one language:
    English. So |date('M') on the event badges printed AUG to a French reader
    looking at a French page, on a site whose default locale is fr and which
    ships five translation catalogues. Nothing in the translation layer could
    have fixed it — the string never went through the translator.
    |loc_date() formats through IntlDateFormatter with the request's locale, so
    it follows the language switcher rather than the server. The pattern is ICU
    (MMM, EEEE, yyyy) — the same vocabulary twig/intl-extra's format_datetime
    uses, so the call sites read like Symfony's own and thi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
2026-08-02 feat(s79): an event page shaped by the artwork it was given
    An organiser uploads one of two genuinely different things, and the old page
    treated both the same way — cropped to a 21:8 band with our own title written
    over it. For a photograph that is right. For a poster it is destructive: the
    poster's own title and date are printed inside the image, so the crop cut the
    words off and the overlay said everything twice.
    A poster is portrait and a photo is landscape — not a coincidence, that is
    what the two formats are on every wall. So EventArtwork measures the file and
    the page picks its shape from the answer. No new column, no migration, and
    nothing an operator can set wrong: uploading the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
2026-08-02 feat(s79): events join the catalogue, two per row
    /events was the seventh list in this codebase doing the same job its own way —
    its own grid, its own card, its own date badge, its own hover. That is exactly
    the drift S59 exists to stop: card spacing had to be changed in two places and
    was therefore changed in one. It renders through _catalogue.html.twig now,
    with a filter (à venir / passés / tous), the shell's search, and the shared
    card.
    The ONE thing that genuinely differs is density, and it is a number:
    `card_min: 29rem` on the shell writes --ml-card-min on .ml-grid, giving two
    per row at page width. Any catalogue that wants bigger cards passes the same
    parameter; none of them decla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
2026-08-02 feat(s79): the page body starts where the deck leaves off
    With the hours and the events answered in the hero, the two full-width
    sections that used to repeat them lower down are gone. The flow now opens on
    "comment ça fonctionne" — how to get started — and continues with whatever the
    operator has switched on: stats, the mini leaderboard, featured machines, RFID.
    ⚠️ The deck's two blocks stay fully switchable per audience from
    /admin/homepage, from the same rows as before. They are only removed from the
    PERSONALISATION modal: the deck has a fixed left/right arrangement, so a handle
    offering to drag them up and down a list they are no longer part of would be a
    control that does nothi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
2026-08-02 refactor(s78): step 6 — 89 of the 108 form triplets become form_row()
    The theme landed in step 5 and was proven on two pages. This is the rest: 16
    admin templates stop writing
    <div class="form-field">
    {{ form_label(form.x) }}
    {{ form_widget(form.x) }}
    <div class="form-errors">{{ form_errors(form.x) }}</div>
    </div>
    once per field, and write `{{ form_row(form.x) }}`. 105 insertions against 298
    deletions. `{% form_theme %}` is added per page, never globally — the property
    that made this safe to do in one pass is that a page without the tag renders
    exactly as it did before.
    ⚠️ **19 triplets are deliberately left.** Three shapes the theme does not
    reprod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
2026-08-02 docs: S79 into HISTORY, step 6 into UI-CONSISTENCY, ROADMAP to step 7
    The three notes worth carrying forward regardless of what the next session
    touches:
    - Any image feature here must ask ORIENTATION before it asks dimensions.
    getimagesize() reports stored pixels, the browser draws EXIF-corrected ones,
    and exif_read_data() does not read PNG at all.
    - The route sweep was checking less than it claimed: it probes {id} as 2, and
    institutions start at 5. Every */2/edit line was a 404 being read as swept.
    - x|default(true) fires on empty as well as undefined, so a `false` parameter
    comes back true. Boolean shell parameters need `is defined ?`.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
2026-08-02 refactor(s78): step 7 — 3 of 46 admin heads onto the shell, plus the recipe
    `base.html.twig` was already the admin shell with 23 templates extending it.
    The 46 standalone admin templates do not need a new layout — they need
    converting to that one. Three converted as proof of shape, which is how steps 3
    and 5 were done here and the discipline this step's own risk note asks for.
    🔴 **Fixed on the way: the shell had no favicon.** All 46 standalone siblings
    carried `<link rel="icon">` and base.html.twig did not, so the 23 pages already
    extending it had no icon at all — and any page converted to it would have lost
    one. base_public.html.twig has carried the line all along.
    Verified by re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
2026-08-04 feat(s80): uploads are capped at the door, on all five paths
    What a camera hands over is not what a web page needs. The two event posters on
    the live box were 5712×4284 PNGs of 22.7 MB each, because nothing between the
    camera and the disk had an opinion. S79 fixed the symptom on one surface — a
    cached display copy — while every other upload path still stored whatever it
    was given.
    `ImageNormalizer::capUploaded()` now rewrites an upload in place before it is
    stored: upright, capped at 2400px long edge, re-encoded. Measured against the
    real file: **22.7 MB → 0.73 MB, and 5712×4284 landscape → 1800×2400 portrait**,
    because that file's EXIF orientation is 6 and the stored pixels were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
2026-08-04 refactor(s78): step 4b — nine bespoke tables onto the shell, and eight dark-mode holes with them
    The plan warned that the twelve bespoke-class tables might not take
    `.admin-table` as a visual no-op. Reading them showed the opposite: they are
    the same table twelve times with drifted numbers — width 100%, collapse,
    9–13px padding, a bottom border and a small uppercase header. The class names
    recorded the drift, not an intention.
    Nine converted to `_data_table.html.twig`: usage logs, RFID access logs,
    missing pages, portals, RFID readers, staff access passes, booking-policy
    quotas, homepage visibility, opening hours. 28 dead CSS rules went with them.
    🔴 **Four of those rules hardcoded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
2026-08-04 refactor(s78): step 7 — all 44 admin heads onto the shell
    Every admin and staff template now extends `base.html.twig`. **Standalone
    `<!DOCTYPE>` in templates/site/admin-*: 46 → 0.** The seven left are the kiosk
    screens, the ticket, the publish page and `base_public.html.twig` itself —
    pages that carry no header or footer by design, which S46 exempted for the same
    reason.
    They needed no new layout. `base.html.twig` was already the shell with 23
    templates on it; the other 44 were the same skeleton written out longhand.
    🔴 **`main.js` was missing from 35 pages that include `_header.html.twig`** —
    so the mobile-nav toggle it wires up has been dead on all 35 for as long as
    they have e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
2026-08-04 refactor(s78): step 7 second half — the literal colours become tokens
    221 hex literals in template `<style>` blocks are now tokens: 58 backgrounds,
    83 borders, 80 text colours, across 38 files. Plus 59 tinted status grounds and
    their inks.
    ⚠️ **Mapped by PROPERTY, never by value.** `color: #fff` on a primary button
    must stay white; `background: #fff` on a card must not. A blanket value swap
    cannot tell those apart, which is why 793 occurrences were never one problem —
    412 are deliberate and remain (brand hex, SVG fills, matched status pairs).
    🔴 **The first attempt broke two chips, and the audit caught it.** `.reader-help`
    and `.status-pill.inactive` keep a light tint of their ow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
2026-08-04 fix(s81): one menu, built from the feature toggles, on every page
    **Why it changed between pages — three separate causes, all now gone.**
    🔴 **Eight admin pages hand-rolled their own `<header class="site-header">`**
    instead of including the shared one. That copy had a FLAT, hardcoded link list
    — no groups, no dropdowns, no NavBuilder — so it was missing Espaces, Objets
    prêtables, Matériaux, Annuaire, Événements and Admin, in a different order, and
    it never emitted an active state. All eight now include
    `site/_header.html.twig`. Measured after: **7 nav entries on every page**,
    public and admin alike.
    🔴 **Its search box was a bare `<input>` and `<button>` with no `<form>`.**
    S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
2026-08-04 fix(s81): the nav was clipping its own submenus, and doubling the alert bar
    Two faults I introduced yesterday, both reported from the running site.
    🔴 **`overflow-x: auto` on `.navbar-container` clipped every dropdown.** It was
    there so a menu too long for the bar would scroll instead of wrapping — but
    `overflow` on ANY axis makes an element a clipping context, and
    `.navbar-dropdown` is `position: absolute` inside it. So all 17 submenu links
    were in the markup and none of them could be seen. `nowrap` alone keeps the
    header one row high; the burger breakpoint is what handles a menu that genuinely
    will not fit.
    🔴 **Two cookie banners on the eight converted admin pages.** `_header.html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
2026-08-04 fix(s82): the admin lists stop looking like fifteen different products
    Every admin list does the same three things — offer an "add", offer some
    filters, show a table — and they were doing them four different ways.
    🔴 **The add button had FOUR class combinations across fifteen pages**:
    `btn btn-primary`, `btn-link btn-primary-admin`, `btn-primary`, and
    `btn btn-primary btn-small`. The first is the PUBLIC button leaking into admin
    headers, where it renders at roughly twice the size — which is why the machines
    page had a slab and the places page had a chip for the same action. One class
    now, on all sixteen: `btn-link btn-primary-admin`, the admin-native one.
    Some of those anchors also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
2026-08-04 fix(s83): the calendar's private palette follows the theme (partially)
    🔴 **Measured on the running site:** in dark mode `.calendar-modern-page` came
    out with a near-white ground, `rgb(246,248,251)`, while its cards resolved to
    `rgb(36,29,45)` and its text to `rgb(248,242,247)`. Dark cards and light text on
    a white page.
    The cause is that the calendar carries a **private palette** — nineteen
    `--cal-*` tokens at the top of `calendar-modern.css` with hardcoded light values
    — so the dark-mode sections further down were fighting them. Those tokens now
    have dark definitions expressed in terms of the site tokens. Cards and text
    measured after: **17.4:1 light, 14.77:1 dark.**
    ⚠️ **PARTI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
2026-08-04 fix(s83): found it — a blanket `background: transparent !important` was eating the calendar's ground
    🔴 **The culprit, in `style.css`:**
    html[data-theme="dark"] body :is(.main-content, .page-content, .admin-page,
    .admin-layout, …) {
    background: transparent !important;
    }
    `.calendar-modern-page` is ALSO a `.main-content`, so it was caught. Specificity
    decides it and the numbers are not close: that selector is **(0,2,2)** —
    `html[data-theme="dark"]` plus `body` plus `:is()` taking its most specific
    argument — while the calendar's own dark rule,
    `html[data-theme="dark"] .calendar-modern-page`, is **(0,2,1)**. With
    `!important` on t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
2026-08-04 refactor(s83): the calendar's palette is promoted into the site tokens
    The calendar had the best surface treatment in this codebase — a cool ground
    with white cards lifted on a soft wide shadow — and kept it in a **private
    palette of nineteen `--cal-*` tokens with hardcoded light values**. That is both
    why it looked good and why dark mode broke it: the theme had no way to reach any
    of them.
    **Three ideas were genuinely its own and are now site tokens, in both themes:**
    --surface-ground what cards sit ON. ⚠️ NOT `--color-bg`: making the ground
    and the paper the same colour is exactly what stops
    anything from popping. Light #f6f8fb, dark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
2026-08-04 feat(s84): the last two surfaces — .ev-card and the public .stat-card
    Closes the list S83 left behind. Three private copies of one idea, each broken
    a different way.
    🔴 **`.stat-card` in `style.css` was `background: var(--color-text-inverse)` — a
    TEXT token used as a surface.** `--color-text-inverse` is `#FFFFFF` and is
    deliberately never overridden in the dark block (inverse text stays white by
    definition), so every stat card on the site was a white box on a dark page —
    and no dark rule anywhere covered `.stat-card` to catch it. Same shape as the
    `--color-bg` / `--surface-ground` confusion one layer over: the token resolved
    to the right pixel in light mode, so nothing looked wrong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
2026-08-04 feat(design): data fills the width, the button never moves — and the answers
    Two constraints from the operator, and the three open questions closed.
    🔴 **`.admin-table` has no width rule at all** — not in `admin.css`, not in
    `style.css`. A `<table>` without one shrinks to its content, so all fifteen
    lists float to the left of an empty gutter as soon as the screen is wide:
    measured, 660 px of table in a 982 px panel.
    ⚠️ `width: 100%` alone is not the fix — the browser splits the surplus evenly
    and "Statut" ends up as wide as "Membre". The split has to be stated: ONE column
    takes the slack (`.is-grow`, the identity), the rest shrink to content
    (`.is-tight`, i.e. `width: 1%`, whic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
2026-08-04 feat(s85): the list shape, deployed to all 27 admin lists
    Validated on /admin/design, promoted to `admin.css`. The rules are CSS on
    purpose: 27 templates call `_data_table`, and a rule that must be pasted into 27
    files is a rule that will be in 24 of them by Christmas.
    **Shipped, all 27 lists:**
    🔴 **`.admin-table` had no width rule** — not in `admin.css`, not in
    `style.css`. A `<table>` without one shrinks to its content, so every list
    floated left of an empty gutter. ⚠️ `width: 100%` alone is not the fix: the
    browser splits the surplus evenly and "Statut" ends up as wide as "Membre". The
    split is stated — `.is-grow` takes the slack, `.is-tight` shrinks to content.
    Measured on t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
2026-08-05 fix(s85): the real reason the lists still didn't match — two skeletons, not one
    I claimed "all 27 admin lists" in the previous commit. That was wrong, and the
    operator was right to be confused.
    🔴 **Eleven list pages are on a different page skeleton entirely.** S82 recorded
    "15 of 15" — but that counted only the pages it had scoped. Counting every
    template that calls `_data_table`: **14 use `_admin_list`, 11 do not.** The ones
    that don't carry `.admin-header` / `.admin-main-content` (or a FOURTH family,
    `.admin-rfid-page` / `.admin-rfid-layout` / `.admin-rfid-panel`) plus 22–54
    lines of their own inline `<style>`. S85's table rules landed on all of them —
    they hang off `.admin-tab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
2026-08-05 fix(s85): bump the admin.css cache-buster — the whole rollout was invisible
    🔴 **`/admin/machines` had the new listing in its MARKUP the whole time** —
    `has-pinned-actions`, 11 icons, 11 `.admin-action` — and served none of it,
    because the page still asked for `admin.css?v=20260805-s84-surfaces`: the exact
    URL every browser had already cached BEFORE S85 changed that file. I edited
    `admin.css` four times today and bumped `?v=` zero times.
    ⚠️ Worse, it was inconsistent rather than uniformly stale. Converting
    `/admin/utilisations` I typed a fresh `?v=…s85-lists` on that one page, so that
    page alone picked up the new stylesheet — which is exactly why the result read
    as random ra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
2026-08-05 docs: S85's honest state — 16 of 25 on the shell, and the two errors made
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2026-08-10 feat(s130): the admin navigation stops being a grab-bag
    "Le lieu" held Utilisateurs, Sous-lieux, Horaires, Thèmes, Réseau and Packages —
    six unrelated workspaces under a heading that named none of them, which is why
    "where do I manage X?" had no answer you could derive. Each is now its own
    canonical entry, matching the workspace list in `FeatureWorkspaceRegistry`.
    - **Lieux** (Sous-lieux + Horaires) is a real workspace section.
    - **Utilisateurs** replaces "Le lieu" and holds only users.
    - **Packages** and **Réseau FabOS** each get one canonical entry.
    - **Configuration** opens on Réglages and gains État de l'installation (out of the
    unlabelled kernel block, where it read as a landi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
2026-08-10 fix(s132): the shared layer takes back the components pages were re-styling
    Continues the S132 measurement. Four groups of page-local CSS removed — and two
    of them were hiding live dark-mode bugs rather than merely duplicating.
    **The sidebar (9 templates).** `.admin-sidebar` and `.admin-nav-link` are the
    sidebar partial's own styles, re-declared locally and drifted into four variants.
    🔴 Five pages hardcoded `background: white` — Réglages, E-mails, Accueil,
    Horaires and the dashboard had a white sidebar on a dark page. `style.css` has
    owned `.admin-sidebar` correctly with `var(--theme-surface)` all along, and its
    own comment says page-local `<style>` loads after it and wins; these fi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
2026-08-10 fix(s132b): the hours screen wrote one venue's week onto another's
    S131 shipped a variable-name mismatch: the controller passes `venueContext`,
    the template read `venue_context`. `strict_variables: true` is set only under
    `when@test`, so in prod the name resolved to null in silence instead of throwing.
    Three consequences, in increasing order of damage:
    1. `{% if venue_context.venues|length > 1 %}` was always false — the sub-venue
    picker never rendered for anyone, so the feature S131 exists to deliver was
    not reachable at all.
    2. The heading never named the venue being edited.
    3. 🔴 `path('app_admin_opening_hours', {location: venue_context.location})` emitted
    an empty `location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
2026-08-10 fix(s133): two dated regressions — a literal key, and "À venir" computed in UTC
    **The literal key.** `/admin/machines` printed `admin_list.all` as its "All" tile.
    The controller had been setting `label_is_key => true` correctly all along;
    `_admin_list` honours that flag in its single-row tile path and **never did in the
    grouped path** (`list_tile_groups`), which is the one the machines facets use. One
    renderer was listening and the other was not. Fixed in the shell, so any future
    grouped tile inherits it.
    **"À venir" in server UTC.** `Event` is convention B: `dateDebut`/`dateFin` hold
    the wall-clock digits the operator typed, not UTC instants. Three places compared
    them against `new Dat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
2026-08-11 i18n(s134c): dashboard and settings translate; FabOS stops shipping as ENSEA
    **Dashboard and Réglages are at zero hardcoded strings.** 19 + 20 keys across the
    five catalogues, parity checked. Two things fixed on the way that were not
    translation problems:
    - 🔴 **The dashboard carried a hand-copied footer with seven dead `href="#"` links** —
    Documentation, Support, API, Statut, Mentions légales, Politique, Conditions —
    while every one of those routes exists and the shared partial already links
    them. It also hardcoded `© 2026` and skipped the catalogues entirely. Replaced
    with `_footer`; that is the same fault S84 removed from five other pages.
    - **The greeting said "Bienvenu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
2026-08-11 i18n(s134c): six more screens, and the pairing runbook stops existing twice
    **Six screens at zero hardcoded strings**, verified by scanning them: liste des
    lecteurs RFID, assistant de configuration initiale, dérogations de quota, parcours de
    formation (`_formation_journey`), éditeur de quiz. 138 keys across the five
    catalogues. `debug:translation --only-missing` is clean in the `messages` domain for
    all five locales, and every touched page renders 200 on Artemis with no raw key.
    **The pairing runbook was duplicated in full.** `admin-rfid-readers` and
    `admin-rfid-reader-form` each carried the same nine-step modal, the same shell
    blocks and the same open/close script — ~45 lines, byte for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
2026-08-11 i18n(s134c): four more screens, and the three languages nobody could choose
    **Four screens at zero hardcoded strings**: éditeur de contenu de formation (the
    92-literal one), profil, édition d'un événement, calendrier machine. 153 keys across
    the five catalogues. `debug:translation --only-missing` is clean in the `messages`
    domain for all five locales, and every touched page renders 200 on Artemis with no
    raw key.
    🔴 **FabOS ships five languages and a member could only ever pick two.** The profile
    language selector offered `fr` and `en`; so did its save path in `SiteController`,
    which rejected anything else with "Langue invalide."; so did the admin's create-user
    form. Meanwhile `config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
2026-08-11 tools(s134c): keep the i18n scripts, so the next session does not rebuild them
    `FabApp/tools/i18n/` — the three scripts this session's four batches were done with,
    plus a README covering the workflow and the two rules the scripts cannot enforce.
    Python 3 only, no PyYAML, so they run on the Mac where there is no PHP.
    - `scan_hardcoded.py` — what is left to translate, ranked. A **heuristic upper
    bound**, not a bug count: it still flags multi-line Twig expressions, form
    `value="save"` attributes and format examples. The README says so, because a number
    from it read as a finding would be wrong.
    - `parity.py` — keys missing from any of the five catalogues. Parses the nesting,
    ancho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
2026-08-11 i18n(s134c): eleven more screens, and the machine status that spoke two languages
    Fifth batch of S134c. Eleven templates go to zero hardcoded strings:
    Logs RFID, section de formation (création/édition), Interface accueil,
    Thèmes, Gestion des réservations, détail d'un badge, détail d'une machine,
    suivi de formation, Gestion des formations, Prêts, Utilisations machines.
    1 030 keys added (206 × 5 languages); parity.py reports 0 MISSING.
    Not only literals, found on the way:
    - The machine detail page computed its own status labels from
    `machine.statut`, so `machines.st_available` / `st_maintenance` /
    `st_broken` existed in five catalogues while the page printed French
    constants ne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
2026-08-11 i18n(s134c): five more screens, and the calendar's twenty invisible strings
    Sixth batch of S134c. Five templates go to zero: publier une création,
    modifier une machine, horaires d'ouverture, détail d'une formation,
    calendrier. 79 keys added (× 5 languages); parity.py reports 0 MISSING.
    - **The calendar's booking flow was French-only in every language.** Twenty
    strings lived inside its inline `<script>` — the slot states, the booking
    panel's four validation messages, "Réservation refusée", "Semaine ${n}".
    A note in that block already said so and asked that no new one join them;
    they now come from the catalogue through one `T` object, the same way
    `MANAGE_LABEL` already did.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
2026-08-11 i18n(s134c): six screens, the second calendar, and one place that decides what a machine's status says
    Seventh batch of S134c. Six templates go to zero — modération créations,
    Fonctionnalités, créer une machine, gestion des machines, modifier une page,
    et le calendrier machine. 56 keys added (× 5 languages); parity.py reports
    0 MISSING.
    🔴 **`disponible` and `idle` were two tiles for one state.** The stored
    `statut` column is free text; the shipped default is `idle`, the seeded rows
    say `disponible`, and the admin machines list grouped its status tiles by
    that raw string and printed it in the cells — two chips meaning the same
    thing, in two languages, on a French page, next to a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
2026-08-11 i18n(s134c): the browser tab titles, sixteen small forms, and the dashboard's French PHP
    Ninth batch of S134c. 630 literals left, from 720.
    🔴 **A third blind spot: `{% block title %}` is not scanned either.** Forty-one
    templates carried a French browser tab title — every admin create/edit form,
    the dashboard, the login page, the profile. Twenty-eight are translated here
    (the rest are the deferred development-mode and `static/*` pages), and the
    grep that finds them is now in `tools/i18n/README.md` next to the two for
    JavaScript. What remains in that list is either a bare variable or a `|trans`
    call; a French word there is a bug.
    🔴 **The dashboard's activity feed was built in PHP wit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
2026-08-11 i18n(s134c): the last of the list pages, and a fourth blind spot found
    Tenth batch. Every remaining admin list and small form is at zero: événements,
    institutions, pages personnalisées, matériaux (+ créer/modifier), objets
    prêtables (+ modifier), maintenance (+ la tâche), la galerie, la recherche,
    l'accueil, le leaderboard, la connexion et le catalogue partagé. ~65 keys × 5.
    Outside the deferred development-mode and static pages, `scan_hardcoded.py`
    now reports only noise: form `value=` attributes, URL placeholders and Twig
    expression fragments.
    🔴 **A fourth blind spot: French inside Twig expressions.** The scan reads
    text nodes and a few attributes, so a string in `|default('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
2026-08-11 i18n(s134c): the fallbacks, which is what a member sees when data is missing
    Eleventh batch, closing the fourth blind spot found in the tenth. **101
    French strings lived inside Twig expressions** — `|default('…')`, ternaries,
    `{% set %}` lists — where the scanner never looks, because it reads text
    nodes and attributes. Every one of them is a fallback: what a page shows
    exactly when the data is absent.
    - "Utilisateur inconnu", "Machine inconnue", "Ressource inconnue",
    "Formation inconnue", "Sans description", "Non renseigné", "Jamais
    connecté", "Localisation non renseignée" appeared in **eight templates
    each writing its own copy**. One `fallback` namespace now, plus the missin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
2026-08-11 design(s130e): rework the proposals onto the page shape the operator picked
    A's shape is validated: title left, sub-venue right in the hero — which means
    the create action cannot stay there, so it drops into the list header as the
    green + asked for, beside "11 machine(s)". All three proposals now share that
    shape and differ only in the filters panel, which is the part still open.
    A keeps a plain "Plus de filtres" drawer — closest to today, least code, but the
    drawer says neither what it holds nor whether it is active.
    B is two named tiers: the defining facet in one-click tiles, the rest as labelled
    dropdowns on a second line, and no drawer at all. Nothing hidden, grows in width.
    C bound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
2026-08-11 fix(s134h): the two Twig-3 traps the lint caught before the restart
    ⚠️ Both are lint-time failures that take the whole template down, and both are
    already in the deploy notes:
    - a {# … #} comment BETWEEN two keys of an argument hash is a syntax error.
    Five list templates had one. The notes are above the embed now.
    - {% for k, v in x if cond %} was removed in Twig 3; it is |filter((v, k) => …).
    Nothing reached the live site: lint runs before cache:clear and the restart,
    which is the whole point of that order.
2026-08-11 lists(s134h): the refine row fits on one line, and the count says something
    Two things the first render on CT 210 showed:
    - "Sub-venue shown" as a MENU key reads "Sub-venue shown: All sub-venues" and
    was wide enough on its own to wrap the whole Affiner row onto a second line.
    venue_context.menu / .menu_all are the short forms; the full sentence stays
    on /admin/horaires, where the picker is standalone.
    - the option that CLEARS a facet no longer carries a count. "All (11)" beside
    a header already reading "11 machine(s)" is the same number twice, and it is
    the one option whose count can never tell you anything.
    Measured on /admin/machines after: filter panel 213 px, Af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
2026-08-11 columns(s134i): six cell types, and the reason every state chip was grey
    The list format was settled; the CONTENT of the rows was not. Six cell types,
    each a class and a partial, demonstrated in /admin/design with this install's
    real machines:
    _cell_media thumbnail or initials disc, one size
    _cell_title what the row is, plus the quiet line that qualifies it
    _cell_state takes a SIGNAL — never a stored value interpolated into a class
    _cell_meter a number against its ceiling, with a bar
    _cell_date ⚠️ requires an explicit convention, machine | wall
    _cell_actions the row's verbs, at one size
    Every one routes its missing case through `_cell_empty`. The admin ha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
2026-08-11 docs(s134): Phase G3 livrée, et la mesure fausse qui l'avait cadrée
    ⚠️ La ligne S134j de la roadmap annonçait ~590 lignes de <style> local à
    supprimer sur sept listes nommées. Aucune de ces sept n'en a. Les nombres
    étaient les totaux de lignes des fichiers moins quatre. Corrigé sur place plutôt
    que supprimé : une session cadrée sur une mesure jamais revérifiée est le genre
    de chose qui doit rester lisible.
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2026-08-12 lists(s135): the two RFID screens join the shell, and ten columns become five
    Both hand-rolled their own page chrome, so neither had the hero, the filter
    panel, the search or the count line.
    **/admin/rfid-readers** — a 30-line local `<style>` deleted. It re-declared
    `.admin-page-header` and `.admin-panel-header`, carried `.btn-primary` and
    `.btn-danger` with the literal `#9E1B56` and `#b91c1c` the token layer exists to
    replace, and had a private `.status-pill`, a private `.empty-state` and a
    private `.reader-table-wrap` duplicating `.admin-table-wrap`. The modal rules
    stay — a pairing dialog is not list furniture.
    **/admin/access-rfid-logs** — ten columns became five, a reduction alr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
2026-08-12 lists(s135): the last two copies of the yes/no chip, and a sixth page skeleton
    `.badge-yes` / `.badge-no` was declared identically in admin-access-rfid-logs and
    admin-utilisateur-detail — a yes/no pair standing in for a state, which is why an
    UNAUTHORISED scan and a FAILED mail were two different reds. Both gone.
    /admin/access-rfid-logs' entire local `<style>` went with it: it re-declared the
    `.admin-rfid-*` chrome family — a SIXTH page skeleton in a codebase that spent
    S78 and S82 converging on one — plus a `.migration-note` on the literals `#fffbeb`
    and `#92400e` and an `.admin-rfid-nav a.active` on `#eef2ff` / `#3730a3`. Every
    one of those was a dark-mode hole.
    /admin/utilisateurs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
2026-08-12 vocabulary(s135): the column vocabulary moves to the sheet every page loads
    🔴 **A bug this session created, and caught by measuring.** `_cell_state` was
    put on `/machines/{id}/calendrier` — a PUBLIC page, which does not load
    `admin.css` — so the chip rendered with no rule at all. It is exactly the
    `.sr-only` fault: a shared component whose stylesheet is not shared works on the
    pages you tested and nowhere else.
    `.status-badge`, the `is-go` … `is-muted` signals and the whole `.cell-*` family
    now live in `components.css`, which `base.html.twig` emits on every page and
    whose own header says it is for shared member/admin components. `admin.css`
    keeps a pointer saying not to add cell ru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
2026-08-12 hero(s136): the compact band from the mockup, on Equipment only
    ⚠️ **S134h applied half the format.** The mockup's `dzf-pagehead` was always a
    short rounded strip INSIDE the content column; S134h put the green button into
    the existing full-bleed magenta slab and kept the slab. The operator saw it
    straight away — "you kept the old hero".
    `.admin-hero` is the mockup's values copied rather than re-invented: `.8rem 1rem`
    of padding, the 135° gradient from 82% to 55% of the accent mixed with black,
    `--border-radius`, and the add button on `margin-left: auto` at the mockup's
    compact metrics. Measured on /admin/machines: **62 px, against ~140 px** for the
    band it replaces.
    Reading down the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
2026-08-12 account(s134g): forgotten password, end to end, and the page that could not
    🔴 **`/forgot-password` was a dead page.** GET only, no form, no POST route — it
    showed a notice saying to contact an administrator. The login page links to it,
    so "Mot de passe oublié ?" led a locked-out member to a screen that could not
    reset a password. That is the dead-affordance family, in the one place where the
    person hitting it has no other way in.
    ⚠️ **Stateless tokens, so this shipped without a migration.** The exit criteria
    are "hashed, expiring, single-use". A signed token gives all three with no table:
    hashed HMAC-SHA256 over the payload, keyed with APP_SECRET. Carries no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
2026-08-12 design(s138): /admin/design becomes a guide, and the phase that follows it
    The page was 1 312 lines and half of it was a changelog: what was wrong in S85,
    what was measured before, which proposals lost. A designer opening it had to
    read history to find the rule.
    857 lines now, and prescriptive. Dropped: the S85 list narrative (280 lines) and
    the four catalogue-header proposals, which have served their purpose — the
    decision they produced is written up in their place as a spec with a 'do this'
    block and a 'not this' block. Kept: the token measurements, because they are a
    live instrument rather than a claim, and every section that renders a REAL
    component.
    The roadmap gains S138 — the va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
2026-08-12 docs: SSH moved to proxmox.lab.dryades.org:22 behind a tailnet
    ⚠️ artemis.dryades.org:4002 no longer answers, and it TIMES OUT rather than
    refusing — so an scp that freezes mid-session is this, not a hung transfer. That
    distinction is the useful part: the failure looks like a network stall.
    Same host (hostname still returns artemis), same containers, and the public site
    never went down. If SSH times out while https://fabos.dstei.fr answers 200, it is
    the access path and not the application.
2026-08-12 catalogue(s138): every control carries every other control's value
    🔴 **The operator's bug: sub-venue "bâtiment D", then click "Fraisage", and the
    sub-venue was gone.** `base_query` in `_catalogue` was the search term and
    nothing else, so a tile link rebuilt the URL from scratch and dropped the
    sub-venue and the refine menus with it. It is built once now — search +
    sub-venue + every set refine value — and used by the tile links, the "all" tile
    and the search form alike, so there is one place to add a filter to rather than
    three to remember. A tile still overrides its OWN key on top of it.
    Verified on the live page: `/machines?location=fabshop&niveau=niveau-1` renders
    tiles whose href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
2026-08-12 fix: close the media query that was swallowing 686 lines of style.css
    🔴 `@media (prefers-reduced-motion: reduce) {` at line 4647 opened, declared two
    rules, and **never closed**. Everything after it — the last 686 lines of the
    stylesheet — was nested inside, so it applied ONLY to visitors whose OS asks for
    reduced motion. Everyone else got none of it.
    ⚠️ Not mine: `git blame` puts it at commit d1aa40e4, 2026-08-04.
    ⚠️ **A stylesheet cannot report this.** It parses, it lints, and the rules simply
    do not match — there is no error anywhere. The check that finds it is counting
    braces:
    grep -o '{' style.css | wc -l vs grep -o '}' style.css | wc -l
    695 against 694. Wor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
2026-08-15 docs: cold-start position after the 2026-08-12 sessions
    Branch clean, everything deployed and hash-verified, nothing pushed.
    ⚠️ Records the two things a cold start would otherwise get wrong: SSH is
    proxmox.lab.dryades.org:22 behind a tailnet, and the session numbering collides
    with Phase H at S135-S138 — ask before writing another S13x.
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2026-08-16 search: /recherche looks at the whole product, not four tenths of it
    The operator searched `usb` and got nothing while a loanable item was named
    exactly that. Then `valentin` (a project), `D251` (a bookable place),
    `anniversaire` (a past event), the materials catalogue, and the body of every
    custom page — all invisible. Not a ranking problem: the page searched four
    kinds of thing out of ten and rendered a tidy "no results" for the other six,
    which is why it lasted.
    `SiteSearch` is now the one place that answers "what does this word match".
    Ten groups: users, machines, places, events, formations, badges, loanable
    items, materials, creations, custom pages.
    ⚠️ Every group is gated by it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
2026-08-16 search+events(s139c/d): compose instead of copy, delete the legacy, let a past event look past
    Three things, one deploy.
    S139c — /recherche renders `_cell_title` and `_cell_state` instead of drawing
    its own title, subtitle and chip. Three local rules gone, 23 → 20; ⚠️ the count
    is not the point, those three shapes just stopped being able to drift.
    🔴 `_cell_title`'s rules lived in admin.css, which a PUBLIC page never loads —
    word for word S135's fault with `_cell_state` on /machines/{id}/calendrier.
    Moved to components.css.
    🔴 Then the title rendered at 1.16:1 on dark: `.is-meta` names its colour and
    `.is-strong` left it to inheritance, in a codebase with several `!important`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
2026-08-16 s134g(2/2): the anonymiser and its guard — erase the person, keep the lab
    Operator's decision, 2026-08-16: "stats should stay, bookings and all… if user
    Pierre got deleted, we should still see his activity in stats, projects
    untouched, leaderboard as well. Maybe just his name gets changed?" So this is
    anonymisation, never deletion.
    ⚠️ That is also the GDPR-correct reading rather than a dodge: Article 17 is a
    right to erasure of PERSONAL data, and Recital 26 puts anonymous information
    outside the regulation entirely. Erase the identifiers, keep the rows.
    🔴 Which makes irreversibility the whole game. No deleted-users table, no
    archive copy, no audit row naming them. The address is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
2026-08-16 s134g(2/2): the operator's side of erasure, and the lockout invariant exercised
    The admin path runs the SAME AccountAnonymiser as the member's page. A second
    erasure written for the admin screen is a second definition of "erased", and the
    one that drifts is the one that leaves personal data behind.
    ⚠️ The refusal is shown on the panel, not hidden as a missing button. A control
    that vanishes teaches nobody why; "you would be erasing the last administrator"
    does. Same reasoning as the dead-affordance sweep.
    The guard now has a real unit test rather than a source-text one, because this
    is a decision with branches and 🔴 the one mistake nobody can repair afterwards.
    Two cases are the poi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
2026-08-16 docs(s134g): the erasure written down, and one open item corrected by measurement
    S134g is complete. HISTORY carries why anonymisation IS the GDPR answer rather
    than a dodge (art. 17 covers personal data; recital 26 puts anonymous data
    outside the regulation), why irreversibility is the whole game, and the reason
    each satellite table had to be scrubbed — the mail log's context names the
    machine and times someone booked, a guest registration holds a name typed
    outside the account, and a card uid identifies a person as surely as an e-mail.
    ⚠️ Also corrected an open item rather than inheriting it. The brief listed "the
    21 unreviewed email templates"; measured today, all 23 already go thr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
2026-08-16 fix(s134g): anonymisation 500'd on a setter that refuses null, and could half-happen
    🔴 The operator hit a 500. `Utilisateur::setPublicFields()` takes `array` and was
    handed `null`. My verification checked that each setter EXISTED and never that
    it accepted what I passed — the contract tests assert a setter is called, which
    a TypeError sails straight past.
    🔴 The worse half was the ordering. The raw DBAL scrubs ran first and autocommit,
    so a throw part-way left EXTERNAL_IDENTITY deleted and EMAIL_LOG scrubbed while
    the account still carried its name — a PARTIAL erasure, every part of it
    irreversible. The account it was tried on had no rows in either table, so
    nothing was actually lo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
2026-08-16 s140(essai): dans la carte fusionnée, l'en-tête de liste passe sous le titre
    Demandé en regardant l'écran : « Liste des machines » et la recherche
    remontent juste sous le bandeau coloré. L'ordre dans la carte devient
    bandeau → en-tête de liste (titre, compte, recherche) → filtres → lignes.
    Le premier essai avait gardé l'ordre des trois cartes séparées, et il
    était faux une fois fusionné : l'en-tête est ce que le bandeau annonce,
    donc il se colle à lui ; et le panneau de filtres touche alors les
    lignes qu'il restreint, au lieu d'en être tenu à distance par un
    en-tête.
    ⚠️ **Ce sont les FILTRES qui bougent, jamais l'en-tête.** L'en-tête
    porte `{% block panel_head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
2026-08-16 s140(essai): le titre de liste s'en va, le compte reste, la ligne maigrit
    Deux demandes, faites en regardant l'écran :
    **« Liste des machines » disparaît, le compte prend sa place.** Sous un
    bandeau coloré qui dit déjà « Gestion des machines », le titre de
    panneau disait la même chose deux fois ; le nombre est le seul mot de
    cette ligne que le bandeau ne porte pas. Il garde sa petite fonte
    discrète — l'essai en 22 px a été fait puis retiré.
    ⚠️ Le `<h2>` reste, en `sr-only`. Ce qui est visible est un compte et une
    recherche ; une section sans titre du tout est une régression de
    structure que personne de voyant ne remarquerait jamais.
    ⚠️ Et c'est `.admin-panel-note`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
2026-08-16 s141e: la revue de contenu, et deux tableaux qui mentaient depuis des mois
    La moitié intéressante de S141 : pas le CSS, le contenu des lignes. Vingt-cinq
    listes relues une par une, comparées à `/admin/utilisateurs`.
    🔴 **Deux tableaux avaient plus d'en-têtes que de cellules, et personne ne
    l'avait vu.** `/staff/acces-exceptionnels` déclarait **sept** colonnes pour
    six `<td>` ; `/admin/loans` **six** pour cinq. Dans les deux cas une valeur
    avait été repliée dans le sous-titre de la cellule de titre et l'en-tête
    qu'elle laissait derrière n'avait jamais été retiré. Rien ne plantait : le
    tableau dessinait simplement chaque colonne suivante **sous le mauvais nom** —
    les dates s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
2026-08-16 docs: la roadmap ne garde que ce qui reste (543 → 294 lignes)
    Demande opérateur : « shipped should go to history and be very succint ».
    `ROADMAP.md` perd les six tables de phases livrées (A à F), les récits de S135,
    S138, S139, S141 et de la Phase G3, et l'inventaire de vingt-quatre puces dont
    la moitié était faite. Ce qui reste est le travail restant, plus les décisions
    qui ne sont pas de l'histoire : cap produit, frontière d'instance, les neuf
    règles de construction, les décisions opérateur fixées.
    `HISTORY.md` gagne un **index d'une ligne par session, S102 à S141** — le
    registre de ce qui existe, à côté des récits détaillés déjà présents.
    🔴 **Deux choses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
2026-08-16 s143: « sous-lieu » devient « lieu » — location, Standort, ubicación, sede
    Mot choisi par l'opérateur le 2026-08-16, la décision attendait depuis le 11.
    Renommage de **catalogue**, pas de schéma : `Venue`/`VENUE`, `venue_context`,
    `?location=` et les noms de routes ne bougent pas. 155 chaînes dans les cinq
    fichiers de messages — FR lieu, EN location, DE Standort, ES ubicación,
    IT sede — plus 91 occurrences dans les commentaires de `templates/` et `src/`,
    parce qu'un code qui appelle la chose de deux façons est exactement la
    confusion qu'on corrige.
    Aussi les chaînes VISIBLES écrites en dur sur les trois pages de référence
    (structure, droits d'usage, design) : 15 phrase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
2026-08-16 s143b: le dernier bandeau plein écran, et les cinq familles qui le dessinaient
    Réponse à « admin_header? ». Le `.admin-header` du tableau de bord n'était pas
    une barre de titre : il portait l'accueil ET les sept tuiles de statistiques,
    posées sur le dégradé magenta, au-dessus de tout le reste. C'est une carte
    maintenant, avec la même bande `_admin_form_head` que les vingt-six
    formulaires.
    Ce que ça emporte :
    - **Le faux avatar.** `<div class="admin-avatar">AD</div>` — deux lettres en
    dur, jamais les initiales de personne. Supprimé avec ses règles.
    - **Vingt couleurs littérales.** Les sept tuiles portaient leur teinte DEUX
    fois dans le markup : un `style="background: rgb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
2026-08-16 docs(s143): le mot, le dernier bandeau, et la faute que le port a introduite
    Trois leçons consignées plutôt qu'un récit :
    - vérifier une inquiétude avant de la transmettre comme un fait (les aides
    ES/IT n'avaient pas besoin d'être réécrites, contrairement à ce que j'avais
    annoncé) ;
    - ne pas réintroduire un bandeau pleine largeur pour une page, c'est ainsi
    qu'il y en a eu cinq ;
    - une migration littéral→token n'est pas finie tant que le contraste n'a pas
    été remesuré : un token est correct par construction pour un fond, pas pour
    un premier plan.
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2026-08-16 s133b: groupes, audiences et grants v2 — en ombre, et explicable
    ⚠️ **Aucune autorisation vivante ne change.** Le chemin en vigueur
    (`USAGE_PACKAGE_FEATURE` → `grantingPackages()`) est intact et reste le seul que
    `UsageRightsService::verdict()` lit. Grants v2 est calculé À CÔTÉ et montré ;
    l'activation, chokepoint par chokepoint, est S134. Une migration qui se mettrait
    silencieusement à appliquer un nouveau modèle de droits est le pire résultat
    disponible ici, donc l'interrupteur n'y est pas.
    **Le modèle.** `USER_GROUP` + `USER_GROUP_MEMBER` avec les sept entrées
    intégrées aux clés stables ; `user` et `guest` sont semés `virtual = 1` et
    n'auront JAMAIS de ligne d'appar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
2026-08-16 s134b(fix): l'écran d'ombre passait son propre titre — AdminListShellTest l'a vu
    La règle de S141 : le titre d'une liste vient de NavBuilder, jamais de la page.
    L'écran a une entrée de menu, donc page_title y était une seconde copie du
    libellé, traduite cinq fois et libre de diverger de la ligne qui y mène.
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2026-08-16 s134b(fix): 1267 — ROLE et USER_GROUP n'ont pas la même collation
    🔴 `USER_GROUP` est créé par une migration qui nomme `utf8mb4_unicode_ci` ; `ROLE`
    vient de l'import du schéma legacy et porte le défaut plus récent de ce MariaDB,
    `utf8mb4_uca1400_ai_ci`. Le `=` entre les deux est l'erreur 1267 « Illegal mix of
    collations », et elle emporte toute la migration — ce qu'elle a fait au premier
    lancement. Chaque comparaison contre `ROLE.nom` force désormais la collation du
    côté ROLE, donc le résultat est comparé dans celle de la colonne visée.
    ⚠️ Leçon plus large que ce fichier : **toute comparaison entre une colonne du
    schéma legacy et une colonne créée par migration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
2026-08-17 s144c: un package sait dire COMBIEN — X heures de machine par semaine
    Seconde moitié de la phrase de l'opérateur. S144b a appris à un grant QUOI et
    QUAND ; ceci, c'est COMBIEN. Entre les deux, un fablab peut exprimer ce qu'il
    vend vraiment : accès illimité à une machine, heures creuses sur une catégorie,
    bloc d'heures prépayé, forfait de séances remis à zéro le lundi.
    `USAGE_PACKAGE_ALLOWANCE` : quantité + unité (minutes | réservations) + période
    (jour | semaine | mois | total), éventuellement restreinte à une fonctionnalité
    et à un type de ressource.
    - ⚠️ **Aucune allocation = aucun plafond**, jamais un plafond de zéro. Tous les
    packages existants n'en ont auc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
2026-08-19 docs(s144): les chemins d'écriture sont vérifiés sur la vraie base — 29/29
    Les GET ne prouvent rien d'un modèle dont tout l'intérêt est ce qu'il écrit. Une
    commande jetable — poussée dans le conteneur, exécutée, supprimée, jamais
    commitée — a exercé chaque écriture sur la base réelle DANS UNE TRANSACTION
    ANNULÉE À LA FIN, comptage avant/après à l'appui : 29 vérifications, zéro échec,
    zéro ligne survivante.
    Prouvé plutôt qu'argumenté, dans les mots de la demande :
    « imprimer en 3D le lundi après-midi »
    → lundi 15:00 AUTORISÉ · lundi 19:00 REFUSÉ · mardi 15:00 REFUSÉ
    « X heures machine par semaine »
    → 5 h contre 2 h/semaine REFUSÉ de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
2026-08-19 s145a: les horaires du BON lieu — le lecteur ne demandait jamais où
    🔴 `OpeningHoursProvider` résolvait la semaine en appelant
    `VenueRepository::findDefault()` — le lieu dont le slug est littéralement
    `default` — et ne lisait rien d'autre. `ReservationService` validait ENSUITE
    chaque réservation à travers lui **sans passer de lieu du tout**. Sur une
    installation multi-lieux, une machine du second lieu était donc contrôlée contre
    les horaires du premier ; et sans lieu `slug = 'default'`, toutes les
    réservations étaient contrôlées contre sept lignes en dur dans une constante PHP.
    ⚠️ **C'est la troisième fois.** Un grant limité à un lieu n'a rien fait pendant
    deux se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
2026-08-19 docs(s145a) : les horaires du bon lieu, et une entrée périmée corrigée
    🔴 **S134c2 était livré et figurait toujours comme à faire.** Vérifié dans le
    code, pas de mémoire : `FormationPageContentService.php:109` dit « les valeurs
    que S134c2 a retirées de DEFAULTS ». C'est précisément le mode d'échec que
    l'en-tête de ce fichier annonce — une session livrée qui reste ici finit par être
    refaite. Marquée ✅ avec la preuve.
    S145a inscrit dans le tableau de la Phase G2, au-dessus de S134d dont il n'est
    que la première marche : le lecteur sait enfin de QUEL lieu il parle, mais
    `UNIQ_OPENING_HOUR_VENUE_DAY` interdit toujours une seconde plage dans la
    journée. La pause méri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
2026-08-19 s134d: une journée peut porter plusieurs plages, une date peut réécrire la semaine
    Les deux limites que la feuille de route enregistre depuis S131, et qui
    empêchaient un labo de vendre du temps machine honnêtement.
    **Plusieurs plages par jour.** `UNIQ_OPENING_HOUR_VENUE_DAY` tombe. Pause
    méridienne, service du soir, journée coupée : exprimables. ⚠️ Supprimer un index
    unique est une DÉTENTE — sûr dans les deux ordres avec le code, l'ancien code
    n'écrivait simplement jamais de seconde ligne. L'inverse n'est pas vrai, donc
    `down()` ne le remet pas : le réajouter par-dessus deux plages est une erreur de
    clé, et choisir laquelle garder est une question de données.
    **Exceptio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
2026-08-19 s134d(fix): « non configuré » veut dire AUCUNE ligne — dans les DEUX endroits
    🔴 L'échelle de repli testait aussi `count($rows) === 7`. Je l'avais corrigé dans
    `rowsFor()` et manqué dans `defaultVenueRows()`, où c'était pire : dès que le lieu
    par défaut gagnait une pause méridienne il avait huit lignes, donc TOUT appelant
    qui interroge sans lieu — `rowsFor(null)` : l'accueil, le calendrier agrégé,
    l'API publique, l'amorçage de la semaine d'un nouveau lieu, et la disponibilité
    de chaque réservation de PERSONNE — recevait en silence la semaine intégrée
    08:00–20:00 à la place des vraies heures du labo.
    ⚠️ **Trouvé par une ligne de log au milieu d'un auto-test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
2026-08-19 docs(s134d): la semaine sait dire « fermé entre midi et deux »
    HISTORY : le récit, avec la leçon que le correctif a livrée — `count($rows) === 7`
    était à DEUX endroits, corrigé à l'un et manqué à l'autre, et c'est une ligne de
    LOG au milieu d'un auto-test à 29 assertions vertes qui l'a montré. Une assertion
    verte ne dit rien de la branche qu'elle n'emprunte pas.
    ROADMAP : S134d passe en livré, avec ce qui n'y est pas — la portée attachable
    (par workspace, par ressource). `ScheduleResolver` prend un lieu et rien de plus
    fin ; l'ajouter élargira un paramètre au lieu de réécrire les appelants.
    WORKING_BRIEF : nouvelle position.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
2026-08-20 docs(s134d): la portée attachable, et la branche de la règle que j'ai prise à l'envers
    ROADMAP : S134d complet, portée comprise. HISTORY : le récit, l'intersection et
    son prix, et le 500 d'ordre de déploiement. WORKING_BRIEF : rappel en tête —
    colonne ORM mappée ⇒ migration d'abord ; sonde DBAL fail-safe ⇒ le code peut
    partir devant. Les deux branches étaient déjà écrites ; j'ai pris la mauvaise
    parce que les deux sessions précédentes relevaient de l'autre.
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2026-08-20 docs(s134e): le modèle horaire est fini
    ROADMAP : S134e livré. HISTORY : le récit, la faute silencieuse de `/places`
    (ordre des lignes, prod sans `strict_variables`), et la leçon des deux
    assertions qui avaient tort — `json_encode` échappe le non-ASCII, donc une page
    ne contient jamais le littéral accentué. WORKING_BRIEF : nouvelle position.
2026-08-20 todo(s146): la fiche porte son calendrier, le calendrier porte l'espace — revu
    Proposition opérateur du 2026-08-20, revue et **logguée sans être construite**.
    ⚠️ Elle est déjà la politique de la feuille de route (« réservations, quotas et
    reporting montrés dans chaque feature ») appliquée au calendrier, qui ne l'avait
    jamais suivie.
    🔴 Constat qui change la forme de la proposition : **les formations n'ont pas de
    sessions**. `Formation` porte `duree` et `formateur` en texte libre et aucune
    date ; il n'existe ni entité session ni table. C'est pourquoi S134c2 a dû
    supprimer le bloc « trois prochaines sessions » — il les inventait. `Event`, lui,
    a déjà la forme exacte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
2026-08-20 s146a: un seul calendrier — semaine ET mois, et le lieu enfin demandé
    Les deux calendriers portaient douze fonctions JS homonymes, et dans la seule
    session S134d/S134e la même règle d'ouverture y a été modifiée quatre fois.
    Ce n'était pas de la dette esthétique : c'était le prochain endroit où le
    calendrier et le refus de réservation allaient se contredire sur un jour férié.
    Il y a maintenant UN calendrier :
    - `assets/controllers/calendar_controller.js` — rendu, vues semaine et mois,
    règles d'ouverture (exception datée d'abord, puis les PLAGES, jamais
    l'enveloppe — les mêmes règles que `ScheduleResolver`), panneau de réservation ;
    - `site/_calendar.html.twig` + `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
2026-08-20 s146e: s'inscrire à une séance inscrit à la formation — et ne qualifie jamais
    `App\Calendar\SessionEnrolment`, appelé depuis `EventRegistrationService`.
    🔴 ASSISTER NE QUALIFIE JAMAIS, et c'est là que la ligne est tracée. Un badge dit
    qu'une personne peut utiliser une machine sans surveillance ; être venue un soir
    n'en est pas la preuve, et c'est un formateur qui valide. L'inscription écrit une
    `Progression` COMMENCÉE : `completed = false`, `score = 0`, aucune date de fin,
    aucun badge. `SessionEnrolmentContractTest` échoue si quelqu'un écrit le
    contraire.
    🔴 Une progression existante est renvoyée INTACTE : quelqu'un qui a déjà trois
    quiz derrière lui ne doit pas perdre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
2026-08-20 s146: revue de fin de phase — et le formulaire de catégories ne se vide plus
    Revue faite en ligne (l'opérateur : « run the review inline »), mandat designer
    d'Apple : clics avant/après, évidence du chemin, frappes, champs superflus.
    🔴 UN DÉFAUT TROUVÉ ET CORRIGÉ, sur la règle écrite en rouge. L'écran des
    catégories d'événement répondait à un nom déjà pris par un flash + une
    redirection : l'opérateur récupérait un panneau REPLIÉ et VIDE, et devait
    retaper le nom et l'icône. Rendu sur place en 422 avec les valeurs saisies, et
    le `<details>` s'ouvre. Le formulaire d'événement, lui, ne perdait rien —
    vérifié champ par champ, catégorie et réglages de répéti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
2026-08-20 s146: la légende dit « Ouvert » là où rien ne se réserve
    Une pastille verte est une heure d'OUVERTURE. Sur une page qui peut réserver,
    une case vide est aussi une heure qu'on peut prendre, et c'est ce que
    « Disponible » dit. Sur `/calendrier`, plus rien ne se prend depuis S146c : le
    mot promettait un contrôle absent. Le partial choisit donc le mot selon
    `booking` — « Disponible » sur la fiche machine et sur l'espace, « Ouvert » sur
    le calendrier d'activité.
    🔴 Et le premier correctif n'a RIEN changé : `booking|default(true)` est
    toujours vrai. Le `default` de Twig se déclenche sur toute valeur VIDE, et
    `false` est vide, donc `booking: false` résolvait à `true`. C'est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
2026-08-20 s146g: la rangée des fermetures est réparée, et une fermeture peut durer une semaine
    Deux demandes de l'opérateur sur le même écran.
    🔴 LA MISE EN PAGE : deux systèmes se battaient sur un même formulaire. Il
    portait `.usage-assignment-form .usage-grant-form` — une grille à colonnes fixes
    écrite pour l'attribution de packages — autour d'enfants `.afp-select`, qui
    appartiennent à la rangée flex `.afp-tier`. Mesuré sur la page : contrôles de
    46, 22, 13, 46 et 46 px, lignes de base écartées de 21 px, bouton seul sur une
    deuxième rangée. Après : cinq pastilles identiques, écart ramené à 4 px.
    🔴 Et la cause profonde était dans le COMPOSANT PARTAGÉ, pas sur cette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
2026-08-22 s134b: machine et formation peuvent enfin être retirées
    Le critère de sortie de la Phase G dit « chaque objet annoncé est créable,
    éditable, ARCHIVABLE depuis son workspace ». Les 111 routes d'administration
    groupées par objet et par verbe : c'était FAUX pour deux objets. `Machine` et
    `Formation` se créaient et s'éditaient et ne se retiraient jamais — une
    découpeuse revendue l'an dernier restait dans tous les catalogues, tous les
    sélecteurs de réservation et tous les calendriers, et la seule sortie était la
    base de données.
    ✅ Archivé, jamais supprimé, et ici ce n'est pas une préférence : `RESERVATION`,
    `LOG_UTILISATION` et `ACCESS_RFID_LOG` pointent sur la machine,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
2026-08-22 docs: la session est poussée — corriger l'état du dépôt
    Le brief et le mémo disaient encore « ~22 commits non poussés », ce qui aurait
    induit en erreur une session repartant à froid. Vérifié : 0 commit d'avance sur
    `origin/s129/venues-workspace`.
    ⚠️ Consigné au passage : la branche est à 158 commits d'avance sur `origin/main`.
    La fusion n'a pas eu lieu et reste une décision de l'opérateur — c'est une autre
    question que « est-ce poussé ».
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2026-08-22 S147 (2/2): la passe navigateur — géométrie, clavier, sombre, POST refusé
    La première passe lisait le HTML rendu. Celle-ci mesure l'écran. Neuf défauts
    de plus, J-11 à J-19, dont quatre bloquants.
    🔴 J-11 /machines/{id} est inutilisable sur téléphone. details.css:1488
    redéclare .machine-detail-header SANS media query, après le
    @media (max-width:1024px) de la ligne 1152 écrit pour le corriger : même
    sélecteur, même spécificité, plus bas → la correction mobile n'a jamais
    rien fait. À 375 px les pistes valent 280px 0px, le <h1> fait 0 px de
    large, 13 éléments sont hors écran dont les trois boutons, et
    overflow:hidden sur la même règle empêche mê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
2026-08-22 S147: affecter les 23 défauts à une étape, + J-22 (formulaires) et J-23 (shadow)
    Trois demandes de l'opérateur, dans l'ordre.
    1. « ajoute ces corrections à la phase » — J-20 et J-21 vont en S148, et la
    feuille de route porte maintenant **l'affectation complète J-1…J-23**. Elle
    pointait vers S147-REVUE.md sans dire où chaque défaut atterrissait ; c'est
    écrit. Rien n'est reporté hors phase : les quatre éléments parqués restent
    ceux du § 🅿️, qui sont des fonctionnalités et pas de la finition.
    2. « une passe sur les formulaires volumineux qui ne suivent pas le guide » —
    J-22. Il y en a plus que quelques-uns : **52 gabarits admin/staff portent un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
2026-08-22 J-13, J-11, J-12 : les trois corrections immédiates de la Phase J
    J-13 — NavBuilder:65. `cal.book_machine` disait « Réserver une machine » et
    pointait sur `app_calendar`, la seule surface construite avec booking:false.
    Pointe sur `app_machines`. Vérifié en ligne : le libellé mène à /machines, son
    voisin book_space à /places, et le groupe « Au programme » garde /calendrier —
    un groupe dit ce qui se passe, il ne promet pas une action.
    J-11 — details.css. La liste de pistes de `.machine-detail-header` existait deux
    fois : `400px 1fr` en tête, et `minmax(280px,420px) minmax(0,1fr)` dans une
    seconde règle SANS media query en fin de fichier, qui gagnait donc à toutes les
    larg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
2026-08-22 S148 (1/n) : J-19, J-14, J-9 partiels — et deux constats réfutés
    J-19 — la section « Prêts » de la barre latérale ouvrait le catalogue d'objets.
    Une section s'ouvre sur son PREMIER item ; les deux sont inversés. Prêter coûte
    2 clics comme toutes les autres créations, le catalogue en coûte 3 — c'est le
    bon sens : un prêt est quotidien, un objet prêtable est du paramétrage.
    J-14 — lien d'évitement. Les deux coquilles émettent `.skip-link` en premier
    élément tabulable, et **les 79 gabarits qui ouvrent un `<main>` portent
    maintenant `id="main-content" tabindex="-1"`**, donc il a toujours où atterrir.
    Vérifié : premier tabulable, activation → focus sur `<main>`.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
2026-08-22 J-7 : 10 icônes ajoutées au composant, les pictogrammes bruts remplacés
    `_icon.html.twig` passe de 8 à 18 noms : calendar, pin, compass, warning,
    lock, ticket, mail, box, tool, map. Le premier est celui qui a motivé le
    reste — le glyphe calendrier rendait un carré vide sur `/events/{id}`, dans
    la puce de date de chaque événement, prouvé à l'écran.
    Remplacés là où c'était vraiment du BALISAGE : event-detail (4),
    machine-detail, event-cancel, unsubscribe, _formation_journey, place-detail,
    maintenance, kiosk-machine, kiosk-events, _footer, staff-scan.
    ⚠️ **Le chiffre de la revue était faux et vaut correction : 155 comptait les
    commentaires CSS et JS.** Dans du vrai balis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
2026-08-22 J-15 : 101 plaques claires en thème sombre → 0
    101 règles réparties sur 13 feuilles peignaient un fond littéral clair sans
    contrepartie sombre, donc elles restaient des cartes blanchâtres sur une page
    sombre. Corrigées **par TOKEN**, pas par 101 surcharges à tenir en phase :
    · surfaces neutres → `var(--theme-surface[-elevated], <hex d'origine>)`
    · teintes sémantiques → `var(--tone-{ok,warn,stop,info,primary}-soft, <hex>)`
    ⚠️ Le hex d'origine reste en repli, donc un navigateur qui ne lit pas le token
    rend exactement ce qu'il rendait. Et les tokens de tonalité sont déjà des
    `color-mix(…, var(--theme-surface))` : ils suivent le thème tout seuls.
    🔴 **Et la mo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
2026-08-22 J-4 : le mécanisme de pluriel existe enfin — et le constat est corrigé
    ⚠️ **« 2 règles ICU plural » était faux : il y en avait ZÉRO.** Mon grep
    comptait deux clés *nommées* `unit_plural`. Aucune machinerie de pluriel
    n'existait, ce qui explique les 76 « jour(s) » du catalogue français.
    Livré : un second domaine `messages+intl-icu.LOCALE.yaml` dans les cinq
    langues. Le suffixe fait passer le domaine par `MessageFormatter` — extension
    `intl` vérifiée présente sur la boîte — qui applique les vraies règles de
    chaque langue.
    Quatre clés y passent, celles qu'un membre voit le plus : « Dans 11 jour(s) »
    devient « Dans 11 jours », « 2 réservation(s) simultanée(s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
2026-08-22 J-24 : les 69 messages de validation parlent enfin les cinq langues
    Cinq `validators.LOCALE.yaml` : 64 messages de contrainte plus les 5 vraies
    clés `venues.error.*` qui manquaient depuis toujours.
    🔴 **La clé est la phrase française elle-même.** Symfony traduit un message de
    contrainte via le domaine `validators` en prenant le message pour clé — c'est
    la forme de migration documentée, c'est ainsi que `debug:translation` les
    listait déjà, et **aucune ligne de PHP n'a eu à changer**. Les 49 contraintes
    gardent leur littéral ; les remplacer par de vraies clés est un travail de PHP
    qui pourra se faire écran par écran sans toucher à ces fichiers.
    ⚠️ La clé doit être le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
2026-08-23 J-21 : un grant suit sa catégorie par identité, plus par son nom
    `USAGE_PACKAGE_GRANT.categoryId` est écrit par l'éditeur et lu par le point de
    passage. L'écran des catégories machine fait un VRAI renommage — il déplace les
    N machines avec lui — donc un grant qui ne stockait que le libellé se retrouvait
    à nommer une chaîne à laquelle plus rien ne répondait, et refusait la
    réservation sans cause visible.
    🔴 **La sémantique a dû être corrigée une fois, et c'est le témoin négatif qui
    l'a attrapée.** Première version : la clause identifiant s'AJOUTAIT à la clause
    libellé. Or un grant qui porte les deux a, après un renommage, un libellé périmé
    **par construction*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
2026-08-23 J-8 : le compte de 15 était faux — mesuré par POST, il tombe à 1 prouvé
    🔴 **Mon propre chiffre était faux, et c'est la quatrième fois dans cette revue.**
    « 15 handlers font ressaisir la saisie » venait d'un détecteur statique cherchant
    `addFlash('error')` suivi d'un `return redirect` à moins de cinq lignes.
    Deux écrans réellement SOUMIS, et ils se contredisent :
    · `/profil`, branche « profil public » — slug invalide + biographie tapée :
    🔴 la biographie est perdue. Le défaut est réel.
    · `/admin/settings`, section « localisation » — fuseau inexistant + langue
    changée : ✅ la langue survit. L'écran enregistre champ par champ et ne
    refuse que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
2026-08-23 J-3 vraiment terminé (28 flashs de plus) et J-22 : l'assistant converti
    🔴 **Correction : « 0 flash littéral dans src/ » était FAUX.** Mon balayage ne
    reconnaissait que `addFlash('type', 'littéral')`. Il en restait **28**, cachés
    dans des `sprintf()`, des ternaires et des concaténations — « Thème publié. »,
    « %s renommée en %s : %d machine(s) déplacée(s). », « Configuration initiale
    enregistrée. », « Rendez-vous confirmé avec %s. », « La section a été mise à
    jour. »… Un balayage à arguments équilibrés les trouve ; l'ancien ne pouvait pas.
    31 clés neuves dans les cinq langues, les `sprintf` passés à la forme
    paramétrée `['flash.x', ['%p1%' => …]]`.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
2026-08-23 S147 : noter que la règle .form-field-check .form-help sort de son écran
    La conversion de l'éditeur de packages a ajouté une règle CSS qui touche tout
    écran portant une case à cocher avec un `help` — /admin/settings (3 cases) et
    /admin/emails (5) en plus de l'écran visé. Les 9 mesurées : aide sous le
    libellé, pleine largeur, aucune coupée. Une règle `.form-field*` n'est jamais
    locale.
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2026-08-24 J-5 : deux familles de CSS local rassemblées, et deux défauts que ça cachait
    708 → 653 règles locales, 39 → 37 gabarits. Mais le chiffre n'est pas l'intérêt :
    en rassemblant, deux pages se sont révélées cassées.
    ## 🔴 `/reset-password` rendait sa carte SANS aucune règle
    Les huit sélecteurs `.auth-section`, `.auth-container`, `.auth-card`,
    `.auth-header`, `.auth-title`, `.auth-subtitle`, `.auth-form`, `.auth-links` sont
    utilisés par `forgot-password` **et** `reset-password`, et n'étaient définis que
    dans le `<style>` en ligne du premier. Un `<style>` ne traverse pas les documents :
    la page où atterrit un membre verrouillé dehors n'avait ni surface, ni ombre, ni
    rembou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
2026-08-24 Outil : un `<details>` imbriqué était compté deux fois
    `form_quality.py` ajoutait les champs d'un repli intérieur une fois dans le corps
    du repli englobant, puis une seconde fois pour lui-même. L'écran des packages en a
    un — la portée d'un grant, repliée dans « Ajouter le grant » — et le total
    « replié » dépassait le total réel, donc « visible » tombait sous la vérité.
    🔴 **Trouvé par la paire A, qui a refusé de corriger l'outil qui la mesurait** et a
    écrit le correctif dans son rapport à la place. C'est la bonne réponse : on ne
    répare pas sa propre balance. Quatrième outil d'audit à mentir dans cette session,
    et le premier signalé par quelqu'un d'autre que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
2026-08-24 Quatre paires sur quatre formulaires — le travail, et ce que le chef a corrigé
    Quatre agents, un écran chacun, propriété stricte des fichiers : **aucune paire
    n'a touché aux fichiers d'une autre**, ce qui était le seul vrai risque de les
    lancer en parallèle. Trois sur quatre sont mortes en cours de route (limite de
    session) ; leur travail était en place et cohérent, mais **sans les clés de
    traduction ni le CSS qu'elles devaient me signaler** — c'est le chef qui les
    écrit, et c'est ce qui a sauvé le lot.
    ## 🔴 Ce que la mort des trois agents a failli coûter
    **56 clés de traduction référencées et inexistantes.** Livré tel quel, l'écran
    aurait affiché `admin_machine_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
2026-08-24 Règle 5 dans le thème : ~25 formulaires marquent enfin leurs champs obligatoires
    La paire A l'avait signalé et ne pouvait rien y faire : `admin_theme.html.twig`
    n'avait aucun bloc `form_label`, donc **aucun formulaire de l'application** ne
    marquait ses champs requis. C'est un fichier du chef, et une ligne ici en marque
    ~25 d'un coup.
    🔴 **Le mot est un `<span>` FRÈRE de l'étiquette, jamais dedans.** Dans le
    `<label>` il entrerait dans le NOM ACCESSIBLE du champ, qui deviendrait « Durée
    requis » — un nom n'est pas un état. Il porte donc `aria-hidden` : `<input
    required>` annonce déjà l'obligation nativement, et dans la langue de
    l'utilisateur, pas la nôtre.
    ⚠️ Et pas d'a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
2026-08-27 Revue : les quatre verdicts, et la liste de ce qui reste
    Trois relecteurs sur quatre ont rendu NOT YET. Sept défauts corrigés et déployés,
    le reste écrit écran par écran dans `S149-REVUE.md` — rien n'est cassé, mais le
    motif CRUD n'est appliqué qu'à un de ses trois écrans et la règle 4 de
    /admin/emails est calculée sans être affichée.
    🔴 **Correction sur l'accès SSH.** J'avais noté « passer par l'IP » : c'est faux
    sur la moitié des réseaux. Mesuré sur deux réseaux, résultats exactement inverses —
    sur l'un `proxmox.lab.dryades.org` ne résout pas et l'IP marche, sur l'autre
    l'inverse. **Essayer les deux avant de conclure que l'accès est perdu** : croire le
    prem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
2026-08-27 🔴 La passe navigateur : personne ne pouvait atteindre /login depuis l'école
    La seconde moitié de la revue S149, celle qu'aucune lecture ne peut faire.
    Six défauts, tous dans du balisage parfaitement correct.
    🔴 Toute redirection vers /login partait en `http://`. `framework.yaml` ne
    déclarait aucun `trusted_proxies`, donc Symfony ignorait `X-Forwarded-Proto`.
    Sur le réseau de l'école, le filtre FortiGuard bloque le http : un membre
    déconnecté, ou dont la session expirait, obtenait « Web Page Blocked » au lieu
    du formulaire de connexion. Vérifié en ligne après correction : le 302 rend
    maintenant `https://fabos.dstei.fr/login`.
    ⚠️ C'était aussi le « 403 au proxy » que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
2026-08-27 Paires A et B : deux libellés identiques, un « 0 » qui s'évaporait, deux faux positifs
    Les quatre paires codeur+relecteur sont closes. Ce qui restait, corrigé et vérifié
    sur la page rendue — et deux alertes réfutées plutôt que corrigées.
    Paire A, l'éditeur de packages :
    🔴 `window_preset` et `day_of_week` portaient le MÊME libellé. Deux listes
    voisines s'appelaient toutes les deux « Créneau », le gabarit reprenait la même
    chaîne en `aria-label` : la question « quel créneau ? » était posée deux fois et
    le jour ne se nommait nulle part. Nouvelle clé `usage_rights.grant_day` dans les
    cinq langues ; à l'écran on lit maintenant « Time slot » puis « Day ».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
2026-08-27 Six affiches de remplacement pour les événements, et la question dark/light qui s'annule
    Première moitié du todo du 2026-08-27, en PROPOSITION : `/admin/design#evenements`.
    Rien n'est posé sur `/events` — c'est la page d'exemple demandée, à regarder avant
    de décider, comme le protocole des propositions comparables le veut.
    Ce que la référence Fabmanager fait bien : remplir la moitié image d'une carte
    sans photo avec le logo du lab. Ce qu'elle fait mal, et qu'on corrige : toutes
    les cartes portent le MÊME logo, donc quinze cartes identiques. Le remède devient
    le symptôme. Six variantes suffisent à ce qu'une grille de neuf n'ait jamais deux
    voisines pareilles.
    🔴 Le tirage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
2026-08-27 « Requis » ne se dit que d'un champ qu'on peut laisser vide
    Le petit reste de R3, consigné plutôt que corrigé à la volée la semaine passée —
    et il fallait bien deux mesures, pas une.
    La règle 5 marquait tout champ `required` au sens de Symfony. Or un `<select>`
    sans option vide l'est toujours : Statut, Thème et Langue portaient « requis »
    alors qu'ils arrivent avec une valeur et qu'on ne peut pas la retirer. Mesuré
    avant : 8 mentions pour 5 champs réellement remplissables sur
    /admin/utilisateurs/new, 2 pour 1 sur /admin/places/new. Le mot promettait une
    contrainte qu'on ne peut pas enfreindre — donc il n'apprenait rien, et il usait
    celle des vrais champs obligatoires.
    ⚠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
2026-08-27 La page de recherche n'avait aucun champ de recherche
    R8 disait « le champ de l'en-tête fait 89 px à 375 px ». En allant le corriger,
    la vraie trouvaille était ailleurs : **`/recherche` n'a AUCUN champ**. La page
    affiche « Saisissez une recherche pour commencer » et n'offre nulle part où le
    faire — le seul `<input>` de la page entière était celui de l'en-tête, mesuré à
    89 px de large sur mobile, soit cinq caractères visibles. Chercher sur téléphone
    était donc à peu près impossible, et c'est la seule page où l'on vient exprès
    pour ça.
    ⚠️ `.advanced-search-box` et `.search-input-advanced` existaient déjà dans
    `style.css` et n'étaient utilisées NULLE PART : la m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
2026-08-27 Les journaux RFID imprimaient encore des mots de firmware
    Reste daté : « les cellules status / reason / color impriment encore les mots
    stockés ». Deux des trois l'étaient déjà — `status` en S141f (`_rfid_result`), la
    couleur de LED en J-6. Restait `reason`, et une lacune dans le premier correctif.
    🔴 `reason` affichait l'énumération brute : `BADGE_MATCH`,
    `REQUIRED_BADGE_MISSING`, `TRAINING_OK`, `TRAINING_REQUIRED`, `RFID_NOT_FOUND`.
    Des mots de firmware, présentés à un opérateur dans un repli intitulé « Raison ».
    🔴 Et deux valeurs héritées manquaient à la table de `_rfid_result` : `AUTHORIZED`
    (16 lignes sur 130) et `NO_TRAINING` (12) tombaient dans le repli qui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
2026-08-27 Les boutons en double des écrans RFID : réfuté, compté sur les pages rendues
    « Les deux écrans RFID montrent les mêmes deux boutons deux fois » était un
    reste daté. Il était déjà à moitié réfuté — la mémoire des pixels note « un seul
    le faisait ». Compté aujourd'hui sur les deux pages : /admin/rfid-readers porte
    « Cancel », « Close » et « Delete permanently », tous distincts et venant de sa
    modale ; /admin/access-rfid-logs porte un seul « Confirm ». Aucun doublon.
    L'item est clos par la mesure, pas par une correction — c'est la règle : une
    alerte se réfute avant d'être comptée, sinon on invente du travail.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
2026-08-28 Trois propositions pour rendre le tableau de bord distinctif
    Demande de l'opérateur du 2026-08-16 : « the old homepage looked more "special",
    we'll find a way to make it pop again later ». Le protocole que la roadmap fixe
    pour ce genre d'item est celui qui a marché pour le format de liste — des
    propositions comparables dans /admin/design, une variable à la fois, avant de
    construire quoi que ce soit. Voici le premier tour.
    Quatre cadres, la MÊME donnée dans tous les quatre (les chiffres réels de la
    boîte), pour que ce qui change d'un cadre à l'autre soit le seul point à juger :
    référence — ce qui est en ligne aujourd'hui
    A — la bande respire et porte un FAIT : « Ouve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
2026-08-28 Les documents attachés à une machine — guide d'usage, fiche de sécurité
    La demande de l'opérateur du 2026-08-27, à faire avant la Phase H. Il a passé la
    migration à 08:32 ; le code qui lit la table est parti après, jamais avant.
    Ce que ça donne : un bloc « Documents attachés » sur /admin/machines/{id}/edit
    pour téléverser et retirer, et un onglet « Documents » sur la fiche publique —
    la barre d'onglets existait déjà, l'onglet s'y ajoute.
    🔴 Ces fichiers sont PUBLICS, et l'écran d'admin le dit en toutes lettres. Ils
    vivent sous `public/uploads/`, donc leur adresse suffit à les lire. C'est le bon
    défaut pour une fiche de sécurité — elle se lit AVANT d'être fo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
2026-08-31 Phase S153 : la saisie des packages, et les propositions qu'on solde
    Ouverte avant la Phase H. Quatre chantiers : trois soldent une proposition déjà
    dessinée et validée, le quatrième est neuf.
    🔴 Règle de la phase, donnée par l'opérateur : une proposition implémentée se
    SUPPRIME — page, route, lien, section. Le raisonnement reste dans HISTORY.md et
    dans le commit, jamais dans un écran. C'est déjà la pratique du dépôt : les
    propositions du format de liste ont été retirées en S130e/S140. Une maquette
    laissée en place devient, six mois plus tard, une chose qu'on prend pour un
    composant. Chaque chantier porte sa ligne « à la livraison, retirer… ».
    1. LA SAISIE DES P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
2026-08-31 Phase S153 livrée : la saisie des packages, et les propositions soldées
    Quatre chantiers. Trois soldent une proposition déjà dessinée et validée, le
    quatrième est neuf. Détail → docs/history/phase-S153-saisie.md.
    🔴 RÈGLE DE LA PHASE — une proposition implémentée se SUPPRIME. Page, route,
    lien, section : /admin/design/packages et sa route partent, et les sections
    #packages, #evenements et #tableau-de-bord du guide de style avec elles, les
    variantes B et C non retenues comprises. Le raisonnement vit dans HISTORY.md et
    ici, jamais dans un écran.
    1. LA SAISIE DES PACKAGES — quatre axes de restriction plus une ligne
    d'extension, qui se lisent comme une phrase, et Package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
2026-09-01 S153c : filtrer la liste des utilisateurs par droit d'usage
    Demandé par l'opérateur le 2026-08-31. Un menu « Droit d'usage » dans « Affiner »
    de `/admin/utilisateurs`, qui ne s'affiche que s'il existe au moins un package —
    un `<select>` à une seule entrée « Tous » est un contrôle qui ne fait rien.
    🔴 **Les DEUX chemins d'attribution, et c'est tout l'enjeu.** Une attribution est
    personnelle (`userId`) ou collective (`groupId`) ; un filtre qui n'en verrait
    qu'un afficherait « personne » pour un package donné à une équipe entière, et
    rien à l'écran ne le dirait. `reachOf()` rend les deux.
    🔴 **Et l'appartenance à un groupe se demande à `AudienceResolver`, jamais à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
2026-09-01 S158b : les groupes d'une personne, sur sa fiche
    L'étape 2 du plan : la même appartenance que `/admin/groupes`, vue par l'autre
    bout. On pense « dans quels groupes est cette personne » aussi souvent que
    « qui est dans ce groupe ».
    ✅ UNE SEULE SOURCE D'ÉCRITURE : le même `UserGroupRepository`, les mêmes gardes,
    le même jeton. Deux vues, pas deux surfaces — un second chemin d'écriture aurait
    ses propres refus, et celui des deux qu'on oublie de corriger est celui qui
    laisse passer. C'est la leçon que S153b vient de payer sur la fiche d'un forfait.
    🔴 CHAQUE LIGNE DIT PAR OÙ ELLE PASSE, et c'est tout l'enjeu de cet écran.
    Mesuré sur le compte n°5 : « Administrateur globa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
2026-09-01 Plan S159 : l'effet de bord du commerce, et le nettoyage
    Deux ajouts au plan écrit plus tôt, tous deux demandés par l'opérateur. Rien
    d'implémenté.
    🔴 L'EFFET DE BORD SUR LE COMMERCE — et c'est le cas qui n'est pas géré.
    Un achat est individuel par nature : la Phase H vend une ligne « Forfait » à UNE
    personne qui a payé. En groupes-seuls il n'existe aucun chemin pour la lui donner,
    sauf à fabriquer un groupe d'une personne PAR ACHETEUR.
    Et ce n'est pas une gêne d'ergonomie, c'est une contradiction avec un contrat déjà
    écrit. `USAGE_RIGHTS_VISION.md` dit qu'une compensation « ne peut révoquer que
    l'attribution portant la source unique de cette ligne, JAMAIS un droit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
2026-09-02 Revue de fin de phase S158/S159 — R1 corrigé, R2 à R6 posés
    Mandat « designer d'Apple » : les PARCOURS, pas le diff. Mesuré au navigateur sur
    les écrans rendus. `docs/S159-REVUE.md`.
    🔴 R1, CORRIGÉ SUR PLACE — ON NE POUVAIT PLUS RETIRER PERSONNE D'UN GROUPE
    INTÉGRÉ. Ni depuis la fiche du groupe, ni depuis celle du membre : aucun bouton,
    et la mention disait « par son rôle » alors que `UTILISATEUR_ROLE` n'existe plus.
    La cause est le motif de toute la phase, une fois de plus. `roleKeysFor()`
    demandait « resterait-elle dans ce groupe si la ligne disparaissait ? » en lisant
    `getRoles()`. Tant que les rôles étaient une source indépendante, la question
    avait un sens ; ap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
2026-09-02 Revue S158/S159 : R2 à R6 appliqués, et R3 tranché par la mesure
    Les cinq propositions de `docs/S159-REVUE.md`, validées par l'opérateur. Chacune
    mesurée sur les PAGES RENDUES, jamais sur le diff.
    🔴 R3 — LA DATE NE S'ÉCRIT PLUS QU'À UN SEUL ENDROIT. « Jusqu'à quand » se posait
    sur l'appartenance ET sur l'attribution du forfait au groupe ; les deux
    s'appliquaient, mais rien à l'écran ne disait lequel répondait à « Sofia jusqu'au
    30 juin ». C'est la forme adoucie du défaut que la phase entière a rangé.
    ✅ Et c'est la MESURE qui tranche, pas le goût : les trois attributions de groupe
    vivantes (#73, #74, #75) n'ont aucune date. La surface retirée ne servait à
    person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
2026-09-02 Fiche d'un forfait : le résumé MENTAIT, et la page portait deux métiers
    Revue de design demandée sur `/admin/usage-rights/{id}/edit`. Trois trouvailles,
    toutes appliquées, toutes mesurées sur les pages rendues.
    🔴 LE RÉSUMÉ EN TÊTE DE PAGE ÉTAIT UNE CHAÎNE FIXE. `usage_rights.spec_sentence`
    disait « donne accès à tout, tout le temps, partout, sans limite » — rendu à
    l'IDENTIQUE sur les quatre forfaits de la boîte. Sur OpenLab, qui ouvre en
    réalité DEUX fonctionnalités le JEUDI de 13:30 à 21:00, c'était simplement faux.
    Et placé en ligne de conséquence de l'éditeur, il enseignait le contraire de ce
    que la carte contenait.
    ✅ Remplacé par `specSummary()`, calcul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
2026-09-02 La carte de saisie prend le vocabulaire du site : pastilles, hiérarchie remise
    Vu AU NAVIGATEUR, pas dans le balisage — j'avais passé la session à greper du
    HTML pendant que la plainte portait sur des pixels. Rendu de la page rapatrié,
    URLs d'assets réécrites, servi en local, mesuré dans les deux thèmes.
    🔴 LA HIÉRARCHIE ÉTAIT INVERSÉE, et c'est ça, « le nom des droits est énorme ».
    Mesuré : le nom de l'axe — « donne accès à », « quand » — en 14 px, 400, gris ;
    l'interrupteur qui porte sa VALEUR — « tout », « tout le temps » — en 16 px, 600,
    presque blanc. Le mot qui criait était donc la valeur, jamais la question, et la
    carte se lisait comme une liste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
2026-09-02 La page se recoud : une seule liste, et l'issue de secours ne s'ouvre que si on est coincé
    Suite de la revue de design, mesurée au navigateur dans les deux thèmes.
    🔴 « DÉCOUSU » AVAIT UNE CAUSE, ET C'EST MOI QUI L'AVAIS INTRODUITE. Le résumé
    calculé du commit précédent était posé en grille au-dessus de l'éditeur : compté
    sur la page rendue, les quatre mêmes libellés — « donne accès à », « quand »,
    « où », « combien » — paraissaient DEUX FOIS à 120 px l'un de l'autre, une fois
    comme réponse et une fois comme contrôle, sans que rien ne dise lequel était
    lequel. Corriger la phrase menteuse avait créé le défaut d'après : encore le
    motif de la phase.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
2026-09-02 Journal : la revue de design entre dans l'histoire de la phase
    `WORKING_BRIEF.md` repositionné au 2026-09-03 — S158/S159 livrées, revue de fin
    de phase SOLDÉE — et `history/phase-S158-S159-groupes.md` gagne la passe de
    design.
    Ce que le journal garde, parce que ça coûtera cher à réapprendre :
    🔴 un résumé qui ne LIT pas ce qu'il résume est une décoration. La phrase fixe
    disait « tout, tout le temps, partout » sur un forfait ouvert deux heures le
    jeudi, et elle était présentée comme la ligne de conséquence de l'éditeur ;
    🔴 la corriger a créé le défaut d'après — les quatre mêmes libellés deux fois à
    l'écran, à 120 px d'écart — encore le motif de toute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
2026-09-03 Journal : une garde datée se vérifie depuis CHACUN de ses lecteurs
    La leçon de la revue de code entre dans le journal de la phase. Huit commits de
    vérifications ont manqué que l'appartenance datée n'expirait pas les RÔLES, et
    c'est le POURQUOI qui vaut d'être gardé : les quatre assertions de S159g
    interrogeaient le RÉSOLVEUR, jamais l'entité, et aucune appartenance de la boîte
    ne porte de dates — donc ni la sonde ni le balayage de routes ne pouvaient le
    voir. Une garde datée se vérifie depuis chacun de ses lecteurs, pas seulement
    depuis celui qu'on vient d'écrire.
    🔴 Au passage, un DOUBLON dans ce même fichier : la section « revue de design »
    y était deux fois, 47 lig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
2026-09-03 Fuseau : le rôle SURVIT deux heures de trop — et j'avais dit l'inverse
    🔴 D'ABORD LA CORRECTION DE MON PROPRE ÉNONCÉ. Le commit précédent et le journal
    disaient qu'une échéance « tombe deux heures trop tôt ». C'est FAUX, et c'est le
    sens qui compte : mesuré, l'écart est de +2 h, donc PERMISSIF. Une appartenance
    `staff` qui finit le 30 juin à minuit accorde encore son rôle à 01:59. Se tromper
    de sens sur une expiration de sécurité, c'est décrire comme anodin ce qui ne
    l'est pas.
    ✅ ET LE DÉPÔT AVAIT DÉJÀ NOMMÉ CE DÉFAUT. `LabClock` documente la « convention
    B » — l'heure MURALE stockée telle quelle, que Doctrine rend étiquetée UTC — et
    note que le balaya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
2026-09-03 Consigné : le buster d'`admin.css` se pose dans 72 gabarits
    Proposition mesurée, PAS exécutée — elle touche 72 fichiers d'un coup et une
    globale Twig absente d'un contexte de rendu casse la page qui la lit.
    🔴 LE COÛT EST RÉEL ET IL S'EST VU CETTE NUIT : la revue de code a dû écarter
    « ~120 changements de gabarit qui ne sont que des bumps » pour trouver les huit
    vrais points. C'est ainsi qu'un vrai changement se cache dans le lot.
    ✅ ET J'AI CORRIGÉ MA PROPRE ALARME EN CHEMIN. J'ai d'abord annoncé que quatre
    busters « périmés » servaient une feuille en cache sans mes correctifs CSS.
    C'était FAUX : ces quatre-là portent des feuilles propres à une page, et leur
    date c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
2026-09-03 Dépouillement Fabmanager : leur demande n°1 est notre acquis
    `docs/FABMANAGER-ECARTS.md`, indexé dans `docs/README.md` et résumé dans la
    roadmap. 99 demandes chargées EN ENTIER avec leurs votes — le tri par défaut est
    « TRENDING », pas le nombre de votes, donc la première page induisait en erreur :
    `Advanced CMS Features` (12) et `Add SEPA payments` (6) n'y figuraient même pas.
    ⚠️ CHAQUE LIGNE « FabOS » EST VÉRIFIÉE DANS LE DÉPÔT, jamais déduite du plan.
    C'est ce qui change les conclusions :
    - **RFID, leur n°1 (18 votes, *Planned* chez eux) : construit et en service ici**
    — `RfidReader`, `AccessRfidLog`, `MachineAccessService`, deux écrans. Nous
    sommes en AVA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
2026-09-03 Trois phases écrites : gabarits d'e-mail, annonce d'événement, thèmes
    K (S160–S162), L (S163–S164), M (S165–S168), dans `ROADMAP.md`, avec pour chacune
    ce qui existe DÉJÀ — mesuré dans le dépôt, pas déduit — la tension à trancher, et
    ce qu'on mesure par session.
    🔴 PHASE K — ET LA TENSION EST DÉJÀ TRANCHÉE PAR UNE RÈGLE DE LA MAISON. Le texte
    des 23 mails n'est pas dans les gabarits : il est en CLÉS DE TRADUCTION, cinq
    langues. Or un texte écrit par l'opérateur est du CONTENU, et « on traduit l'UI,
    jamais le contenu » — donc une surcharge est PAR LANGUE, et le texte livré reste
    le repli.
    🔴 Et l'opérateur n'écrira jamais de Twig : saisir du Twig, c'e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
2026-09-04 Planches Équipement en ligne — et les trois P0 de leur revue sont VÉRIFIÉS, donc vrais
    Le second lot de l'opérateur : 8 maquettes dans
    `public/images/references/equipement/` plus DEUX documents — README et revue
    UX/sécurité — dans `docs/references/equipement/`.
    ⚠️ UN SEUL ÉCRAN POUR LES DEUX LOTS. `/admin/references-formations` devient
    `/admin/references`, avec une section Formations et une section Machines &
    boîtiers, une seule entrée de menu. Deux planches temporaires feraient deux
    choses à retirer ; chaque section part maintenant avec SA phase.
    ⚠️ Les deux documents sont RENDUS par `MarkdownDocService`, celui de la feuille
    de route, jamais recopiés dans un gabari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
2026-09-05 Le plan complet, en neuf phases ordonnées — commerce en dernier
    Toutes les phases restantes sont écrites, avec sessions, ce qu'on mesure, et une
    passe de fond dans chacune. La roadmap suit désormais l'ordre d'EXÉCUTION, et
    s'ouvre sur une table de neuf lignes : treize titres de phase ne se lisaient plus
    dans le désordre.
    🔴 LA RÈGLE QUE L'OPÉRATEUR A POSÉE, ÉCRITE EN TÊTE DES TROIS PHASES ISSUES DES
    PLANCHES : « des upgrades, pas des refontes entières ». Donc on garde les shells,
    les composants, le vocabulaire de colonnes, les droits et le thème. Une planche
    apporte une IDÉE — « la disponibilité lisible dès la carte », « une zone
    Exploitation séparée » — pas u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
2026-09-05 S169 — J-8 est clos : une saisie refusée ne se retape plus
    🔴 LE DERNIER ÉCRAN PROUVÉ DÉFAILLANT DE LA REVUE S147. Les deux refus de la
    branche « profil public » de `/profil` — adresse invalide, adresse déjà prise —
    faisaient `addFlash` puis `redirectToRoute`. L'adresse, la bio et les cases
    cochées étaient jetées : corriger un seul caractère obligeait à tout retaper. Les
    9 autres formulaires du produit rendent au lieu de rediriger ; celui-ci non.
    ✅ PROUVÉ, PAS AFFIRMÉ. `app:s147:form-probe` tape une bio reconnaissable et pose
    une adresse invalide. Avant : redirection, bio perdue. Après : **statut 200,
    aucune redirection, « typed bio echoed back in the response : Y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
2026-09-05 S169 — J-5 clos PAR LA MESURE, et la règle de lecture des planches est écrite
    🔴 J-5 SUPPOSAIT, IL NE SAVAIT PAS. « CSS local par page rendue » comptait des
    RÈGLES — 653 dans 37 gabarits — sans jamais mesurer ce qui est le vrai défaut : la
    DUPLICATION. Mesuré : **544 sélecteurs locaux distincts, et 9 seulement
    apparaissent dans plus d'un gabarit — dont 6 sont des artefacts de comptage**
    (`0%`, `100%`, `">`). Il reste UNE duplication réelle.
    ⚠️ Et je la laisse, sciemment : `.form-field textarea { min-height: 180px }` dans
    la paire `admin-lab-page-new` / `-edit`. La remonter dans `details.css`
    élargirait TOUS les textareas des pages qui chargent cette feuille — un ris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
2026-09-05 Un compte « inactif » ne se connecte plus — et j'ai cassé la prod en chemin
    🔴 LE DÉFAUT, MESURÉ. `UTILISATEUR.statut` offre `actif` / `inactif`, l'écran
    admin propose de basculer… et RIEN ne lisait cette valeur à la connexion : aucun
    `user_checker` dans `security.yaml`, un fournisseur qui charge par e-mail sans
    condition. Un compte désactivé gardait donc son accès. `inactif` le retirait des
    annuaires, des listes d'équipe et du profil public — mais pas du produit.
    ⚠️ C'est un écart d'ATTENTE avant d'être une faille : un opérateur qui désactive
    un compte croit avoir coupé l'accès, et le jour où il croit à tort, il n'y a rien
    à voir.
    ✅ Risque de fermeture mesu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
2026-09-05 S172 — un boîtier a sept états, pas un booléen
    `ReaderHealth` : archivé, désactivé, non associé, association invalide, jamais
    connecté, hors ligne, prêt. ✅ **Tout se DÉDUIT de ce qui existe déjà** — aucune
    migration, aucune colonne neuve. Les états manquants n'étaient pas absents de la
    base, ils étaient absents de l'écran.
    🔴 `isActive` N'EST PAS UN ÉTAT, C'EST UNE INTENTION — « je veux que ce lecteur
    serve ». L'état est ce qui se passe : associé ou non, vu ou non, cohérent ou non.
    La colonne « Statut » rendait le booléen, donc un lecteur ACTIF mais muet depuis
    deux mois s'y affichait « Actif », en VERT. Un voyant qui reste au vert quoi
    qu'il arrive ne r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
2026-09-05 PHASE O CLOSE — quatre sessions, et la liste de ce que le relecteur regarde
    S171 (garde fail-closed + fuite du mode d'emploi), S172 (sept états de boîtier),
    S173 (deux publics sur la fiche machine + le piège %count%), S174 (la matière
    ramenée à une source, la fiche matériau, `machineToken` retiré de l'API publique).
    ⚠️ **La liste « Ce que l'opérateur vérifie » dit OÙ regarder et QUOI voir**, une
    ligne par constat, jamais « vérifié en interne ». L'opérateur relit lui-même
    cette phase (sa demande, 2026-09-05), donc une session qui ne produit rien de
    constatable à l'écran n'a pas de ligne — et ça se voit.
    ⚠️ Deux lignes disent explicitement ce qui N'EST PAS m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
2026-09-05 S176 — un refus se corrige depuis l'incident, et l'API des boîtiers dit enfin qu'elle est éteinte
    🔴 **Le journal d'accès disait CE QUI s'est passé, jamais QUOI FAIRE.** Devant
    « Badge requis manquant », l'opérateur devait deviner seul si le problème venait
    du membre, de sa formation, de son badge ou du boîtier, puis aller le chercher
    dans un autre écran en retapant un nom. C'est la mesure de sortie de la session :
    « un refus se corrige depuis l'incident, sans chercher dans un journal ».
    **Une colonne « À faire »**, un VERBE et pas un diagnostic — la colonne d'à côté
    dit déjà l'état, et le répéter serait le même fait deux fois. La correspondance
    cause → corre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
2026-09-05 S176b — les deux composants neufs entrent dans le système de design
    ⚠️ **Un composant qui n'est pas dans `/admin/design` n'est pas réutilisable, il
    est juste réutilisé une fois.** `_cell_fix` et `_commissioning` ont été écrits
    pour les boîtiers RFID mais ne connaissent rien au RFID : le premier sert toute
    ligne qui dit qu'une chose ne va pas (maintenance en retard, prêt non rendu), le
    second toute mise en service ordonnée (un lieu, une intégration, un moyen de
    paiement).
    Chaque section montre les TROIS états qui comptent — le verbe qui mène quelque
    part, le même sans destination atteignable, et la ligne qui n'a rien à corriger —
    et écrit le défaut qui l'a fait na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
2026-09-06 S178 — annuler une réservation referme la porte, et il n'y a rien à révoquer
    🔴 **Le dessin, et c'est tout le sujet.** La feuille de route demandait « un accès
    temporaire lié à une réservation, révoqué à l'annulation ». La façon évidente
    serait d'ACCORDER quelque chose à la réservation — une ligne d'autorisation, une
    fenêtre stockée — puis de la retirer à l'annulation. Ce serait une seconde source
    de vérité sur qui peut entrer, et le jour où la révocation échoue (transaction,
    worker, bug), la porte s'ouvrirait encore pour une réservation annulée.
    ✅ **Ici rien n'est accordé : la question est reposée à chaque badge.** Une
    réservation annulée n'est plus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
2026-09-06 PHASE P CLOSE — la porte existe, elle se met en service, elle se corrige, et elle se referme
    S175 (`AccessPoint` + un boîtier peut commander une porte), S176 (l'incident
    devient actionnable, et l'API des boîtiers avoue qu'elle est éteinte), S177 (la
    carte répond avec une heure, la fiche dit par où on entre), S178 (l'accès suit la
    réservation, sans rien à révoquer).
    🔴 **Une ligne de la revue reste OUVERTE et elle est marquée comme telle** : la
    pastille « Libre à 14:00 » n'a pas pu être vue à 01h30, labo fermé. La prouver
    demandait d'écrire une réservation en production ; le classificateur a refusé, et
    il a raison. À regarder un jour ouvré — c'est la seule chose de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
2026-09-06 Outillage — un gabarit peut JUSTIFIER une affordance désactivée, avec sa raison
    Le bouton « précédent » d'un quiz est `disabled` au rendu, et c'est correct : on
    est à la question 1, il n'y a pas de précédente, et `public/js/quiz.js:229` le
    rallume dès la suivante. Le désactiver au rendu évite même un bouton qui semble
    cliquable avant que le script ne charge.
    ⚠️ **La justification vit à côté de la balise, pas dans une liste d'exceptions
    au fond de l'outil** — là-bas, personne ne la relit, et elle survit à la
    disparition du code qu'elle excusait.
    {# dead-affordance-ok: raison #}
    <button … disabled>
    🔴 **Et la raison est OBLIGATOIRE.** Un marqueur nu ser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
2026-09-07 🔴 CORRECTION — ma preuve d'égalité pour S160 mesurait le calendrier
    **Le constat.** Après le passage de la migration ce matin, la sonde de S160
    annonçait **17 gabarits sur 20 différents** — alors que la table est présente,
    vide, et qu'aucune ligne de code n'avait bougé entre les deux passes.
    🔴 **La cause est dans MON instrument, pas dans le produit.** La sonde passait
    `'start' => '10:00'` ; les gabarits font `{{ start|date('d/m/Y H:i') }}`, et Twig
    résout « 10:00 » en **aujourd'hui** à 10 h. L'empreinte changeait donc à chaque
    minuit. Le « octet à octet identique » annoncé hier était vrai — et il l'était
    pour la mauvaise raison : les deux passes tombaient le m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
2026-09-07 S161 — l'éditeur des textes d'e-mail, et les champs se DÉDUISENT du gabarit
    **Un écran par gabarit ET par langue** — parce qu'un texte réécrit par
    l'exploitant est du CONTENU, et que la règle de la maison est « on traduit l'UI,
    jamais le contenu ». Un éditeur sans langue casserait les mails anglais d'un labo
    bilingue qui n'aurait réécrit que le français.
    ✅ **Les champs disponibles sont LUS dans la source Twig**, gabarit et partiels
    compris. Une liste tenue à la main diverge du jour où quelqu'un ajoute une
    variable — et personne ne s'en aperçoit, parce que l'éditeur continue de proposer
    l'ancienne.
    ⚠️ Le scan cherche DEUX formes, et la seconde est le cas majoritai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
2026-09-07 S162 — un mot de passe oublié part MALGRÉ une surcharge cassée, et on sait pourquoi
    Phase K close. La mesure de sortie, tenue et mesurée : une surcharge
    volontairement cassée sur `password_reset` — un objet sur deux lignes, écrit en
    SQL direct — et le mail part avec le texte livré, identique au bit près, sans que
    l'objet cassé fuie dans l'en-tête, avec l'incident journalisé.
    Casser une surcharge demande de la malice, et c'est une bonne nouvelle : le texte
    de l'exploitant ne voit jamais le compilateur Twig, donc il n'y a ni boucle ni
    condition à faire échouer. Le seul défaut atteignable est un objet multi-ligne,
    et seulement par un POST fabriqué à la main. Ce n'est donc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
2026-09-07 S162 — la colonne du journal est ÉCRITE, mesuré, pas déduit de sa présence
    La migration est passée et le service redémarré. « La colonne existe » n'est pas
    « l'application l'écrit » : `markSent()` sonde son existence une fois par
    processus, donc une colonne ajoutée après le démarrage reste invisible jusqu'au
    redémarrage — exactement le cas où l'on croirait le suivi actif alors qu'il ne
    `app:s162:layout-probe --log-write` le mesure : une ligne marquée est insérée en
    statut « sent », la trace est relue telle quelle, `fallbackKeys()` la remonte, la
    ligne est supprimée et le journal rendu à son compte de départ (126).
    L'option est OPT-IN et jamais par d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
2026-09-08 S163/S164 — annoncer un événement aux membres, une fois, et savoir combien
    La demande d'origine était « notifier à la création ». Ce n'est pas ce qui est
    construit, et la raison est dans le modèle : il n'existe AUCUN état « brouillon »
    sur un événement — les seuls champs de cycle de vie sont cancelledAt et
    archivedAt, donc un événement enregistré est en ligne. Notifier à
    l'enregistrement annoncerait à tout le labo les titres provisoires et les erreurs
    de date, et un e-mail parti ne se rattrape pas. L'annonce est un geste explicite.
    Sous NEWS, jamais sous EVENT. EVENT n'est pas désabonnable, et c'est juste : il
    porte les confirmations d'inscription. Annoncer sous EVENT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
2026-09-08 S165 — la médiathèque d'identité : poser un logo sans toucher au serveur
    `site_logo_path` était une CHAÎNE : le nom d'un fichier qui devait déjà se
    trouver dans `public/images/`. Rien ne téléversait, donc mettre un logo demandait
    un accès SSH — ce qui n'est pas un thème, c'est un déploiement. Un réglage qu'on
    ne peut pas régler depuis l'écran qui le propose est une affordance morte avec
    une base de données derrière.
    Le nom du fichier téléversé n'atteint jamais le disque : le fichier s'appelle
    `<mediaId>.<ext>`, tiré au sort. Deux personnes qui envoient `logo.png` ne
    s'écrasent pas, et un nom choisi par l'utilisateur ne traverse pas le système de
    fichiers. Le nom d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
2026-09-15 S166a — les 68 couleurs de marque en dur tombent, et un outil les empêche de revenir
    Le compte de la feuille de route était faux DANS LES DEUX SENS, et c'est
    exactement pourquoi un outil valait mieux qu'un comptage à la main :
    — trop bas : « 66 » ne cherchait que `#9E1B56`, pas `rgba(158, 27, 86, …)`, qui
    est la MÊME couleur écrite autrement — quinze occurrences de plus, dont les
    puces de matière de /machines/{id} et celles de badge-detail ;
    — trop haut : il comptait des littéraux CITÉS DANS DES COMMENTAIRES, qui
    documentent une correction passée, et ceux d'event-ticket.html.twig.
    Et il avait déjà dérivé : 70 hex aujourd'hui contre 66 dix jours plus tôt.
    Le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
2026-09-18 S166c — des préréglages, pas des curseurs ; et deux logos plutôt qu'un pari
    Trois axes, trois listes FERMÉES. Un champ « rayon » laisse taper 40 px et
    transforme chaque carte en gélule ; un champ « taille du texte » laisse taper
    24 px et fait déborder chaque composant à hauteur fixe. Neuf combinaisons en
    tout, toutes visibles dans l'aperçu de S167.
    Le piège central a été trouvé en LISANT style.css, pas en livrant : sous 576 px,
    --spacing-lg/xl/2xl/3xl descendent d'un cran dans un @media. Le <style> du thème
    est émis APRÈS la feuille, à spécificité égale — un :root de thème aurait donc
    gagné partout, mobile compris, et supprimé cette réduction en silence. La de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
2026-09-19 docs: J, K, O et P sortent de ROADMAP vers docs/history/ — travail repris du worktree de la tâche de fond
    🔴 CORRECTION de ce que j'ai dit hier. J'ai annoncé que la tâche de fond
    « Écrire les entrées HISTORY » n'avait rien produit. Elle avait tout produit : un
    worktree, `Dryades/jovial-payne-d5cac1` (bca3c07), avec les QUATRE fichiers de
    phase, l'index corrigé et le ROADMAP dégraissé. Mon `git log --all --name-only`
    était suivi d'un `| tail -12`, qui a coupé J et K par ordre alphabétique — j'ai lu
    la fin d'une liste tronquée et conclu à une absence. Un outil qui tronque ment
    dans le sens du silence.
    SPLICÉ, pas mergé, et voici pourquoi : la branche part de S162 et n'a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
2026-09-23 Les champs de formulaire quittent admin.css pour components.css — déplacés, pas recopiés
    Vu au rendu du fil de formation, pas lu dans le code : sur une page PUBLIQUE, le
    formulaire sortait nu — « Your messagerequired » collés, un champ perdu à droite,
    un bouton sans style. Le seul thème de formulaire du dépôt émet `.form-field`,
    `.form-help`, `.form-errors`, `.form-actions`, `.btn-submit`, et ces classes
    n'étaient habillées que par admin.css, chargé avec l'administration seulement.
    Ma première réponse a été d'écrire un `.public-form` à part — une SECONDE copie
    des mêmes règles. L'opérateur l'a relevé : « tu ne peux pas bouger le style
    d'admin à public pour é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
2026-09-23 S182c — les bonnes réponses ne quittent plus le serveur, et le résultat dit quoi relire
    🔴 Mesuré sur la vraie page, en visiteur NON CONNECTÉ : le quiz 1 envoyait ses
    trois bonnes réponses au navigateur (`"correct": true` dans <script
    id="quiz-data">). Ces quiz valident la théorie qui ouvre l'accès aux machines.
    Le serveur recorrigeait — mais contre des réponses que la page avait déjà, et
    quand le quiz ne s'enregistrait pas, c'est le navigateur qui corrigeait seul.
    Après : 0. Mesuré sur les 53 quiz de la base par la sonde.
    Une seule vérité : `QuizScorer`. Ce qu'est une question, ce que la page en reçoit
    (jamais une réponse), comment on la corrige. `saveResult()` et la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
2026-09-23 S181b — les étapes d'un parcours se déplacent, elles ne se numérotent plus
    L'ordre d'une étape était un numéro saisi dans son formulaire : passer la 4ᵉ en
    tête voulait dire rouvrir quatre formulaires, et deux étapes au même numéro
    s'ordonnaient par leur id. Deux flèches ↑ ↓ par étape dans « Sections du
    parcours », un formulaire par flèche, sans JavaScript ; au retour la liste est
    rouverte, ancrée sur l'étape, et le focus revient sur la flèche (sur l'autre si
    celle-là s'est éteinte en bout de liste).
    JourneyOrder renumérote le parcours 1..n puis échange deux voisines, dans une
    transaction ; les blocs de page rangés dans SECTION ne bougent jamais. Le champ
    « Or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
2026-09-23 docs: Phase U — l'identité en modules (LDAP, AD, CAS, SAML/Shibboleth, OIDC), pour toutes les installations
    Demande de l'opérateur : un système d'authentification qui s'adapte à une
    myriade de cas, l'ENSEA n'étant qu'une configuration. Mesuré avant d'écrire :
    le socle OIDC existe (AUTH_PROVIDER, EXTERNAL_IDENTITY) mais n'a jamais servi
    (tables vides sur la boîte) ; aucun module LDAP/AD/CAS/SAML, et php-ldap absent ;
    la page de connexion promet un « identifiant CAS » qui n'existe pas ; aucune
    limite aux essais de mot de passe ; OIDC ne vérifie ni nonce, ni id_token, ni
    email_verified.
    Le plan : deux familles (redirection : OIDC, CAS, SAML — mot de passe jamais vu ;
    mot de pass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
2026-09-23 S194 — la recherche : chaque résultat ouvre sa fiche, pastilles par type, et « / »
    Mesuré par la sonde sur toutes les familles (53 résultats ouverts un par un) :
    3 menaient à une liste filtrée — les objets prêtables (/prets?q=…, « pas de
    page à eux », faux depuis S133) et le matériau (/materiaux?q=…, alors que la
    fiche existe). Après : 50/50 ouvrent une fiche qui répond ; les 3 créations
    attendent leur fiche (S195).
    La page de résultats s'ouvre sur des pastilles par type avec leur compte,
    groupes ancrés et comptés. « / » place le curseur dans la recherche de
    l'en-tête depuis toute page (contrôleur Stimulus, jamais pendant une saisie),
    vérifié sur le site rée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
2026-09-23 S195 — le rapport propose d'agir et ne compte plus les annulations ; chaque création a sa fiche
    Mesuré avant : le rapport équipement comptait les réservations annulées dans
    le total, les heures et le classement (15 sur 38 : +65 %), ne proposait rien,
    et ses ressources n'étaient pas des liens. Une création n'existait qu'en ancre
    dans la galerie.
    L'usage ne compte que les réservations actives (annulées affichées à part).
    « À faire » : les machines en service jamais réservées, chacune vers sa fiche ;
    un taux d'annulation ≥ 20 % → « Revoir les règles de réservation ». Le
    classement ouvre les fiches.
    Trouvé par la sonde : « en service » filtrait statut = 'active', u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
2026-09-24 docs: S190d consigné — aucun écran ne désactive un compte ; plan du bouton qui annule les réservations à venir
    Mesuré : le champ Statut n'existe qu'à la CRÉATION d'un compte, seule
    l'anonymisation passe un compte en inactif. La ligne opérateur S190 qui citait
    « le champ Statut » était fausse — corrigée. Décision de l'opérateur : la
    désactivation annule les réservations à venir, et le dit près du bouton.
    Plan détaillé pour la reprise.
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2026-09-25 S196 — le socle des modules de connexion : un contrat, un seul décideur, OIDC validé, « Connexion & annuaires » et « Tester »
    - ExternalProfile (le contrat) + ExternalIdentityService (le seul qui décide :
    decide() sans écrire, apply() sous verrou). Jamais de rapprochement par
    e-mail ; e-mail repris seulement s'il est garanti ; statut local gagne.
    - AttributeMapping : la correspondance est une configuration (préréglages
    OIDC standard et Entra ID ; chaque champ corrigeable).
    - OidcModule : id_token exigé et vérifié par JWKS (firebase/php-jwt 7.2, accord
    opérateur ; 6.11 bloquée par un avis), iss/aud/azp/exp, nonce comparé, alg
    tenu par la clé, userinfo du même sub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
2026-09-27 Phase U — un Keycloak de TEST sur le homelab (CT 210, auth-test.dstei.fr)
    tools/keycloak-test : compose (Keycloak 26.7.4, start-dev, royaume importé),
    modèle de royaume `fabos-test` (client `fabos` confidentiel + PKCE S256 ; un
    compte par cas de S196/S197 en @example.org : alice garantie, bob sans adresse,
    carol non vérifiée, frank sans nom, dave désactivé ; profil utilisateur rendu
    facultatif pour que Keycloak n'exige pas lui-même ce qui manque), et setup.sh
    idempotent qui tire les secrets SUR la boîte (600, jamais affichés, jamais dans
    le dépôt), ajoute KEYCLOAK_TEST_CLIENT_SECRET à .env.local et fait pointer
    auth-test.dstei.fr vers NPM dans /etc/hosts (CT 210 ne joint pas so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
2026-09-27 « Dernière connexion » enfin écrite — elle ne l'était par rien, pour personne
    Trouvé en vérifiant le premier compte créé par Keycloak (alice) : le champ
    était vide… comme pour les 11 comptes de la boîte. Aucun code n'appelait
    setDerniereConnexion() ; le profil disait « Jamais connecté » et la fiche admin
    « - » à tout le monde.
    SessionRegistry::stampLogin(), appelé par SessionTrackingListener::onLogin() —
    le seul endroit que traversent TOUTES les connexions (mot de passe, fournisseur
    externe, compte complété). Horodatage machine en UTC, affiché par |lab_date.
    Sonde S190 : la connexion l'écrit (vérifié, transaction annulée) ; S197 verte.
    Vérifié en base sur l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
2026-09-27 Lien de confirmation cliqué dans un navigateur connecté à un autre compte : on le dit
    Vécu avec Keycloak : le lien de carol menait au profil de bob — le navigateur
    avait encore une session de bob (ouverte à 20:23, jamais fermée). Rien n'était
    faux (le lien confirme, il ne connecte personne), mais rien ne l'expliquait.
    - Autre compte connecté : l'adresse est confirmée, on reste sur son profil, et
    le message dit « adresse X confirmée ; ce navigateur est connecté au compte Y ».
    - Compte créé par un fournisseur : « connectez-vous avec le bouton X » au lieu
    d'un champ mot de passe pré-rempli (il n'en a pas).
    - Sonde S197 : les deux cas par la vraie page d'activation. Cinq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
2026-09-30 S204 — une pièce peut exiger un badge : réserver l'exige, la porte s'ouvre au badge seul
    Demande de l'opérateur (Factory : MetalFab, WoodFab, PrintLab, une formation
    par pièce pour y entrer). Décision : à la porte, le badge SEUL suffit, pendant
    les heures d'ouverture.
    - PLACE_BADGE (migration Version20260930090000, table neuve) + PlaceBadges :
    détenir UN des badges exigés suffit (comme au lecteur d'une machine).
    - DoorAccessDecision : pièce gardée → sans badge « missing_badge » ; avec,
    pendant les heures (ScheduleResolver, heures de la pièce ou de son lieu)
    « badge_open_hours » ; hors des heures, retour à la réservation en cours.
    Pièce sans badge exigé : incha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
2026-09-30 Fiche machine repensée d'après la planche « tâche d'abord »
    En tête : titre, carte Réservation (verdict, boutons existants inchangés, lieu
    et prochain créneau), carte Votre accès (badges), photo en paysage — ou l'icône
    de catégorie par défaut via _category_icon (5 pictogrammes recopiés retirés).
    Dessous : matériaux, « Avant d'utiliser la machine », description, « État et
    maintenance » replié (exploitation : staff seulement). Onglets, calendrier,
    documents inchangés. Cartes = .detail-card ; seule la mise en page .md-* est
    neuve ; 12 règles mortes supprimées (sélecteur par sélecteur).
    Corrigé en route :
    - un membre sans la formation voyait « Machine indisponible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
2026-10-01 Propositions de pages : sous-pages du menu Développement, et la première (catalogue des espaces)
    /admin/propositions : le tri des 52 planches (docs/references/PROPOSITIONS.md)
    et une sous-page par proposition (PageProposals + site/proposals/{slug}).
    Espaces : « Libre maintenant » en tête, labo fermé dit une fois, la carte dit
    quand, bouton Réserver. Le calcul de /places sort dans PlaceCatalogue, lu par
    la page et sa proposition.
    Corrigé en vrai : un espace, un prêt ou un matériau sans photo affichait
    l'imprimante 3D (fallback_icon sur _catalogue_card). « Réserver cet espace »
    reprend son accent.
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2026-10-02 Versions : FabOS 0.4.0 — un numéro, un endroit (twig.yaml), affiché en pied de page
    Règle : 0.MINEUR.CORRECTIF jusqu'à la mise en service à l'ENSEA (1.0.0).
    docs/VERSIONS.md tient la liste ; 0.5.0 = les pages revues mises en place.
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2026-10-05 ROADMAP : Phase W — signaler une panne par QR (S205), stocks activables (S206), check-in à paliers (S207)
    Trois idées reprises de la comparaison avec FabtrackJS. Stocks : coupés par
    défaut, aucune mention quand désactivés. Check-in : la documentation de projet
    est le dernier palier, coupé par défaut, jamais obligatoire (position de
    l'opérateur).
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2026-10-05 0.6.0 (Phase W) : six fonctions activables — panne par QR, stocks, check-in à paliers, avertissements, charte, bouton Signaler
    S205–S210, chacune derrière son interrupteur (SiteFeature gagne defaultOn :
    stocks, check-in et ses paliers, charte naissent éteints). Tables neuves en
    DBAL avec isReady() fail-safe : sans la migration, tout est inerte (vérifié sur
    Artemis : pages existantes 200, routes neuves 404). Une sonde par fonction.
    Menus admin, « Je suis là » dans Activité, 246 clés en 5 langues. Plus aucune
    mention de stock hors de la fonction (libellés renommés).
    ⚠️ Migration à lancer par l'opérateur ; sondes et revue design ensuite.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
2026-10-05 0.6.0 : corrections après migration — sondes S205 à S210 vertes
    MaterialStock : ArrayParameterType (PARAM_INT_ARRAY n'existe plus dans ce DBAL).
    RouteAccessChecker : la personne entre dans la clé de mémoire (une sonde qui
    enchaîne admin puis anonyme héritait de la réponse de l'admin). fputcsv avec
    $escape explicite. Sondes : contexte d'e-mail relu en JSON, repère
    data-warning-reason (collision d'id avec les listes de badges).
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2026-10-05 Check-in : arriver après la fermeture ouvre bien une visite (jusqu'à la fin du jour)
    La fin calculée tombait à l'instant de l'arrivée quand on badgeait après
    l'heure de fermeture : « J'arrive » se répétait et « Je pars » n'apparaissait
    jamais. Trouvé par la sonde S207 relancée le soir.
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
